drewsum/LED_Panel_Controller/README.md

# LED_Panel_Controller
Controls a single 64x64 HUB75E LED Panel
