drewsum/LED_Panel_Controller/hdw/LED_Panel_Controller/LED_Panel_Controller_bom_base.xlsx

Component | References | Value | Quantity Per PCB | Digi-Key PN | Configuration
1 | BT2101 | CR1616 | 1 | P034-ND | BACKUP_RTC
2 | BT2102 | CR1616_Holder | 1 | BU1632SM-JJ-GCT-ND | BACKUP_RTC
3 | C3301 | 15pF | 1 | 587-1949-1-ND | DNP
4 | C1509 C1510 | 47pF | 2 | 311-3783-1-ND | USB
5 | C201 C404 C604 | 10nF | 3 | 399-3066-1-ND
6 | C2201 C2202 | 10nF | 2 | 399-3066-1-ND | PUSH
7 | C202 C401 C405 C601 C605 C801 C802 C901 C902 C905 C907 C909 C910 C913 C915 C1001 C1002 C1003 C1101 C1302 C1505 C1508 C1805 C1806 C1901 C1902 C1903 C1904 C1905 C2001 C2002 C2003 C2004 C2301 C2303 C2304 C2305 C2306 C2307 C2308 C3201 C3202 C3203 | 0.1uF | 43 | 490-10698-1-ND
8 | C301 C302 C303 C501 C502 C503 C701 C702 C703 C1201 C1601 C1602 C1603 | 0.1uF | 13 | 490-10698-1-ND | Telemetry
9 | C1301 | 0.1uF | 1 | 490-10698-1-ND | DNP
10 | C1404 | 0.1uF | 1 | 490-10698-1-ND | ETC
11 | C1501 C1502 C1504 C1506 C1507 | 0.1uF | 5 | 490-10698-1-ND | USB
12 | C1701 C1703 C1705 | 0.1uF | 3 | 490-10698-1-ND | SD
13 | C1801 C1803 C1804 C2302 | 0.1uF | 4 | 490-10698-1-ND | Multidrop
14 | C2101 C2103 C2104 C2105 | 0.1uF | 4 | 490-10698-1-ND | BACKUP_RTC
15 | C2203 C2204 C2207 C2208 | 0.1uF | 4 | 490-10698-1-ND | PUSH
16 | C2401 C2402 C2501 C2502 C2601 C2602 C2701 C2702 C2801 C2802 C2901 C2902 C3001 C3002 C3101 C3102 | 0.1uF | 16 | 490-10698-1-ND | SPI_FLASH
17 | C403 C603 C903 C904 C906 C908 C911 C912 C914 C916 C1004 C1005 C1807 C1808 | 10uF | 14 | 1276-1451-1-ND
18 | C1401 C1402 C1403 | 10uF | 3 | 1276-1451-1-ND | ETC
19 | C1503 | 10uF | 1 | 1276-1451-1-ND | USB
20 | C1702 C1704 | 10uF | 2 | 1276-1451-1-ND | SD
21 | C1802 | 10uF | 1 | 1276-1451-1-ND | Multidrop
22 | C2102 | 10uF | 1 | 1276-1451-1-ND | BACKUP_RTC
23 | C2205 C2206 | 10uF | 2 | 1276-1451-1-ND | PUSH
24 | C402 C406 C407 C602 C606 C607 | 10uF | 6 | 399-8153-1-ND
25 | C203 C3302 | 100uF | 2 | 718-1102-1-ND
26 | D201 | 24V | 1 | SMAJ24CALFCT-ND | DNP
27 | D1401 | BAT48JFILM | 1 | 497-5711-1-ND | ETC
28 | D401 D601 | BAT48JFILM | 2 | 497-5711-1-ND
29 | D1701 | Green | 1 | 1497-1219-1-ND | SD
30 | D1901 D1902 D1903 D1905 D2001 D2301 D2303 D2304 D2305 D2306 D2307 D2308 | Green | 12 | 1497-1219-1-ND
31 | D2302 | Green | 1 | 1497-1219-1-ND | Multidrop
32 | D2401 D2501 D2601 D2701 D2801 D2901 D3001 D3101 | Green | 8 | 1497-1219-1-ND | SPI_FLASH
33 | D1904 D2002 D2003 D2004 | Red | 4 | 1497-1174-1-ND
34 | D1702 | SP0505BAJT | 1 | F3160CT-ND | SD
35 | D801 D3301 D3302 D3303 | SP0505BAJT | 4 | F3160CT-ND
36 | D1501 | Yellow | 1 | 1497-1198-1-ND | USB
50 | J1802 | Force SS | 1 |  | NONE
51 | J202 J203 | Keystone_8191 | 2 | 36-8191-ND | DNP
52 | J3302 | Keystone_8191 | 1 | 36-8191-ND
53 | J1701 | Micro_SD_Card_Det_Hirose_DM3AT | 1 | HR1964CT-ND | SD
54 | J1801 | Multidrop Expansion | 1 | 732-2096-ND | Multidrop
55 | J801 | PICKIT4 | 1 |  | DEV
56 | J1201 J1203 | PIC_UART | 2 |  | DNP
57 | J3301 | Panel Data | 1 | S9196-ND
58 | J1501 | USB_B_Mini | 1 | 732-2109-1-ND | USB
59 | J1204 J1205 J1206 | WIFI_SPI | 3 |  | DNP
60 | L401 L601 | 2.2uH | 2 | 541-1236-1-ND
61 | L801 L802 L901 L902 L1001 L1002 | 600R 0.5A | 6 | 490-5441-1-ND
62 | L1501 L1502 | 600R 0.5A | 2 | 490-5441-1-ND | USB
63 | L1701 | 600R 0.5A | 1 | 490-5441-1-ND | SD
64 | MK3403 MK3404 MK3407 MK3408 | Screw | 4 | 36-9900-ND | DEV
65 | MK3401 MK3402 MK3405 MK3406 | Standoff | 4 | 1772-1220-ND | DEV
66 | Q401 Q601 Q801 | BSS214NW | 3 | BSS214NWH6327XTSA1CT-ND
67 | Q402 Q602 | ZXMS6004FFTA | 2 | ZXMS6004FFCT-ND
68 | R1104 | 0 | 1 | RMCF0402ZT0R00CT-ND | Multidrop
69 | R209 R210 R211 R408 R409 R410 R608 R609 R610 R1512 R1513 R1514 | 0 | 12 | RMCF0402ZT0R00CT-ND | ~Telemetry
70 | R1813 | 0 | 1 | RMCF0402ZT0R00CT-N | MODULE0
71 | R1814 | 0 | 1 | RMCF0402ZT0R00CT-N | MODULE1
72 | R1815 | 0 | 1 | RMCF0402ZT0R00CT-N | MODULE2
73 | R1816 | 0 | 1 | RMCF0402ZT0R00CT-N | MODULE3
74 | R1817 | 0 | 1 | RMCF0402ZT0R00CT-N | MODULE4
75 | R402 R405 R605 | 0 | 3 | RMCF0402ZT0R00CT-ND
76 | R208 R407 R607 R1511 | 0.02 | 4 | P16010CT-ND | Telemetry
77 | R801 R803 R1003 R1004 R1702 R1709 R1710 R1711 R2409 R2509 R2609 R2709 R2809 R2909 R3009 R3109 R3201 R3202 R3203 R3204 R3205 R3206 R3207 R3208 R3209 R3210 R3211 R3212 R3213 R3214 R3249 R3250 R3251 R3252 R3253 R3254 R3255 R3256 R3257 R3258 R3259 R3260 R3261 R3262 | 10 | 44 | RMCF0402FT10R0CT-ND
78 | R207 R213 R406 R411 R606 R611 R1202 R1510 R1517 | 10 | 9 | RMCF0402FT10R0CT-ND | Telemetry
79 | R1204 R2402 R2403 R2404 R2502 R2503 R2504 R2602 R2603 R2604 R2702 R2703 R2704 R2802 R2803 R2804 R2902 R2903 R2904 R3002 R3003 R3004 R3102 R3103 R3104 | 10 | 25 | RMCF0402FT10R0CT-ND | SPI_FLASH
80 | R1206 | 10 | 1 | RMCF0402FT10R0CT-ND | ETC
81 | R1208 | 10 | 1 | RMCF0402FT10R0CT-ND | Multidrop
82 | R1210 | 10 | 1 | RMCF0402FT10R0CT-ND | BACKUP_RTC
83 | R1515 R1516 | 27 | 2 | RMCF0402FT27R0CT-ND | USB
84 | R1809 R1810 R1811 R1812 | 120 | 4 | RMCF0402FT120RCT-ND | Term
85 | R1501 | 1k | 1 | RMCF0402FT1K00CT-ND | USB
86 | R1701 | 1k | 1 | RMCF0402FT1K00CT-ND | SD
87 | R204 R215 R216 R217 R805 R1902 R1903 R1904 R1905 R1906 R2003 R2004 R2007 R2008 R2304 R2306 R2310 R2311 R2312 R2315 R2316 | 1k | 21 | RMCF0402FT1K00CT-ND
88 | R2201 R2202 R2203 R2204 | 1k | 4 | RMCF0402FT1K00CT-ND | PUSH
89 | R2305 | 1k | 1 | RMCF0402FT1K00CT-ND | Multidrop
90 | R2401 R2501 R2601 R2701 R2801 R2901 R3001 R3101 | 1k | 8 | RMCF0402FT1K00CT-ND | SPI_FLASH
91 | R1503 | 6.04k | 1 | RMCF0402FT6K04CT-ND | USB
92 | R202 R205 R206 R212 R218 R219 R220 R221 R401 R403 R404 R601 R602 R603 R604 R802 R804 R1001 R1002 R1005 R1006 R1101 R1102 R1103 R1201 R1203 R1205 R1207 R1209 R1703 R1704 R1705 R1706 R1707 R1708 R1801 R1802 R1803 R1804 R1805 R1806 R1807 R1808 R1818 R1901 R2001 R2002 R2005 R2006 R2103 R2209 R2210 R2301 R2302 R2303 R2307 R2308 R2309 R2313 R2314 R2408 R2508 R2608 R2708 R2808 R2908 R3008 R3108 R3215 R3216 R3217 R3218 R3219 R3220 R3221 R3222 R3223 R3224 R3225 R3226 R3227 R3228 R3229 R3230 R3231 R3232 R3233 R3234 R3235 R3236 R3237 R3238 R3239 R3240 R3241 R3242 R3243 R3244 R3245 R3246 R3247 R3248 | 10k | 102 | RMCF0402FT10K0CT-ND
93 | R1507 | 10k | 1 | RMCF0402FT10K0CT-ND | USB
94 | R214 | 10k | 1 | RMCF0402FT10K0CT-ND | DNP
95 | R2205 R2206 R2207 R2208 | 10k | 4 | RMCF0402FT10K0CT-ND | PUSH
96 | R2405 R2406 R2407 R2505 R2506 R2507 R2605 R2606 R2607 R2705 R2706 R2707 R2805 R2806 R2807 R2905 R2906 R2907 R3005 R3006 R3007 R3105 R3106 R3107 | 10k | 24 | RMCF0402FT10K0CT-ND | SPI_FLASH
97 | R1504 | 40.2k | 1 | RMCF0402FT40K2CT-ND | USB
98 | R201 R203 R1505 R1506 R1508 R1509 | 100k | 6 | RMCF0402FT100KCT-ND
99 | R413 R613 | 180k | 2 | RMCF0402FT180KCT-ND | DNP
100 | R2102 | 220k | 1 | RMCF0402FT220KCT-ND | BACKUP_RTC
101 | R1502 | 487k | 1 | RMCF0402FT487KCT-ND | USB
102 | R412 | 562k | 1 | RMCF0402FT562KCT-ND | DNP
103 | R612 | 953k | 1 | RMCF0402FT953KCT-ND | DNP
104 | R2101 | 1.07M | 1 | RMCF0402FT1M07CT-ND | BACKUP_RTC
106 | SW801 | MRST | 1
107 | U3202 U3203 | 74HCT541 | 2 | 296-26499-1-ND
108 | U1001 | 74LVC1G97 | 1 | 1727-1772-1-ND
109 | U401 U601 U1102 | 74LVC1G97 | 3 | 1727-1772-1-ND
110 | U1701 | 74LVC1G97 | 1 | 1727-1772-1-ND | SD
111 | U1702 | 74LVC1G97 | 1 | 1727-1772-1-ND | SD
112 | U1803 | 74LVC1G97 | 1 | 1727-1772-1-ND | Multidrop
113 | U1804 U2302 | 74LVC1G97 | 2 | 1727-1772-1-ND | Multidrop
114 | U1901 U1902 U1903 U1905 | 74LVC1G97 | 4 | 1727-1772-1-ND
115 | U1904 | 74LVC1G97 | 1 | 1727-1772-1-ND
116 | U2001 U2002 U2003 U2004 U2301 U2303 U2304 U2305 U2306 U2307 U2308 | 74LVC1G97 | 11 | 1727-1772-1-ND
117 | U2203 U2204 | 74LVC1G97 | 2 | 1727-1772-1-ND | PUSH
118 | U2401 U2501 U2601 U2701 U2801 U2901 U3001 U3101 | 74LVC1G97 | 8 | 1727-1772-1-ND | SPI_FLASH
119 | U3201 | 74LVC1G97 | 1 | 1727-1772-1-ND
120 | U1302 | AT24CS32-STUM | 1 | AT24CS32-STUM-T
121 | U2201 U2202 | AT42QT1010-TSHR | 2 | AT42QT1010-TSHRCT-ND | PUSH
122 | U1401 | DS1683 | 1 | DS1683S+-ND | ETC
123 | U2101 | DS3231MZ | 1 | DS3231MZ+-ND | BACKUP_RTC
124 | U1502 | FT234XD | 1 | 768-1178-1-ND | USB
125 | U301 U501 U701 U1601 | INA219BxDCN | 4 | 296-46420-1-ND | Telemetry
126 | U1301 | LTC1694 | 1 | LTC1694CS5#TRPBFCT-ND | DNP
127 | U302 U502 U702 U1201 U1602 | MCP9804 | 5 | MCP9804T-E/MCCT-ND | Telemetry
128 | U1101 | PIC32MZ2048EFG100_IPF | 1 | PIC32MZ2048EFG100-I/PF-ND
129 | U1801 U1802 | SN65MLVD3 | 2 | 296-21314-1-ND | Multidrop
130 | U2402 U2502 U2602 U2702 U2802 U2902 U3002 U3102 | SST25VF080B | 8 | SST25VF080B-50-4I-S2AE-T | SPI_FLASH
131 | U1805 | THVD1552 | 1 | 296-51654-1-ND | Multidrop
132 | U1501 | TLV6700 | 1 | 296-51696-1-ND | USB
133 | U2102 | TLV6700 | 1 | 296-51696-1-ND | BACKUP_RTC
134 | U1504 | TPD3S014DBVR | 1 | 296-38835-1-ND | USB
135 | U201 | TPS26600RHFT | 1 | 296-45478-1-ND
136 | U402 | TPS62132 | 1 | 296-29936-1-ND
137 | U602 | TPS62133 | 1 | 296-30225-1-ND
138 | U1503 | TXB0102DCU | 1 | 296-22862-1-ND
139 | X1001 | ASE-8.000MHz | 1 | 535-9558-1-ND
140 | X1002 | ECS-327KE | 1 | XC1751CT-ND
Component Groups:
Component Count:
Fitted Components:
Number of PCBs:
Total components:
Schematic Version:
Schematic Date:
PCB Variant:
BoM Date:
Schematic Source:
KiCad Version:
