drewsum/LED_Panel_Controller/(threads)

Thread 3 (2020-09-08):

Add SD card slot? To add arbitrary number of images?

drewsum, 2020-09-08:

drewsum, 2020-09-16:
Some dude bro bascially already figured this out for us:

https://www.aidanmocke.com/blog/2018/09/04/spi-fatfs/
https://www.aidanmocke.com/blog/2018/09/01/spi-sd/
https://www.aidanmocke.com/blog/2019/01/09/DMA-SD/

drewsum, 2020-09-20:
http://ww1.microchip.com/downloads/en/Appnotes/00002587A.pdf

Closed 2020-09-21.

Thread 4 (2020-09-09):

Input EMI filter?

drewsum, 2020-09-09:

logwai, 2020-09-13:
yes we hate emi

Closed 2020-09-21.

Thread 5 (2020-09-10):

Use CP2105 USB to DUART bridge instead of FT234X?

drewsum, 2020-09-10:
This would allow us to talk to both the MCU and the ATWINC wifi module over one USB cable, but this is riskier

drewsum, 2020-09-21:
Yo log give both these chips a lookover. FT234X is what we used on senior design and is what I've used ever since. We potentially have two devices on this board that could talk with a host PC (PIC32MZ MCU, and ATWINC1500 WiFi module). The CP2105 is pretty much the same as the FT234X, but you can talk with two devices through one USB port (FT234 can only talk with one). This way, we could communicate with both devices over one USB cable at the same time. This is riskier since I've never used this chip before, but we could figure it out I think. Downside is if something goes wrong, we may not be able to communicate with any devices (would warrant a board respin since a lot of this project revolves on functioning USB communication).

Look these chips over and lmk what you think. If we end up going with this, I'll make the symbol and you can draw the circuit.

drewsum, 2020-10-04:
This is pretty much drawn, but we need to look into level shifting/UART buffering

Closed 2021-02-01.

Thread 10 (2020-09-21):

Finish Panel Data Level Shifter sheet

drewsum, 2020-09-21:
We should add the nets to the level shifter sheet to connect the level shifter to both the PIC and the LED panel connector. If you look at my branch (drew_brach), you should be able to see the net naming convention for all the signals that go to the panel connector. The nets to the "right" of the level shifter should match the nets on the connector sheet, and the nets to the "left" (before level shifting) should be the same name, without the "_POS5" ending (I would say either make the names match without *_POS5 ending, or make them match with a *_POS3P3 ending since these nets will be at a +3.3V logic level). We did something similar in senior design.

It doesn't really matter which signals go where since we may re-arrange them when we're laying out the board to optimize signal flow. As long as we have a good representation of the six RGB signals, the five ROW signals, and CLK, ~OE, and LAT, we're good.

drewsum, 2020-09-21:
also consider adding pulldown resistor array on the output nets of the level shifter that matches input signals. This may not be necessary since as long as the level shifter is enabled, the signals won't float. Having pulldowns on the output would be good design practice though.

Closed 2021-02-01.

Thread 12 (2020-09-21):

Schematic Wrap up

drewsum, 2020-09-21:
This issue serves as a reminder for everything we'll have to do to transition from schematic work to actually laying out the PCB.

We need to:
* Decide on passive component sizes (0603? 0402?)/Assign these attributes to all components
* Determine if we want to optimize BOM or just throw a ton of unique parts on the board
* Ensure schematic sheets are in the right order
* Assign references designators to all components
* Assign Digi-Key PN's
* Assign component footprints/download/create custom footprints
* Electrical rules check
* Assign I2C addresses for devices with adjustable addressing
* Generate netlist

Closed 2021-02-01.

Thread 7 (2020-09-21):

Draw WiFi module sheet

drewsum, 2020-09-21:
I'll make a symbol for the ATWINC1500, and you can draw the circuit around it if you'd like. SPI/UART interface.

http://ww1.microchip.com/downloads/en/DeviceDoc/ATWINC15x0-MR210xB-IEEE-802.11-b-g-n-SmartConnect-IoT-Module-Data-Sheet-DS70005304C.pdf

https://www.microchip.com/wwwAppNotes/AppNotes.aspx?appnote=en609327

Closed 2021-02-01.

Thread 9 (2020-09-21):

Determine PIC32MZ SKU, determine I/O pin mappings

drewsum, 2020-09-21:
We need to determine which exact PIC32MZ part we'll use (pin count, memory size, speed grade). Once this is added to the schematic, we should determine which signals will go to which pins, and how peripheral pin select (PPS) will be mapped. Certain peripherals/SPI ports/I2C/UART/whatever will go to certain pins, and we could optimize that based on layout or where signals would naturally want to go.

drewsum, 2020-09-21:
We also need to ensure that the nOE signal that goes to the panel is driven from a PWM pin on the PIC, to allow us to dim the panel using PWM

Closed 2021-02-01.

Thread 16 (2021-02-01):

Hardware Ideas

drewsum, 2021-02-01:
* ~~include panel control signals in PMP bus if possible to try to further integrate functionality into DMA~~
* ~~Make as much complex functionality hardstrap configurable to gut it when building a ton of these~~
* ~~These can probably be put into larger arrays and controlled with python through USB, or through WiFi~~
* ~~Add an easier way of connecting +12V than a barrel jack, since you can use 12V power supplies in arrays~~
* ~~Add notes for each PPS/Peripheral pin mapping on PIC32MZ sheet~~
* ~~Try to BOM scrub as much as possible for ease of PNP assembly~~
* ~~These will need a faster serial baud rate over USB. Make sure the hardware you chose can support this, along with PutTy~~
* ~~Add test points for all serial busses, there are a lot of them~~
* ~~Add WiFi slave select LEDs~~
* ~~Add a small I2C eeprom to store random NVM configuration data~~
* ~~Add LED driven off ATWINC1500 GPIO to prove it's talking with host~~
* ~~Add a pullup on WIFI_IRQ since this is active low. Keep a pull in both directions, just depop pull down~~
* ~~Consider switching back to a 200MHz FOSC PIC32MZ SKU, since this is way more applicable and probably cheaper than the 252MHz SKUs~~
* ~~Add LED drivers for various features being activated, like SD card slave select, etc~~
* ~~Add ambient temperature sensor~~

drewsum, 2021-03-25:
* Add OSEP FTDI 01 headers for PIC UART and WIFI UART like on pulse oxymieter? This would drive up complexity, and I'm not sure of the cost savings anyway, since CP2105 is really cheap

drewsum, 2021-03-30:
* Add hardware debouncing on SD card detection

drewsum, 2021-03-30:
* Consider MRAM instead of SPI flash
https://www.digikey.com/en/products/detail/everspin-technologies-inc/MR256A08BYS35/2665198

drewsum, 2021-03-31:
* Try to eliminate 100 ohm resistors

Closed 2021-05-04.

Thread 17 (2021-02-02):

Schematic Review

drewsum, 2021-02-02:
Check pinout and footprint on:
* ~~PIC~~
* ~~CP2105~~
* ~~UART level shifter~~
* ~~SD card socket~~
* ~~WIFI module~~
* ~~SPI flash~~
* ~~Panel level shifters~~
* ~~Panel connector~~

drewsum, 2021-02-02:
Do a sanity check on the following sheets:
* WiFi module
* USB UART bridge
* SPI Flash
* PIC32MZ, bypass
* SD Card Slot
* Panel Level Shifters
* Panel Connector

drewsum, 2021-02-05:
Verify PMP write signal is correct on PIC32MZ

drewsum, 2021-03-05:
Need to add an OR gate with PWM dimming signal/normal OE signal. Look at older project

drewsum, 2021-03-31:
* Verify MCLR voltage during programming for ESD protection diodes

drewsum, 2021-04-01:
* change to pullups on all SPI flash signald

Closed 2021-05-04.

Thread 18 (2021-05-07):

Adjust power supply layout with GND shielding around switch node

drewsum, 2021-05-07:
* Add some GND flood on top layer around switch node, and add vias to GND plane. This should mitigate EMI

Closed 2021-06-11.

Thread 20 (2021-05-08):

Panels (matches legacy project)

drewsum, 2021-05-08:
Use these, this is what was used for senior design: https://www.aliexpress.com/item/32830509434.html?spm=2114.10010108.1000023.5.4dcb3853xRdJUH

drewsum, 2021-05-08:
This should match the cutout locations in the PCB for the power header

Thread 23 (2021-08-13):

ECOs/Gotchas

drewsum, 2021-08-13:
* LED Panel Signal Level Shifter had shift enable signal left floating from MCU... had to be shorted to ground to send signals from MCU to panel
* I2C EEPROM (U1302) was replaced with 24AA02UIDT-I/OT for availability reasons
