drewsum/LED_Panel_Controller/hdw/LED_Panel_Controller/LED_Panel_Controller.pdf

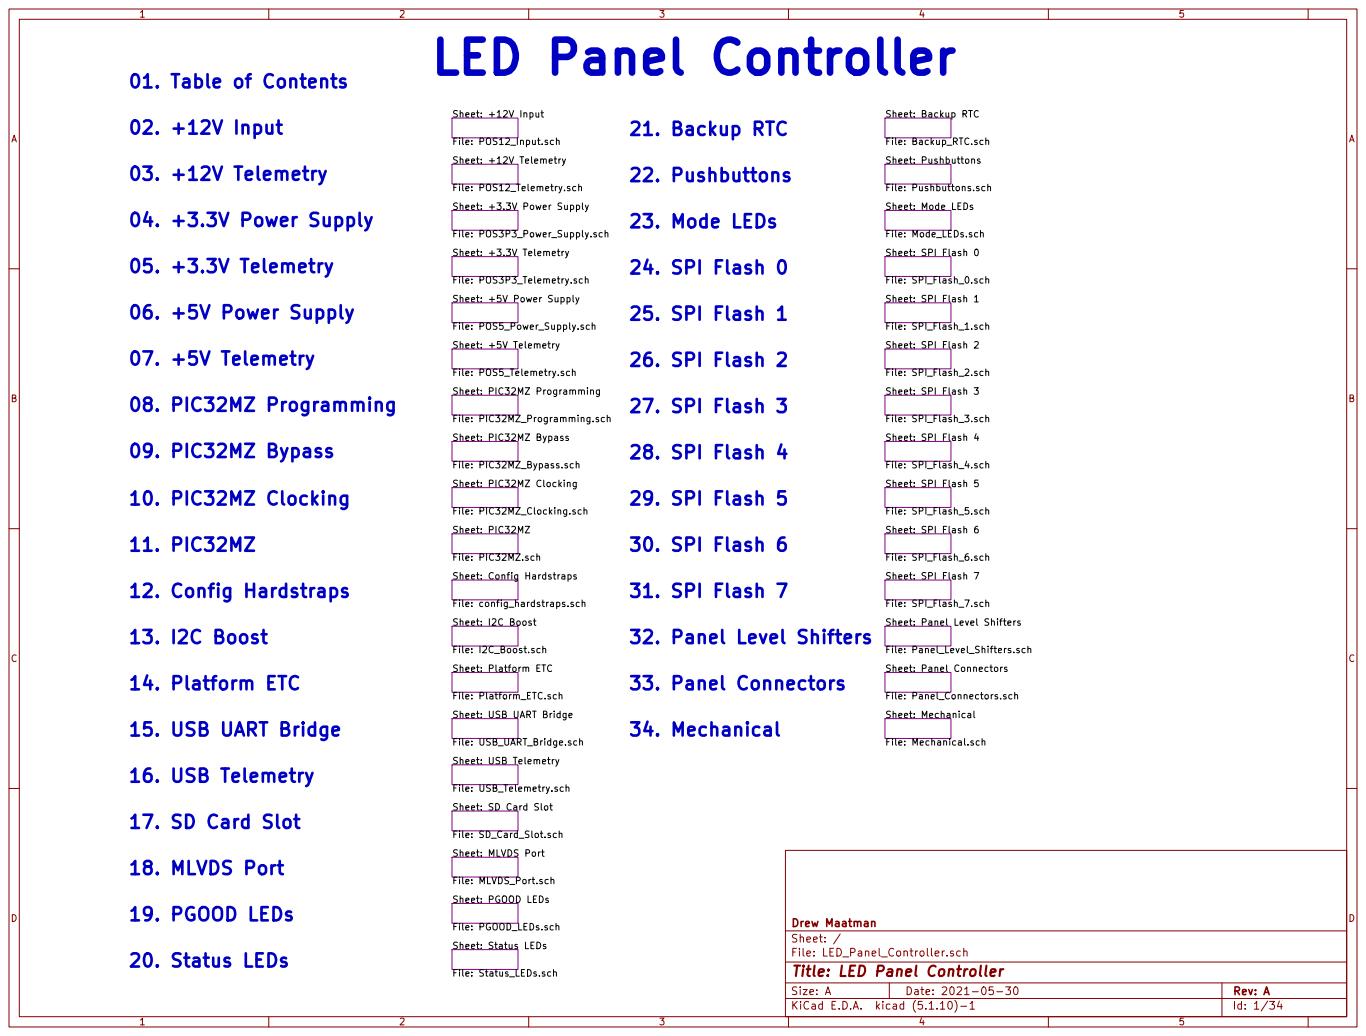
[picture p1: page 1]

Sheet: +12V Input
File: POS5_Power_Supply.sch Sheet: I2C Boost File: I2C_Boost.sch Sheet: Platform ETC
Sheet: +5V Telemetry

File: PIC32MZ_Bypass.sch
Sheet: SPI Flash 5 File: SPI_Flash_5.sch Sheet: Status LEDs File: Status_LEDs.sch

File: PIC32MZ.sch Sheet: PIC32MZ Clocking

File: Platform_ETC.sch Sheet: USB UART Bridge

File: USB_UART_Bridge.sch
Sheet: PGOOD LEDs File: PGOOD_LEDs.sch Sheet: USB Telemetry

File: USB_Telemetry.sch Sheet: SD Card Slot File: SD_Card_Slot.sch 16. USB Telemetry

File: LED_Panel_Controller.sch Sheet: / Drew Maatman

Id: 1/34 Title: LED Panel Controller

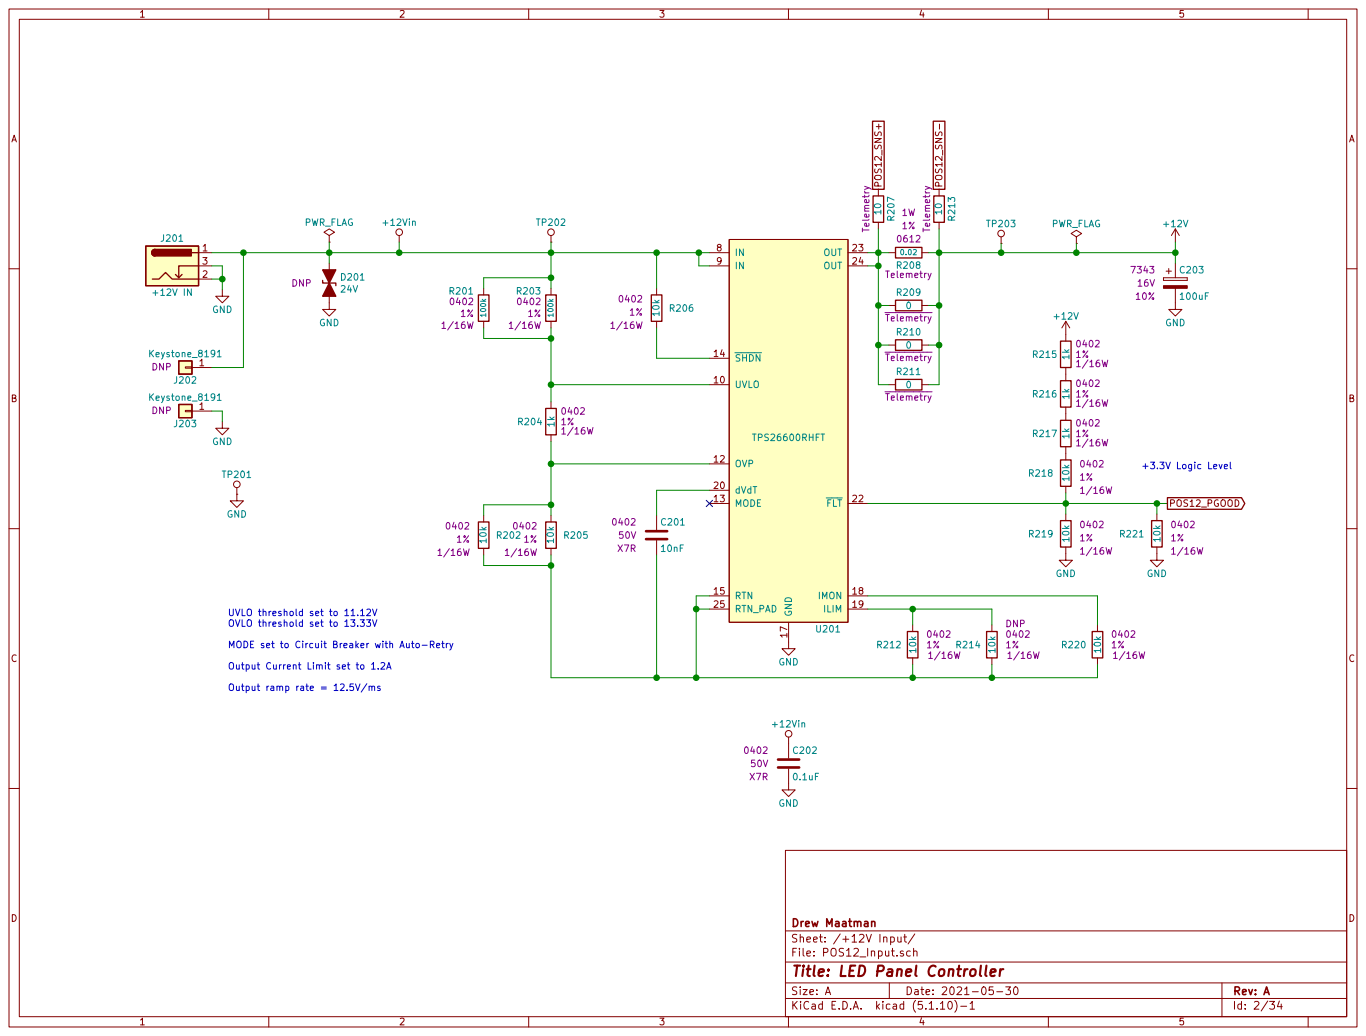
[picture p2: page 2]

+3.3V Logic Level UVLO threshold set to 11.12V OVLO threshold set to 13.33V MODE set to Circuit Breaker with Auto-Retry

Output Current Limit set to 1.2A

Output ramp rate = 12.5V/ms

File: POS12_Input.sch
Id: 2/34 Title: LED Panel Controller

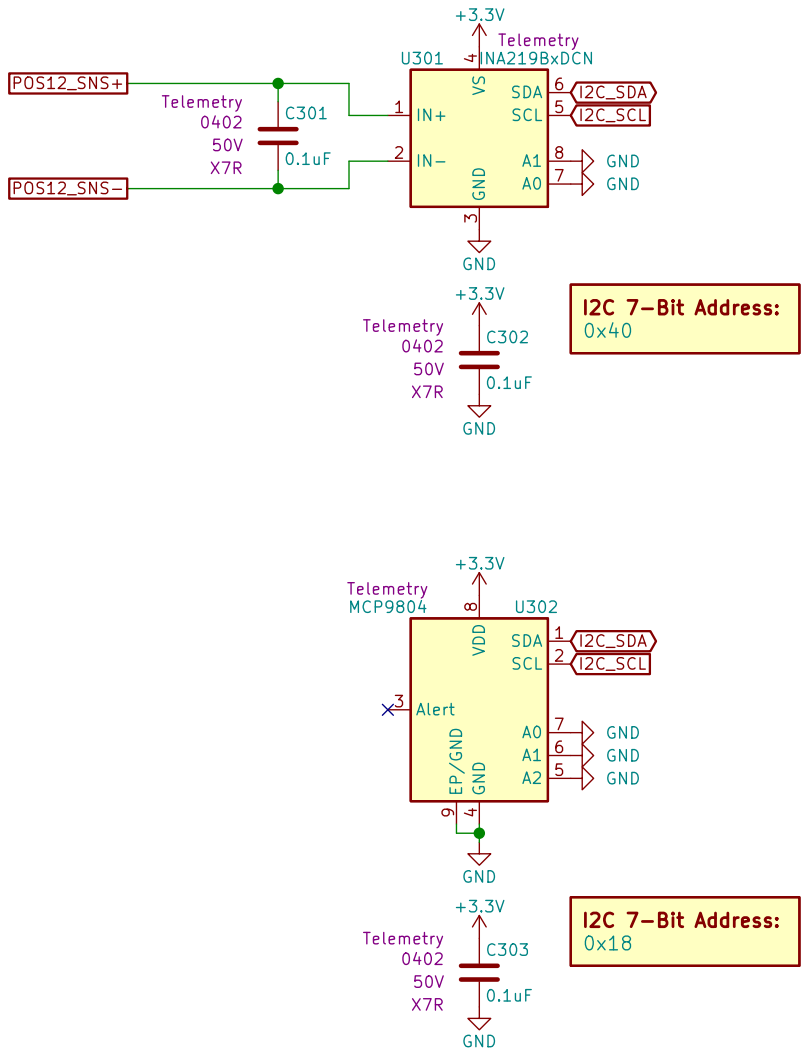
[picture p3: page 3]

Sheet: /+12V Telemetry/ Drew Maatman

File: POS12_Telemetry.sch
Id: 3/34 Title: LED Panel Controller

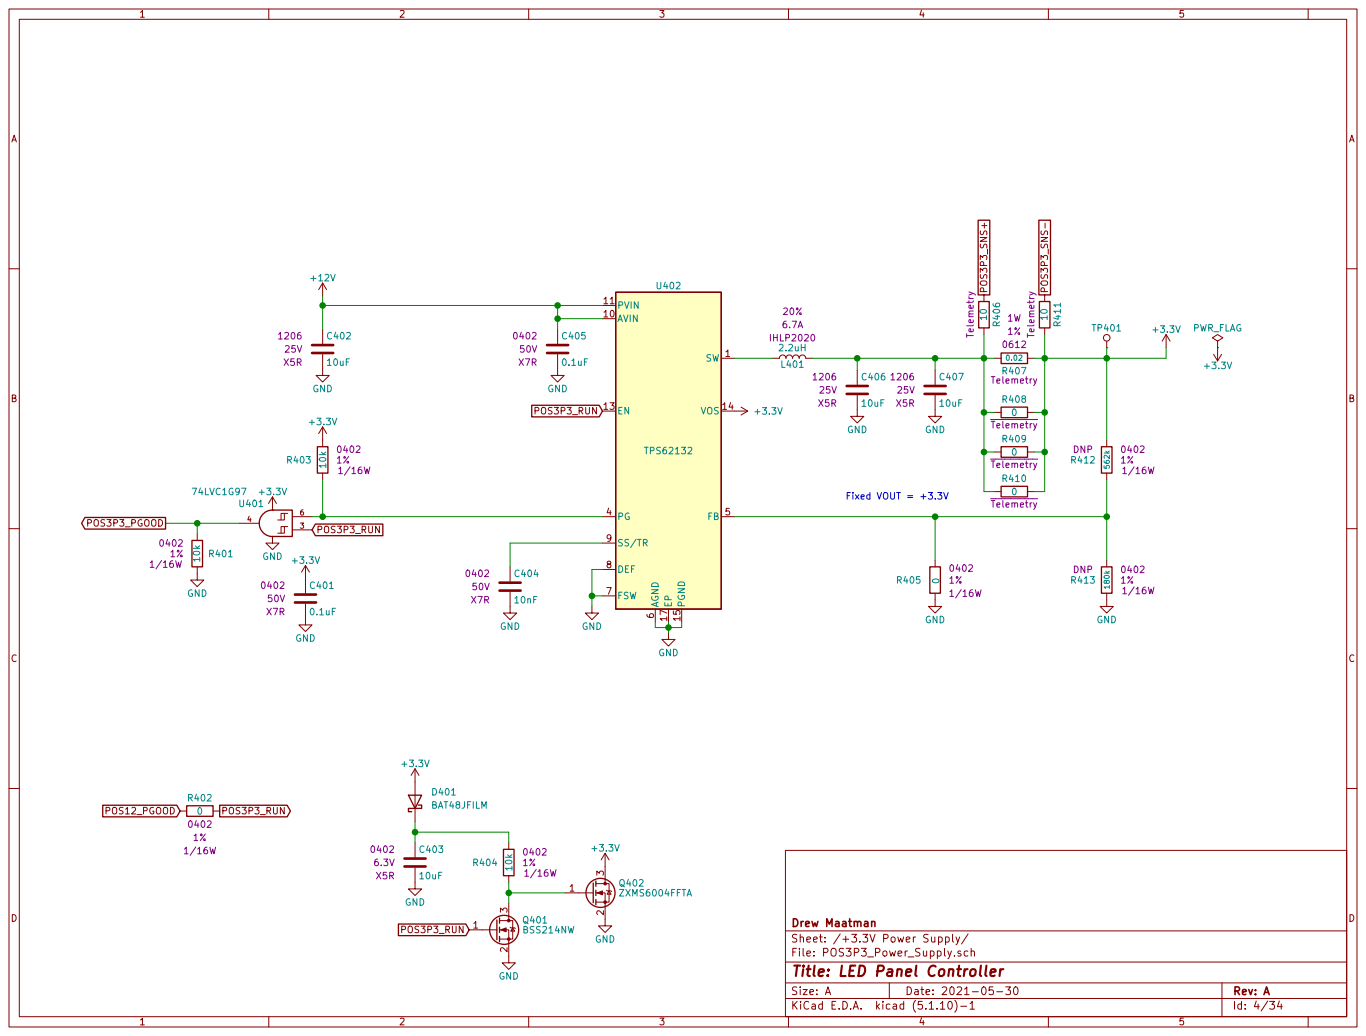
[picture p4: page 4]

6 FSW 7 DEF 8 SS/TR 9 U402 TPS62132 C403 +3.3V

0 Telemetry GND GND GND

File: POS3P3_Power_Supply.sch
Id: 4/34 Title: LED Panel Controller

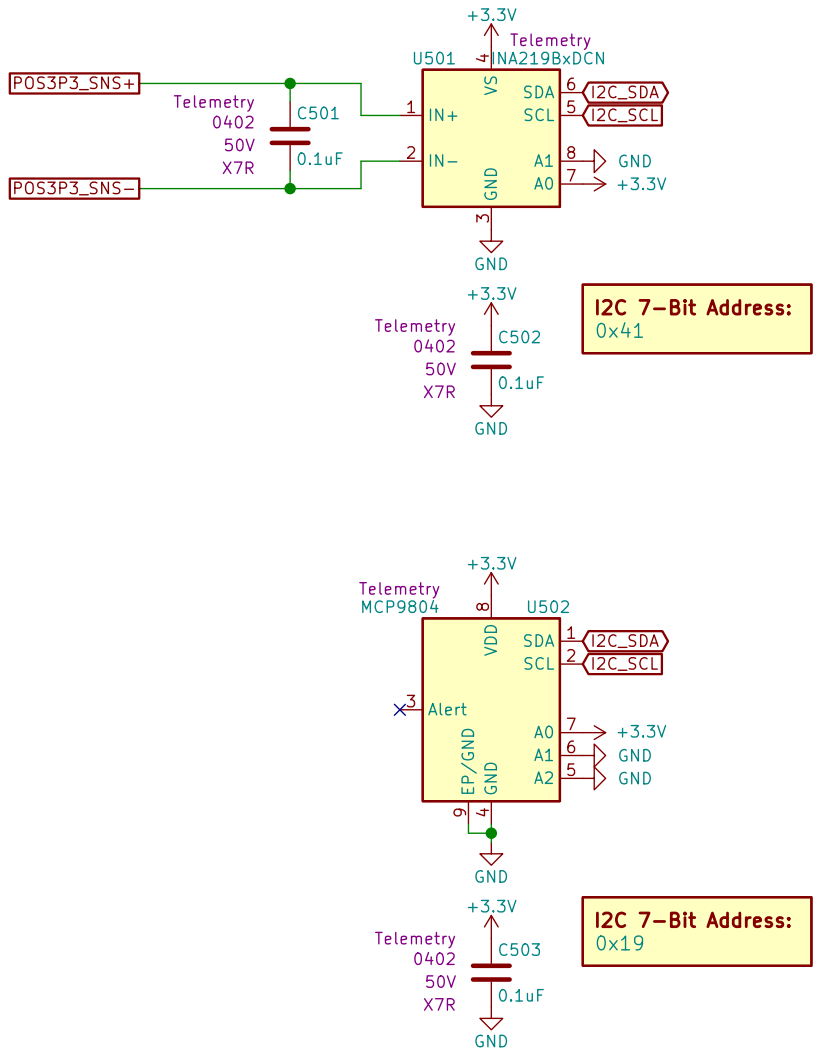
[picture p5: page 5]

Sheet: /+3.3V Telemetry/ Drew Maatman

File: POS3P3_Telemetry.sch
Id: 5/34 Title: LED Panel Controller

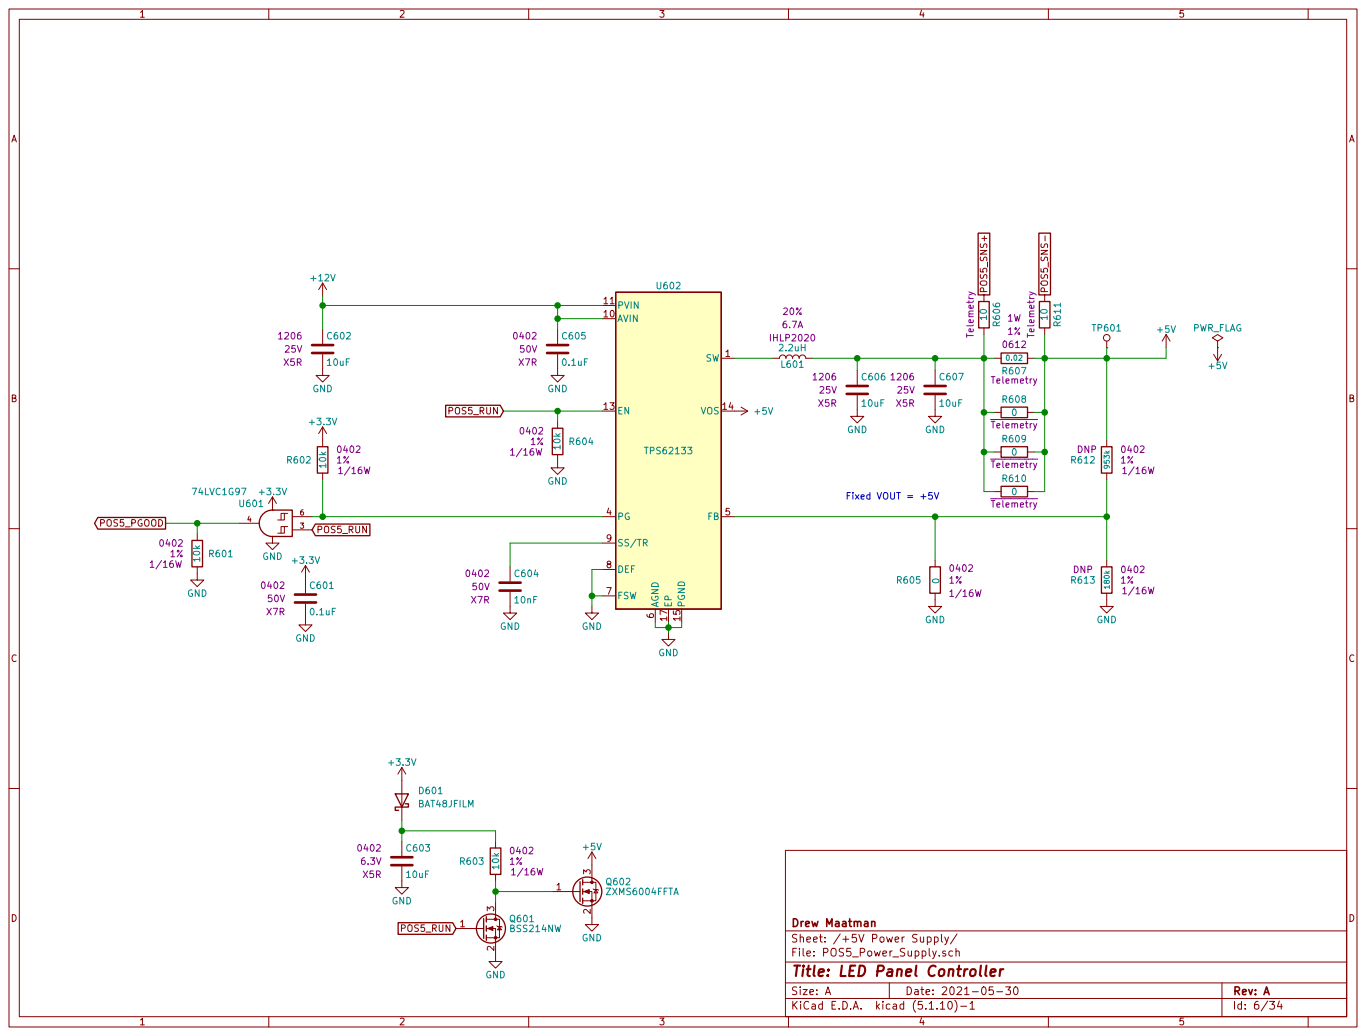
[picture p6: page 6]

6 FSW 7 DEF 8 SS/TR 9 U602 TPS62133 R612 953k0402

Sheet: /+5V Power Supply/ Drew Maatman

File: POS5_Power_Supply.sch
Id: 6/34 Title: LED Panel Controller

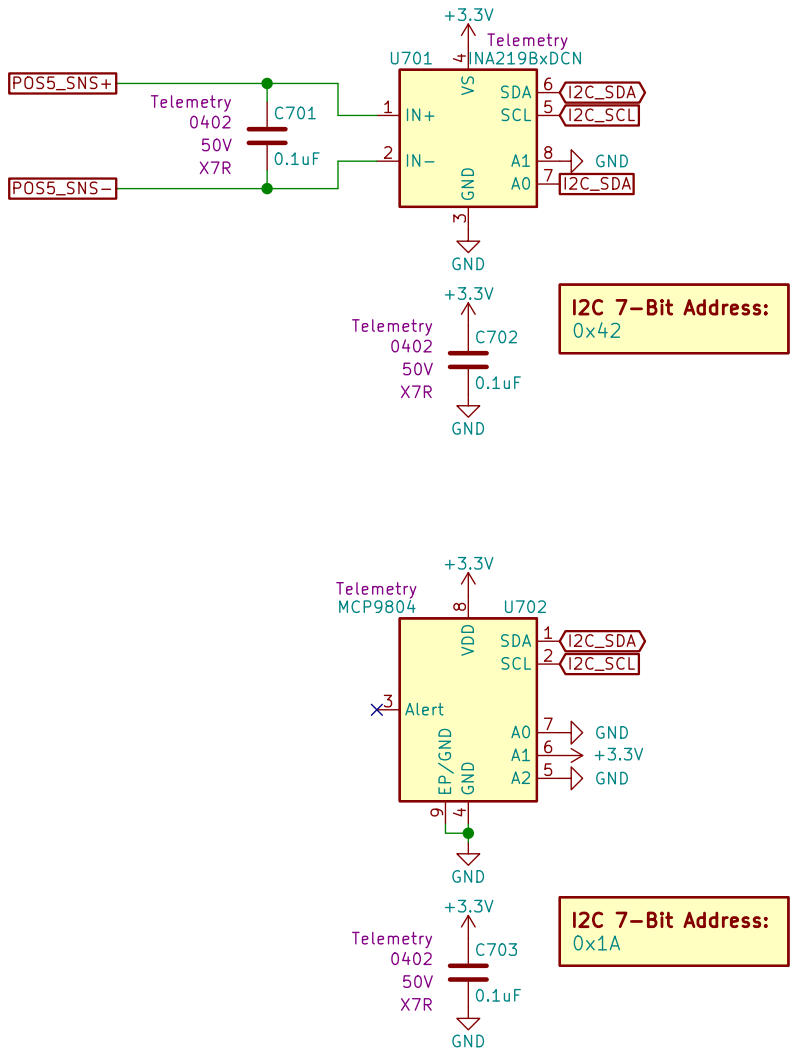
[picture p7: page 7]

Sheet: /+5V Telemetry/ Drew Maatman GND

File: POS5_Telemetry.sch
Id: 7/34 Title: LED Panel Controller

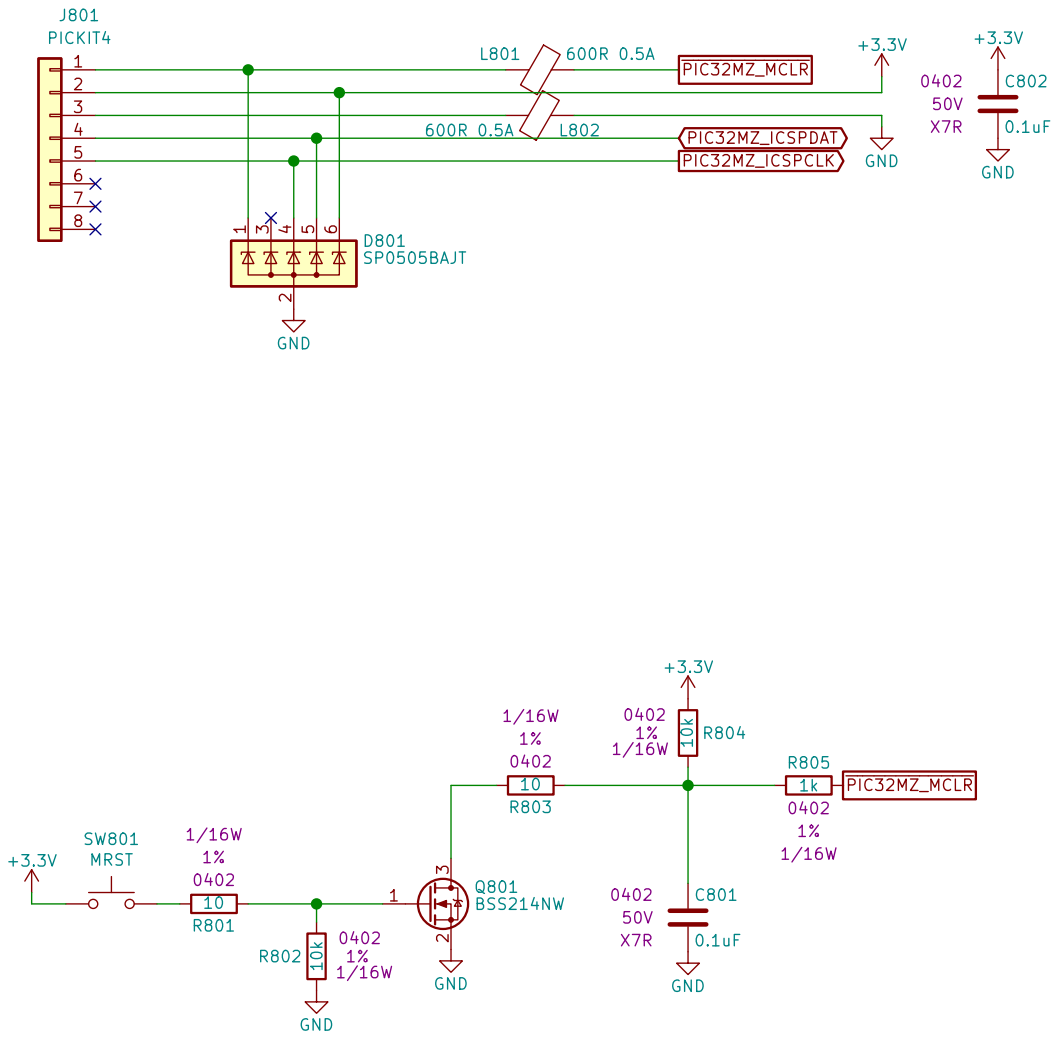
[picture p8: page 8]

Sheet: /PIC32MZ Programming/ Drew Maatman GND

File: PIC32MZ_Programming.sch
Id: 8/34 Title: LED Panel Controller

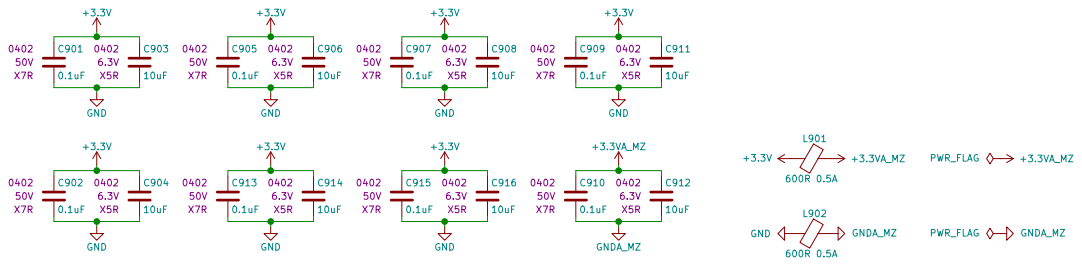
[picture p9: page 9]

Sheet: /PIC32MZ Bypass/ Drew Maatman

File: PIC32MZ_Bypass.sch
Id: 9/34 Title: LED Panel Controller

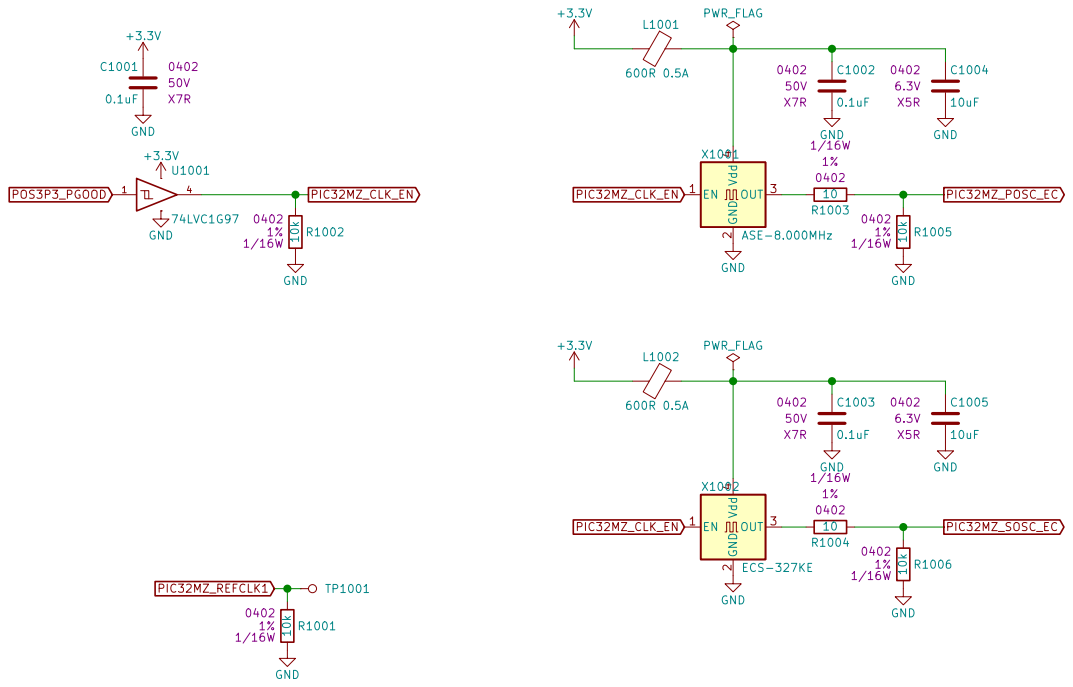
[picture p10: page 10]

2 OUT 3 Vdd X10014 ASE-8.000MHz EN 1 GND

File: PIC32MZ_Clocking.sch
Id: 10/34 Title: LED Panel Controller

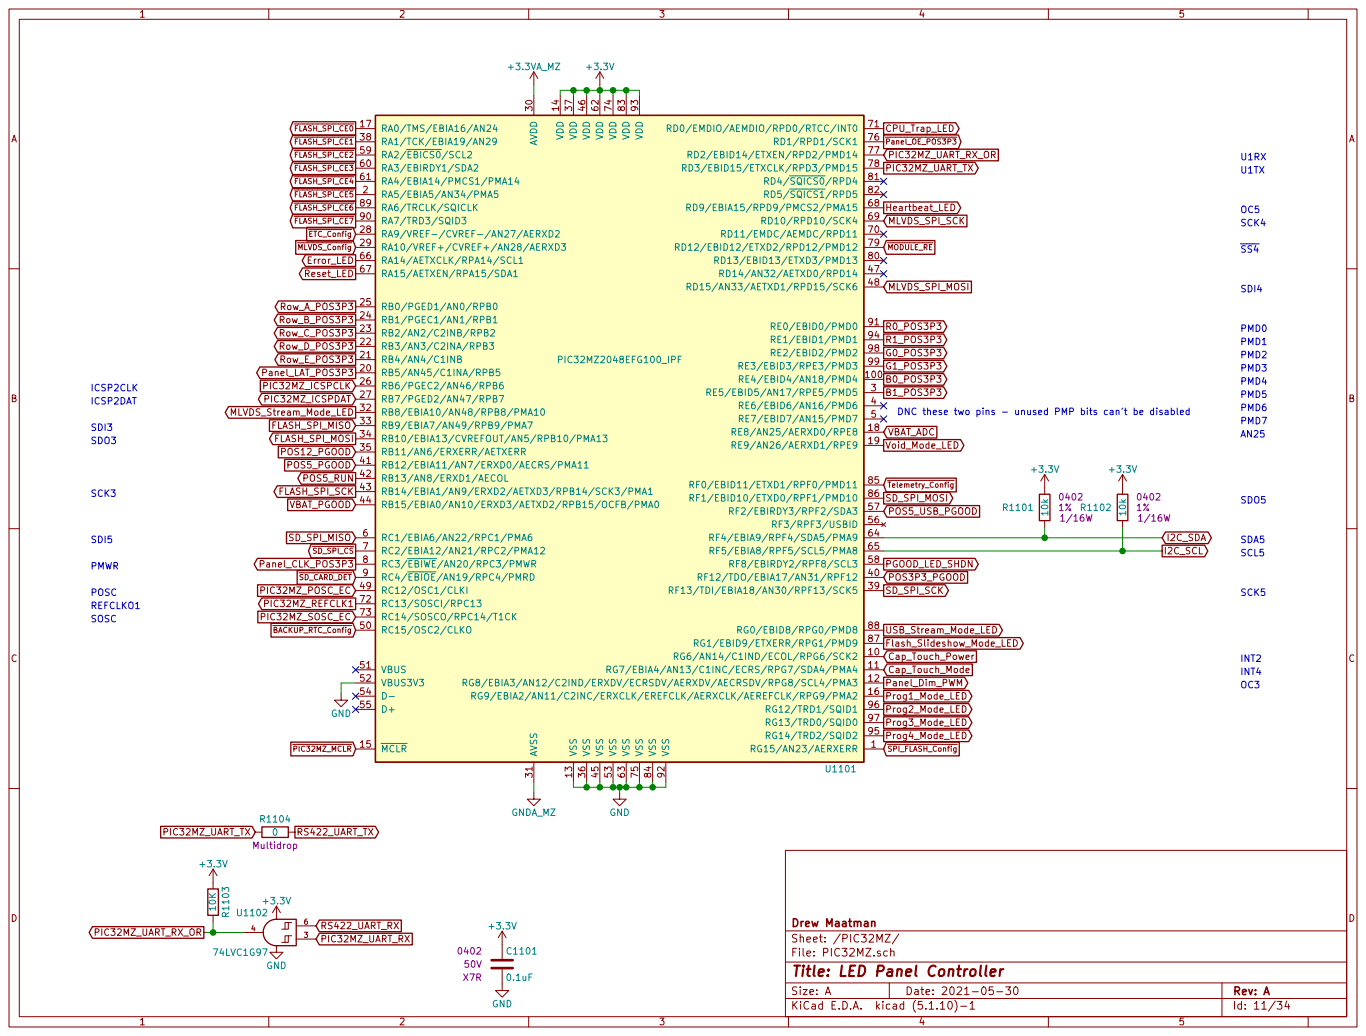
[picture p11: page 11]

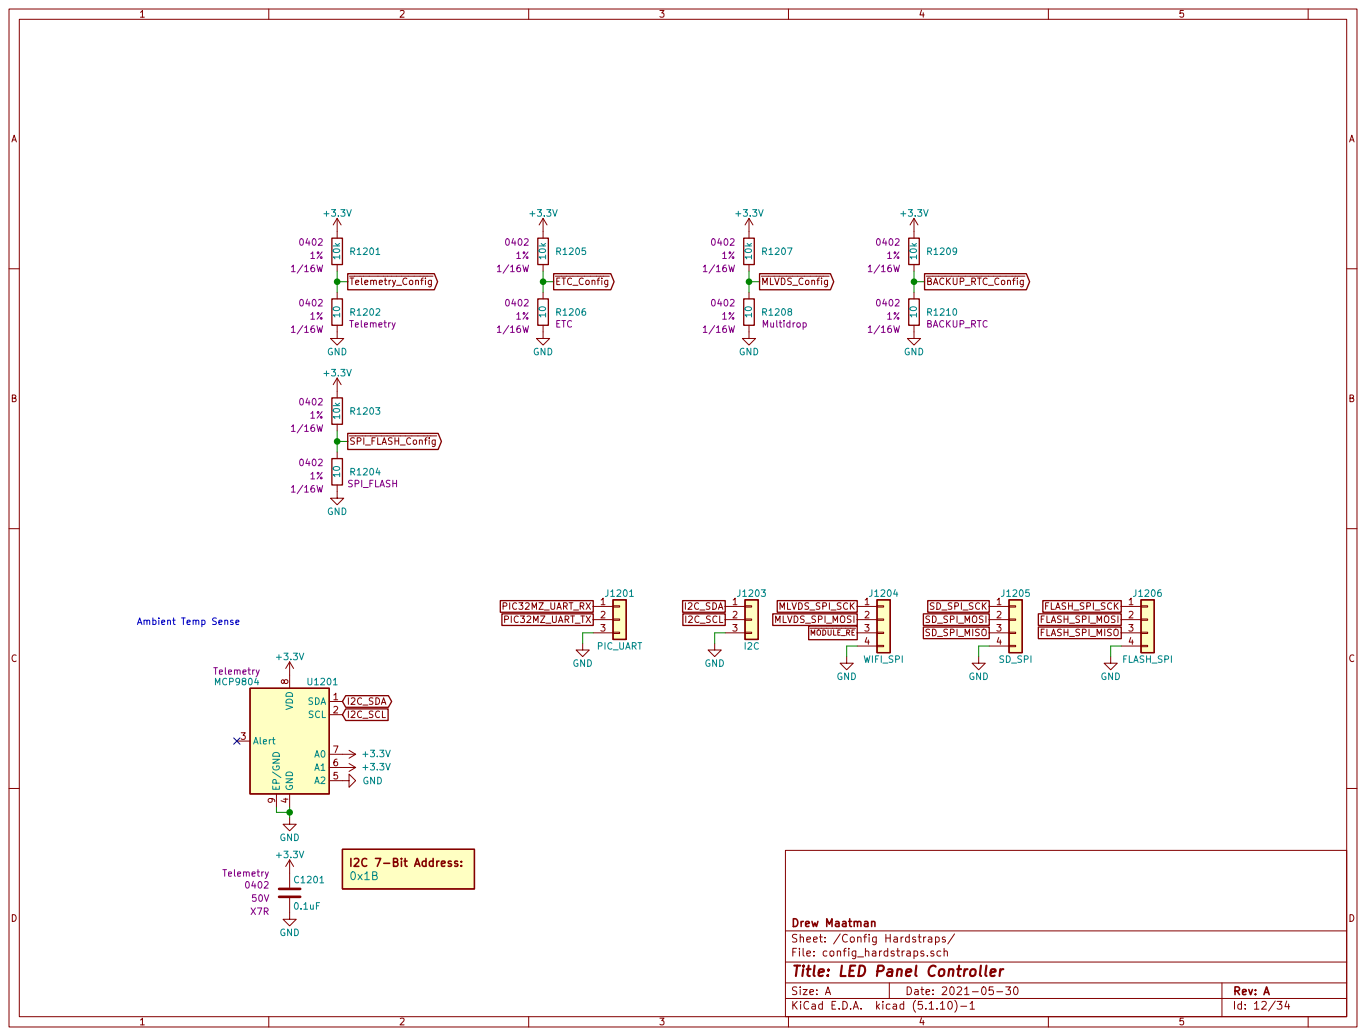
[picture p12: page 12]

Sheet: /Config Hardstraps/ Drew Maatman

File: config_hardstraps.sch
Id: 12/34 Title: LED Panel Controller

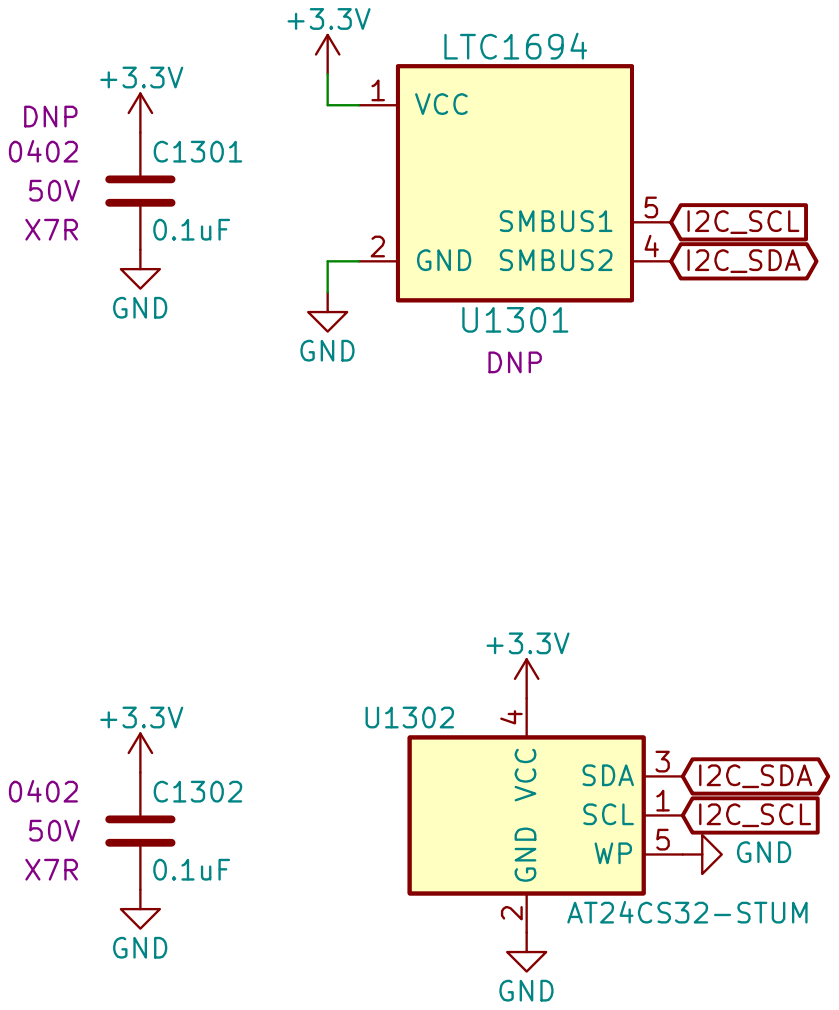
[picture p13: page 13]

File: I2C_Boost.sch Sheet: /I2C Boost/ Drew Maatman

Id: 13/34 Title: LED Panel Controller

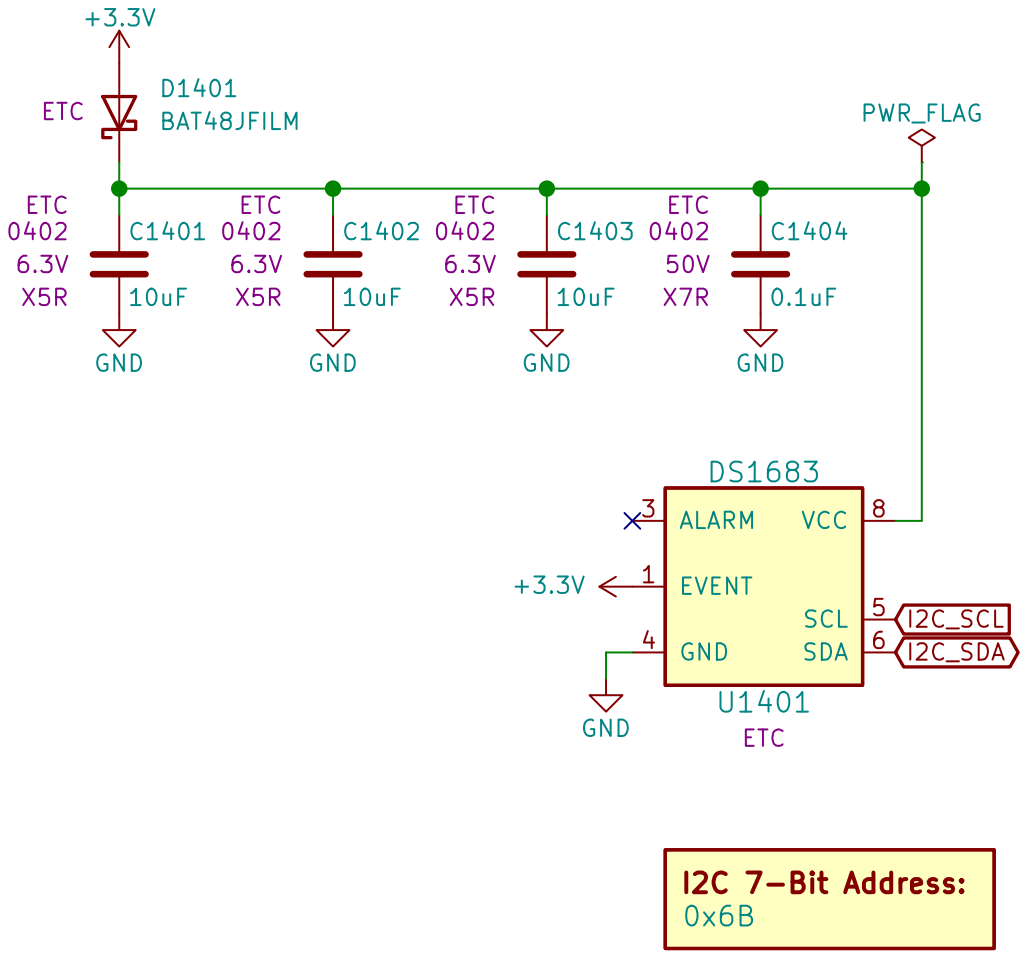
[picture p14: page 14]

File: Platform_ETC.sch Sheet: /Platform ETC/ Drew Maatman

Id: 14/34 Title: LED Panel Controller

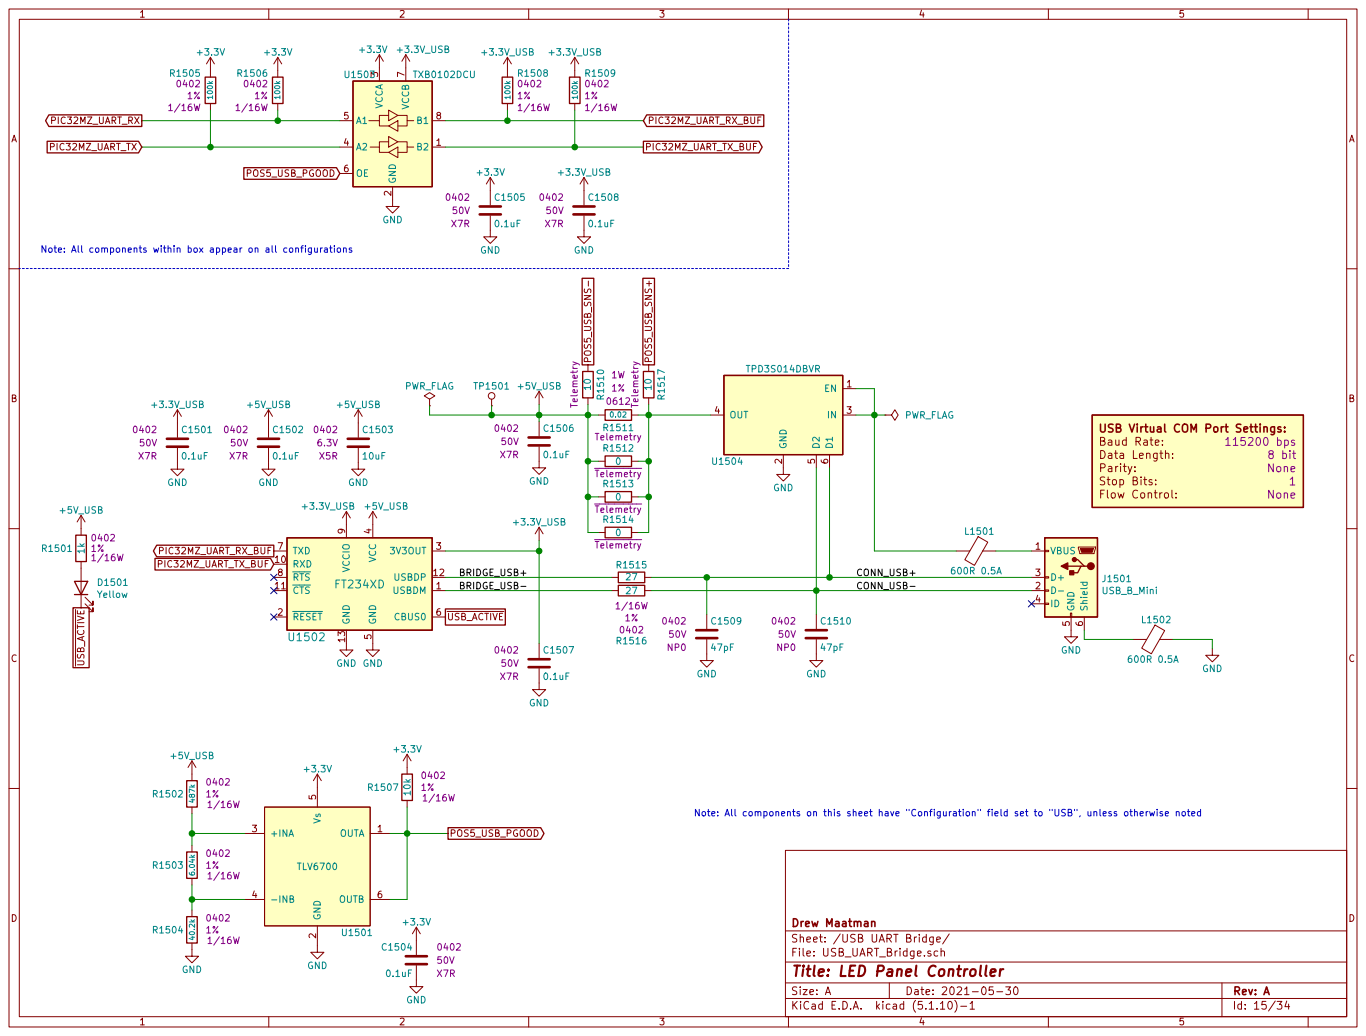
[picture p15: page 15]

5 D1 U1504 6 TPD3S014DBVR Baud Rate: Data Length:

USB Virtual COM Port Settings:

Note: All components on this sheet have "Configuration" field set to "USB", unless otherwise noted

File: USB_UART_Bridge.sch
Id: 15/34 Title: LED Panel Controller

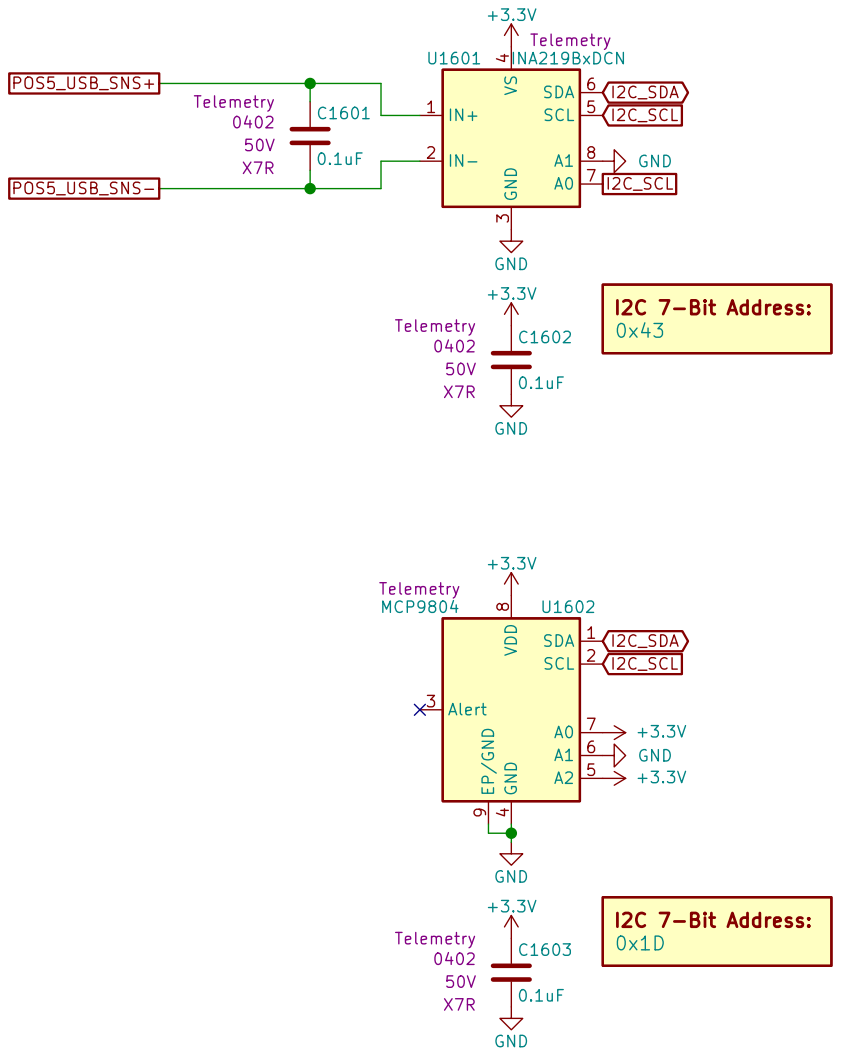
[picture p16: page 16]

Sheet: /USB Telemetry/ Drew Maatman

File: USB_Telemetry.sch
Id: 16/34 Title: LED Panel Controller

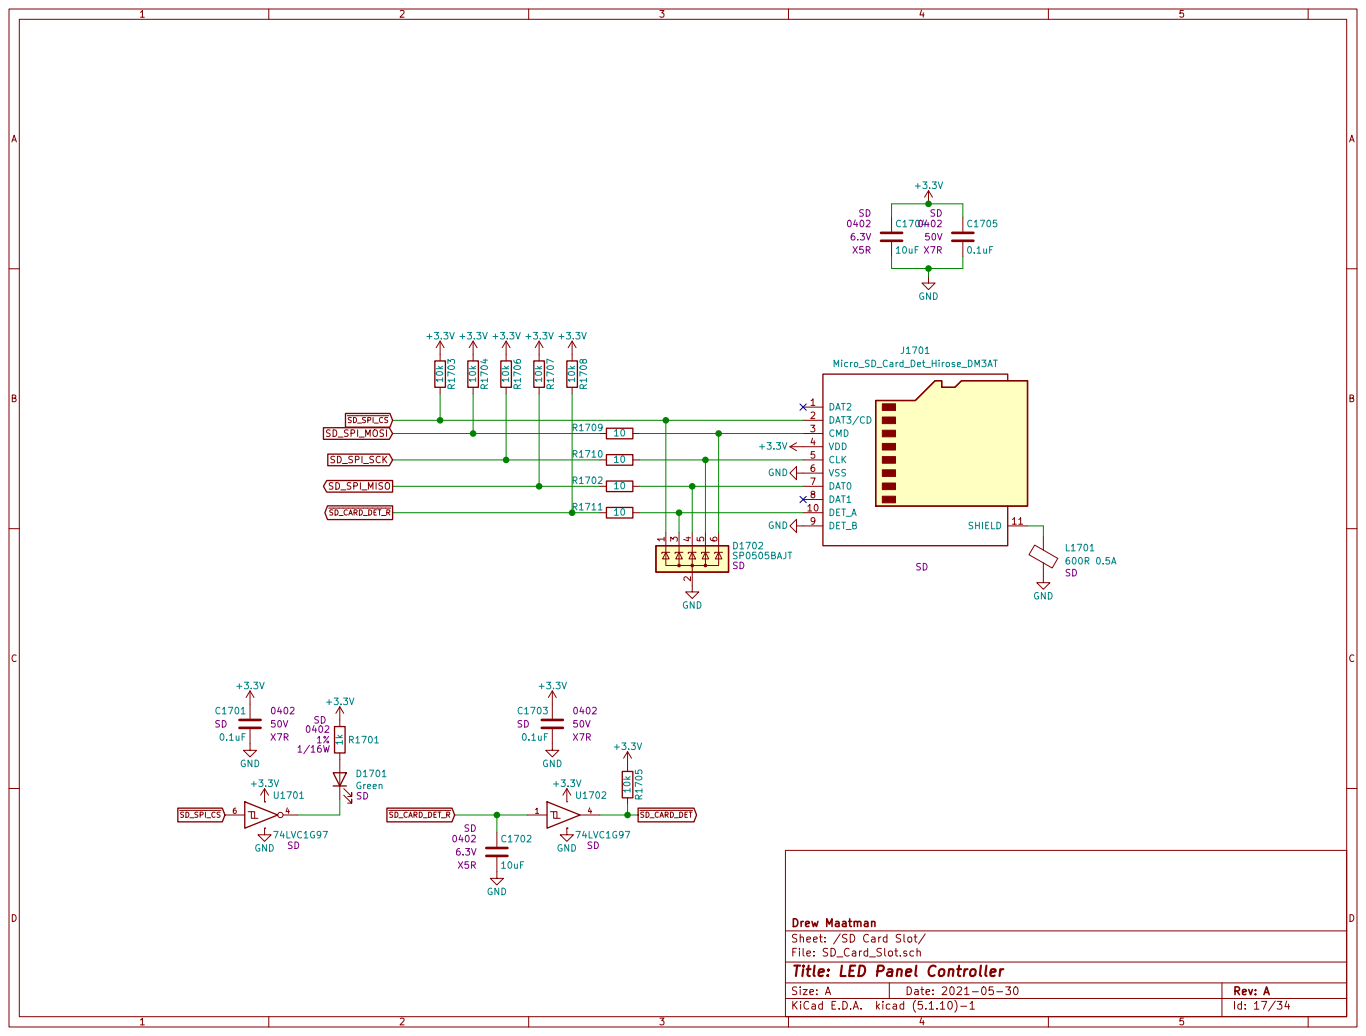
[picture p17: page 17]

File: SD_Card_Slot.sch Sheet: /SD Card Slot/ Drew Maatman C1701

Id: 17/34 Title: LED Panel Controller

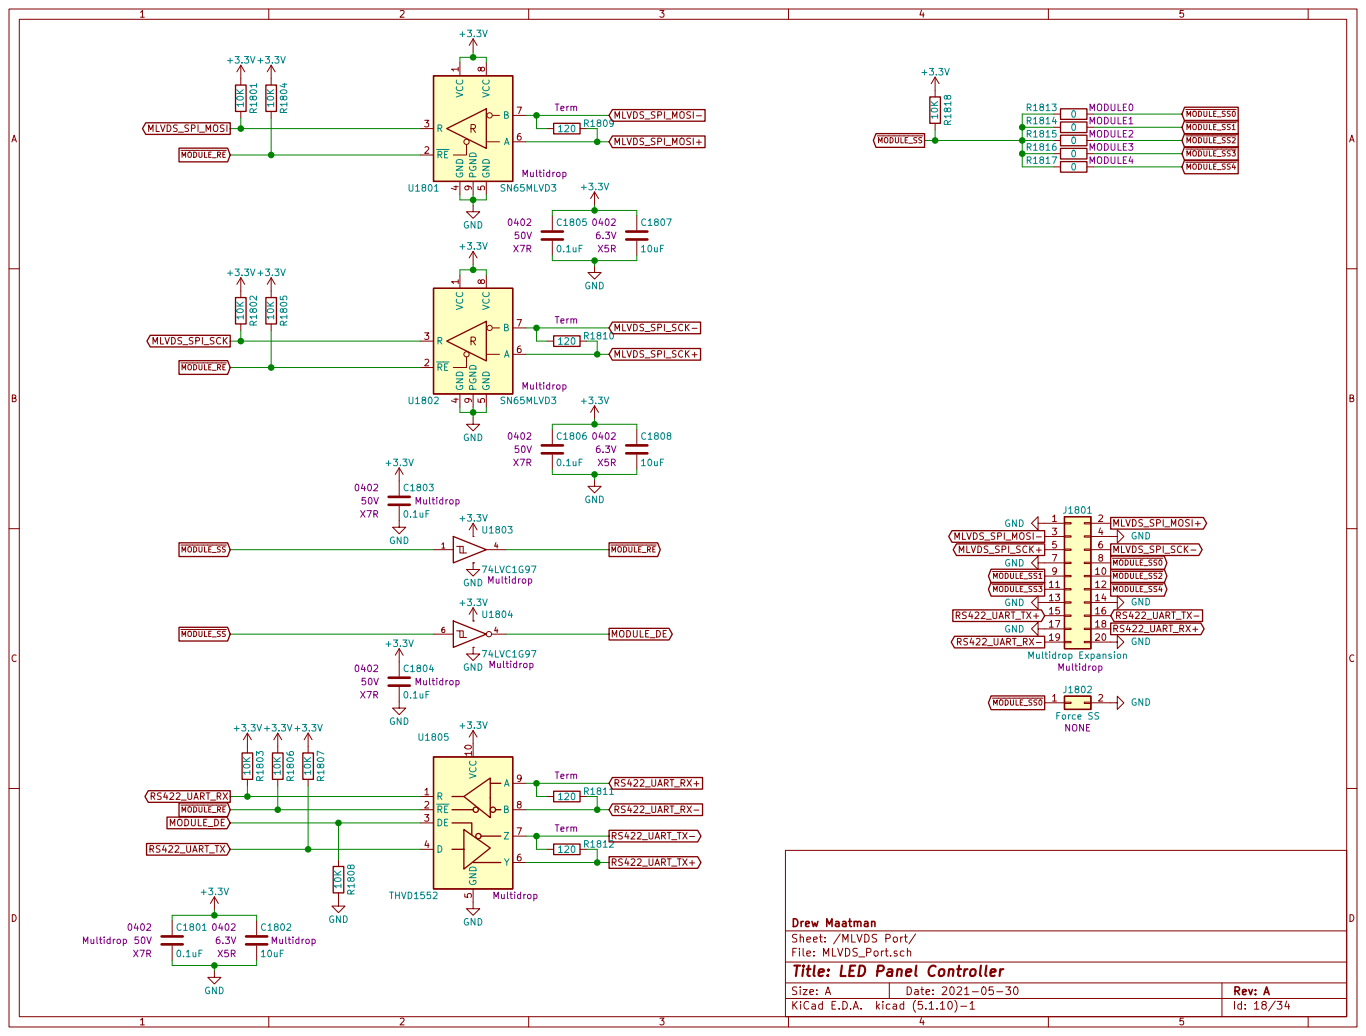
[picture p18: page 18]

File: MLVDS_Port.sch Sheet: /MLVDS Port/ Drew Maatman R1812 120 Term

Id: 18/34 Title: LED Panel Controller

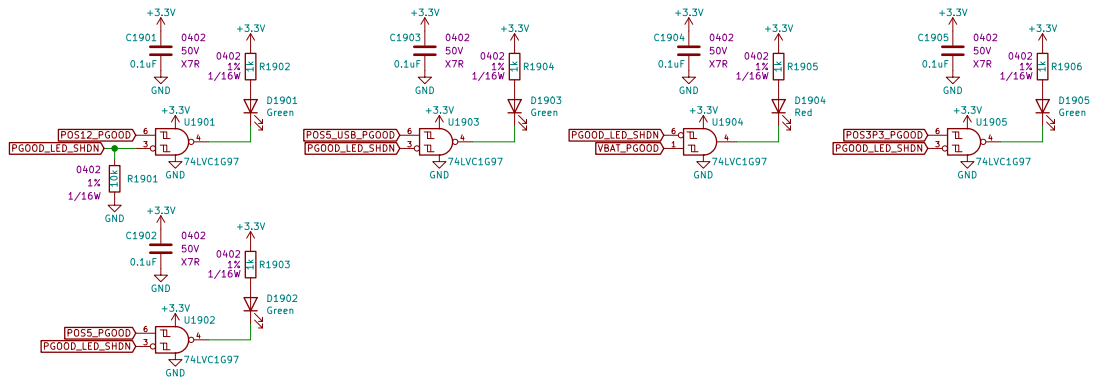
[picture p19: page 19]

File: PGOOD_LEDs.sch Sheet: /PGOOD LEDs/ Drew Maatman

Id: 19/34 Title: LED Panel Controller

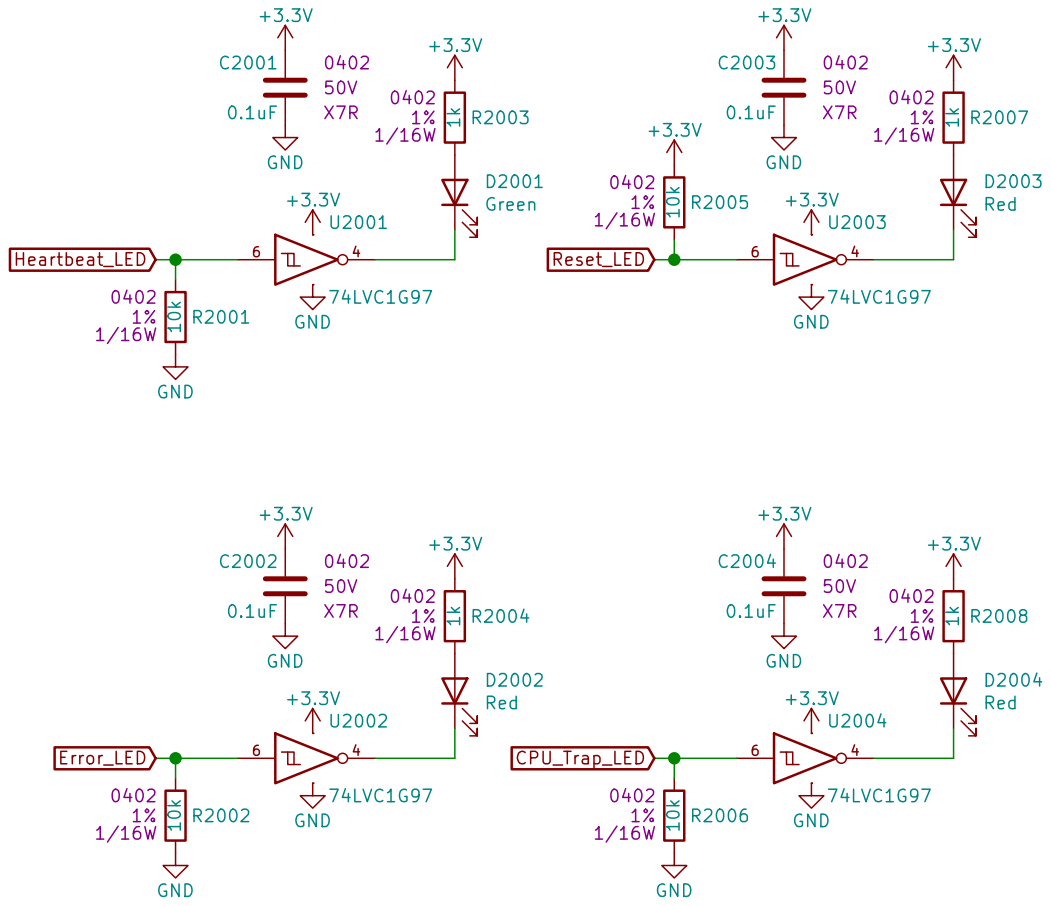
[picture p20: page 20]

File: Status_LEDs.sch Sheet: /Status LEDs/ Drew Maatman

Id: 20/34 Title: LED Panel Controller

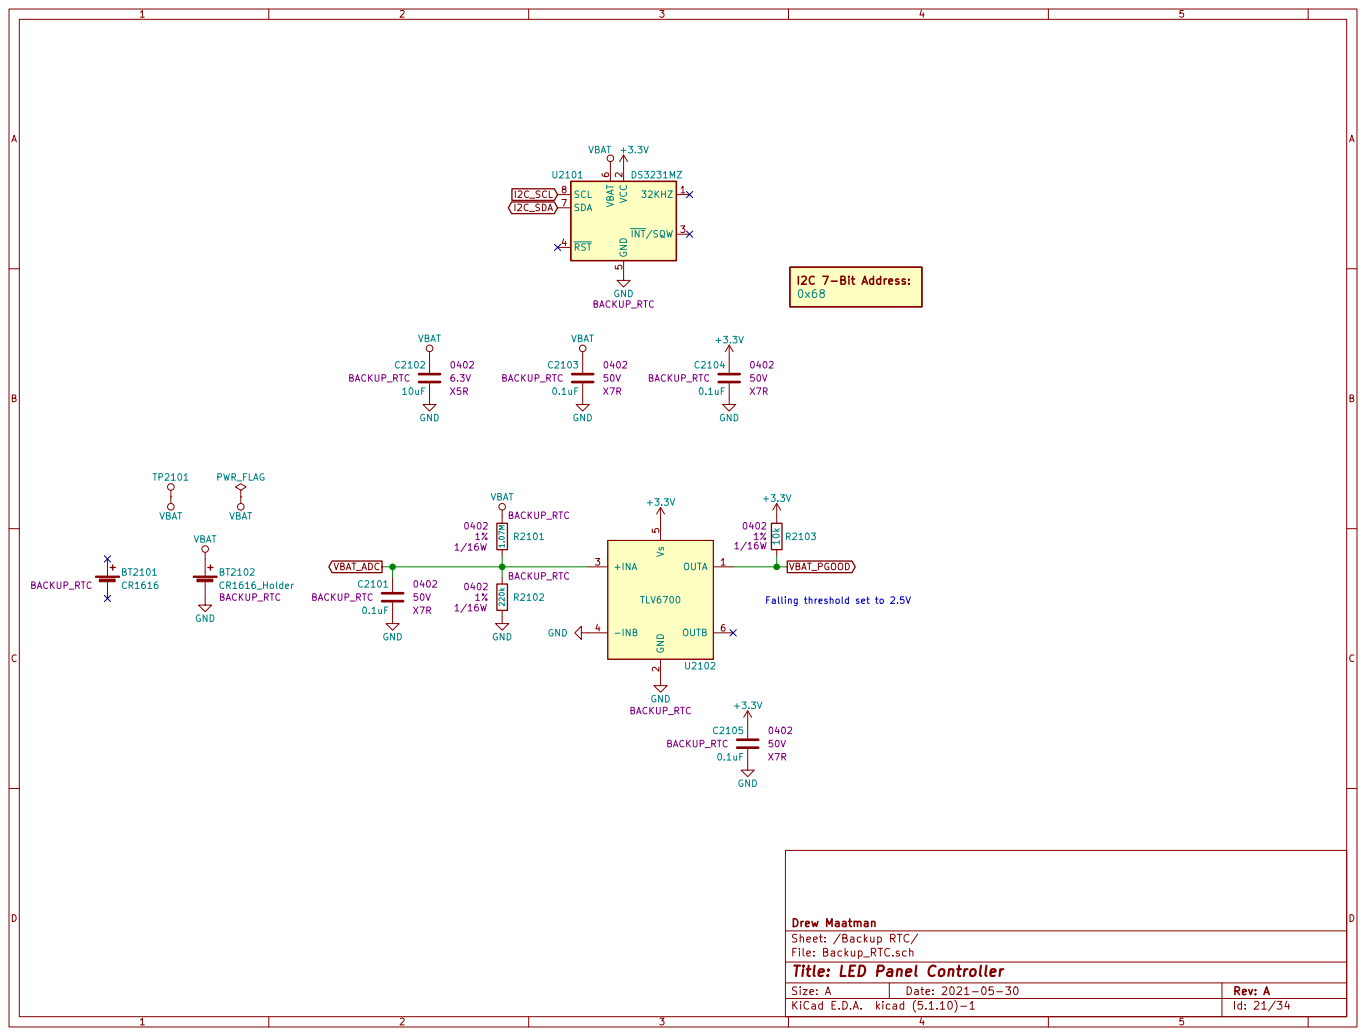
[picture p21: page 21]

Falling threshold set to 2.5V

Sheet: /Backup RTC/ Drew Maatman GND

File: Backup_RTC.sch
Id: 21/34 Title: LED Panel Controller

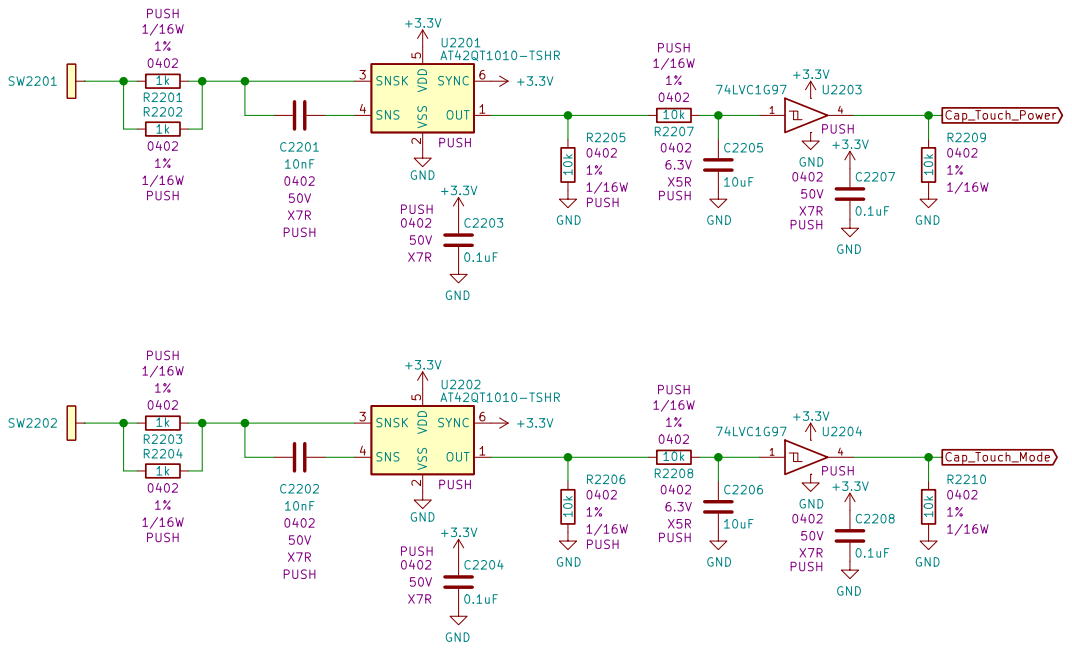
[picture p22: page 22]

Id: 22/34 Title: LED Panel Controller File: Pushbuttons.sch Sheet: /Pushbuttons/ Drew Maatman GND
PUSH

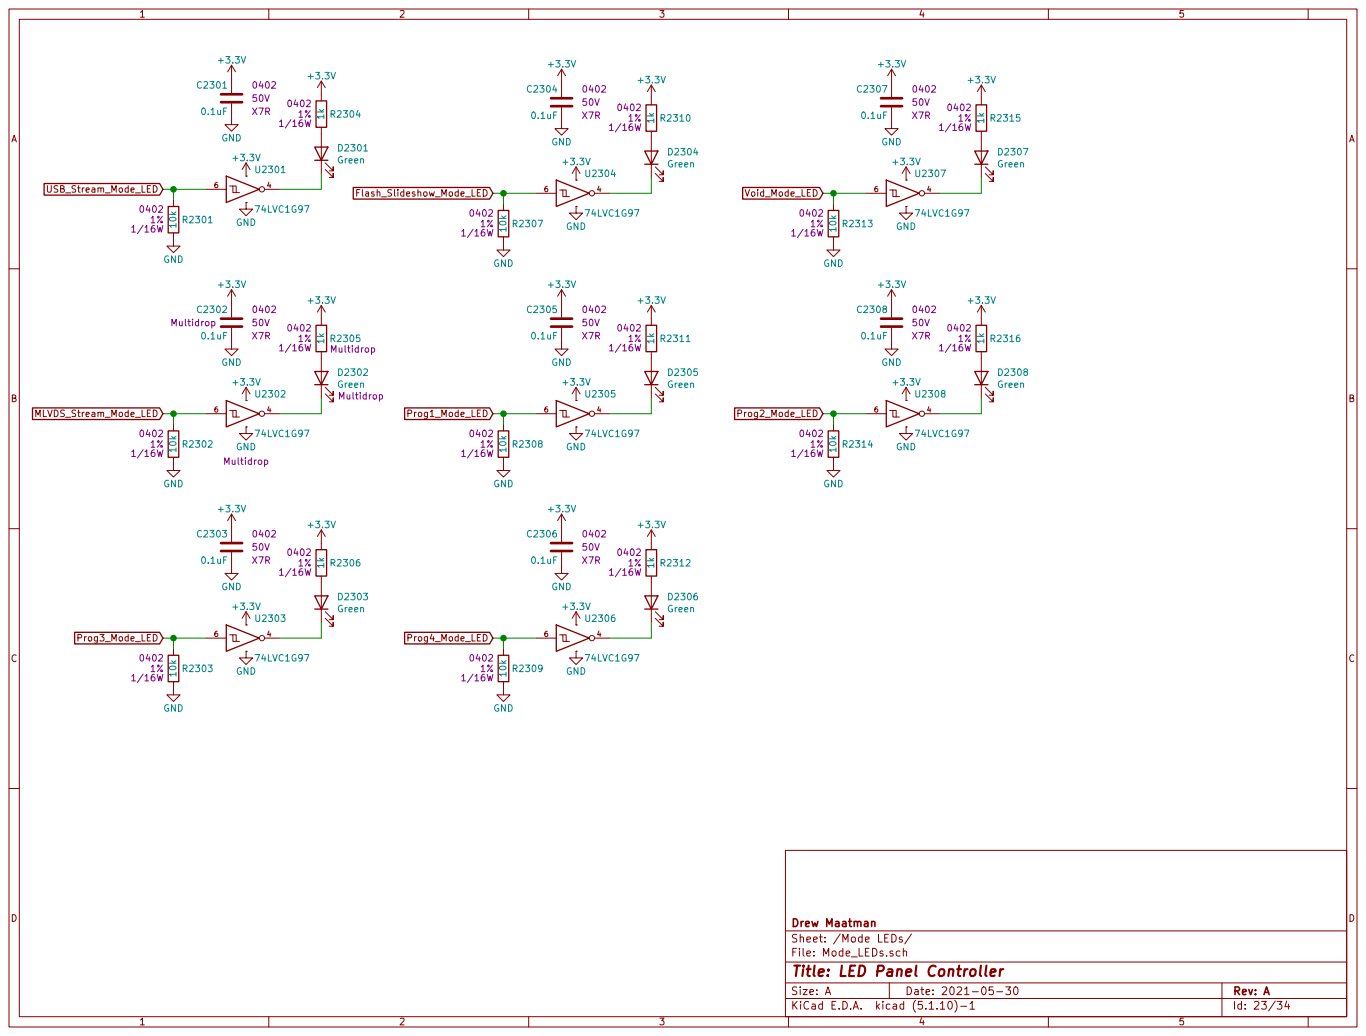
[picture p23: page 23]

File: Mode_LEDs.sch Sheet: /Mode LEDs/ Drew Maatman

Id: 23/34 Title: LED Panel Controller

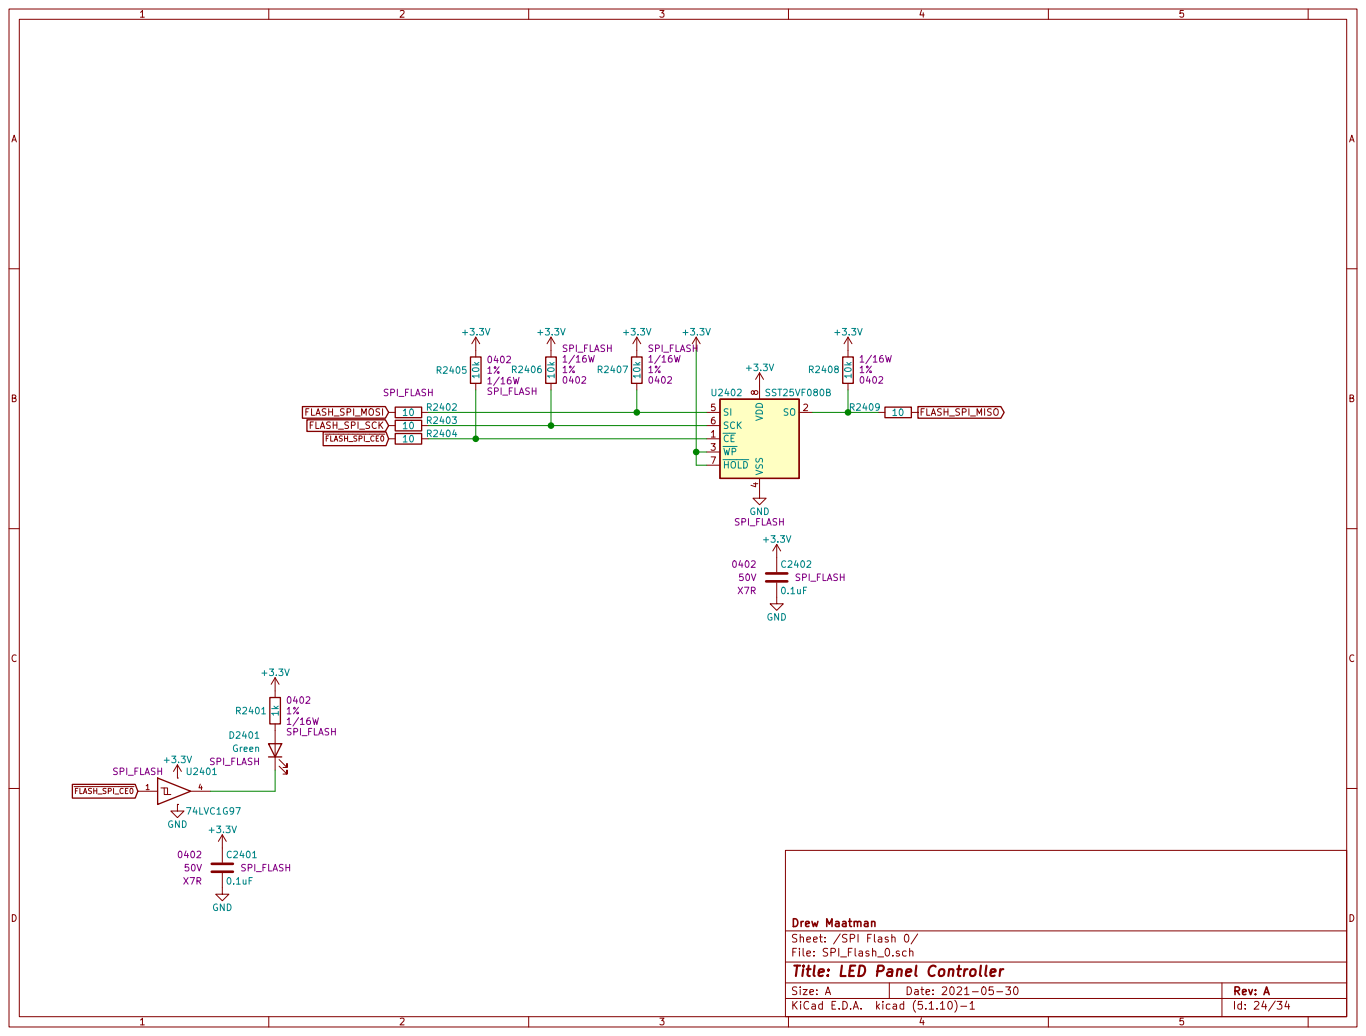
[picture p24: page 24]

4 SI 5 SCK 6 HOLD 7 VDD

File: SPI_Flash_0.sch Sheet: /SPI Flash 0/ Drew Maatman

Id: 24/34 Title: LED Panel Controller

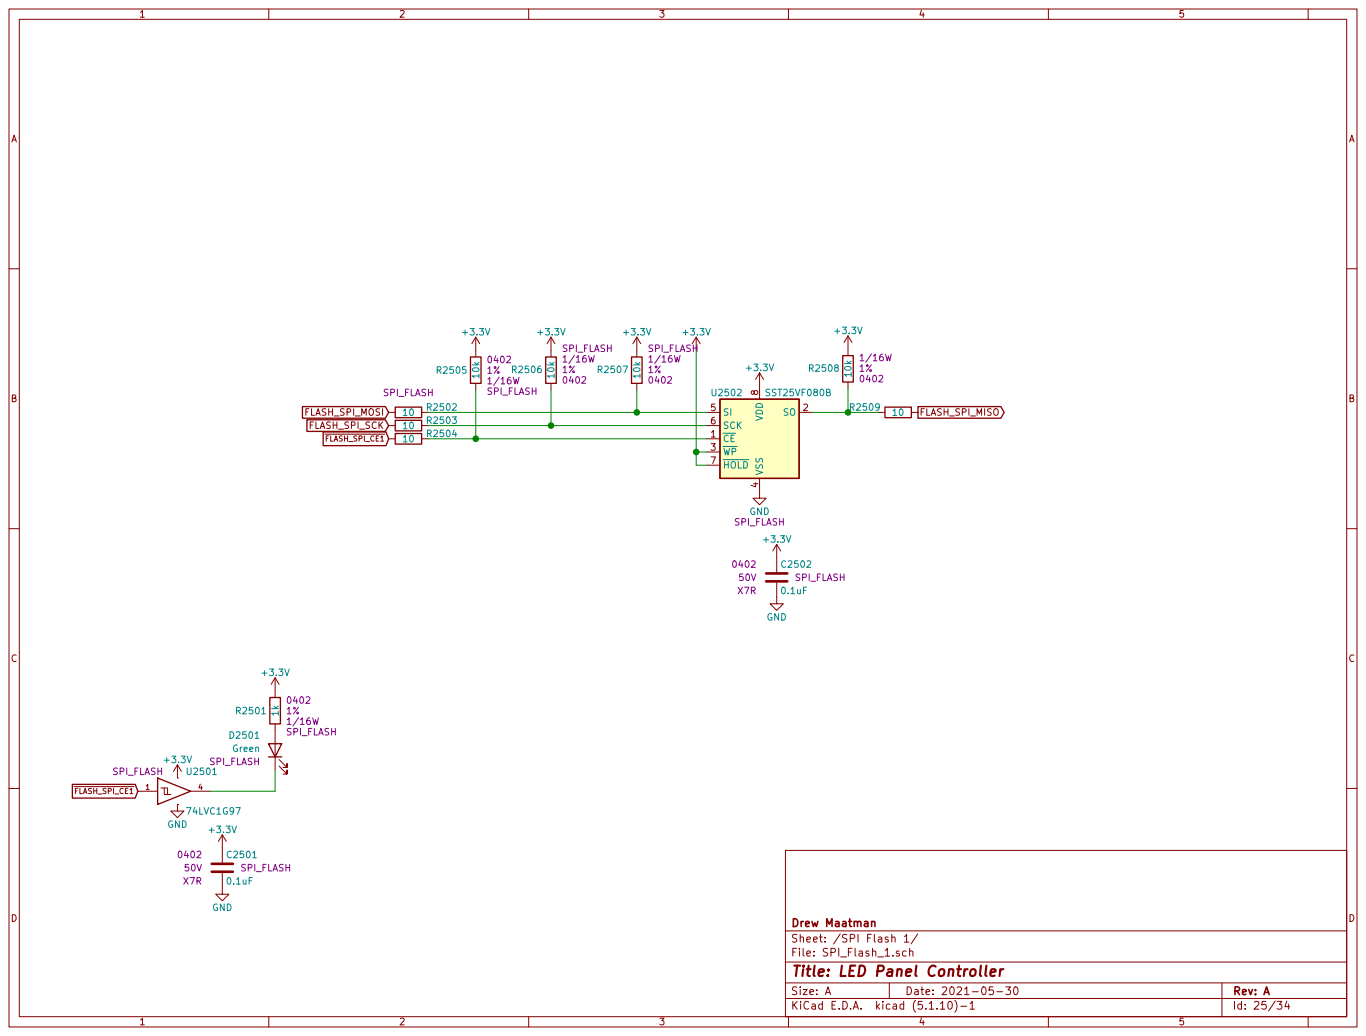
[picture p25: page 25]

4 SI 5 SCK 6 HOLD 7 VDD

File: SPI_Flash_1.sch Sheet: /SPI Flash 1/ Drew Maatman

Id: 25/34 Title: LED Panel Controller

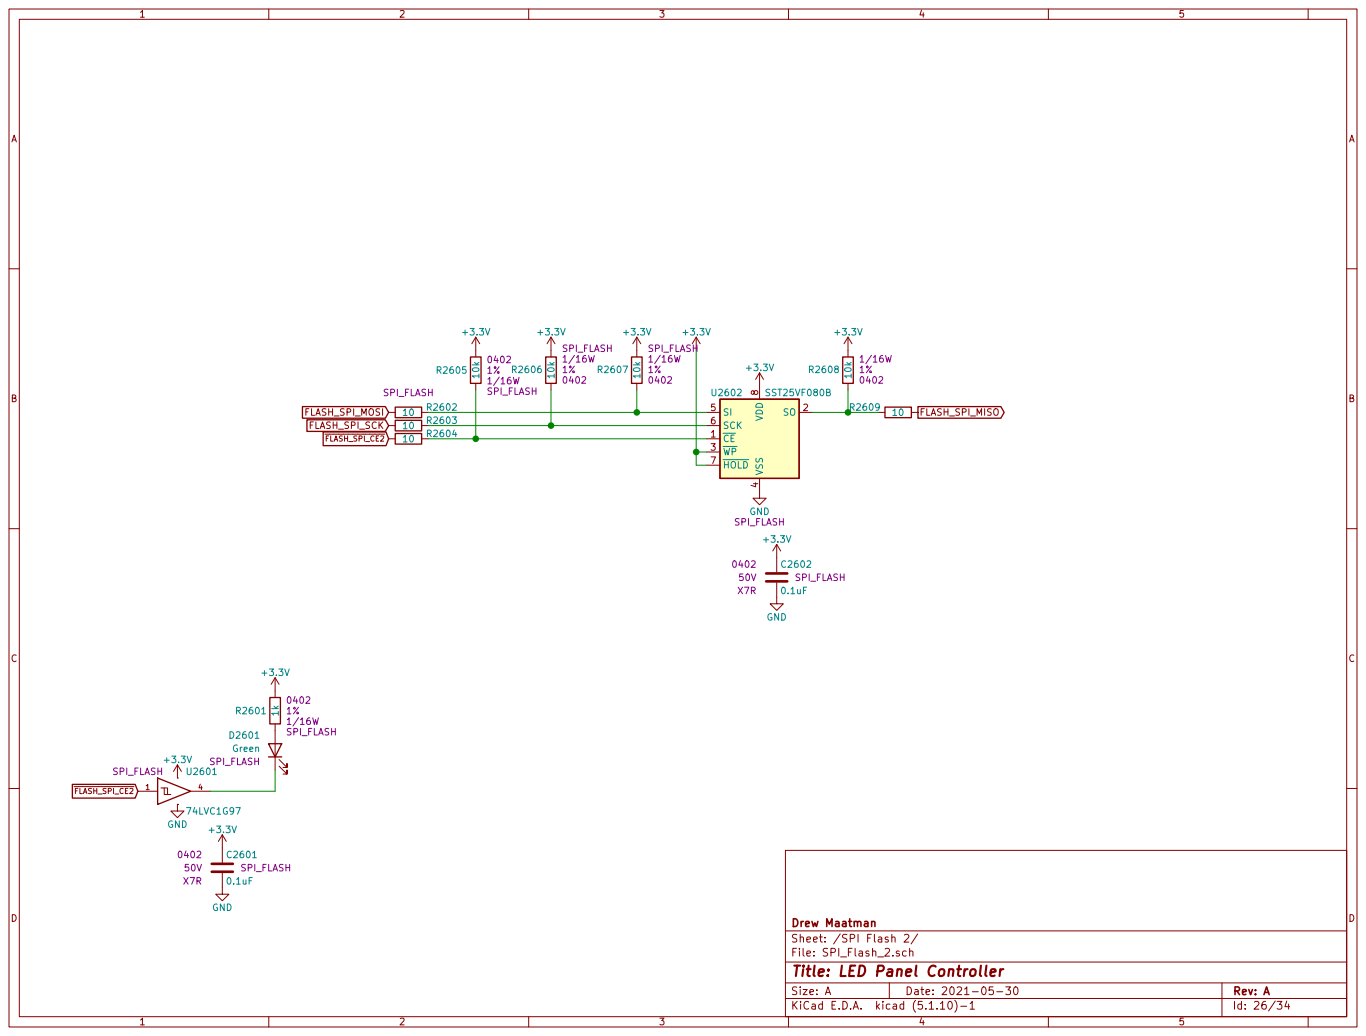
[picture p26: page 26]

4 SI 5 SCK 6 HOLD 7 VDD

File: SPI_Flash_2.sch Sheet: /SPI Flash 2/ Drew Maatman

Id: 26/34 Title: LED Panel Controller

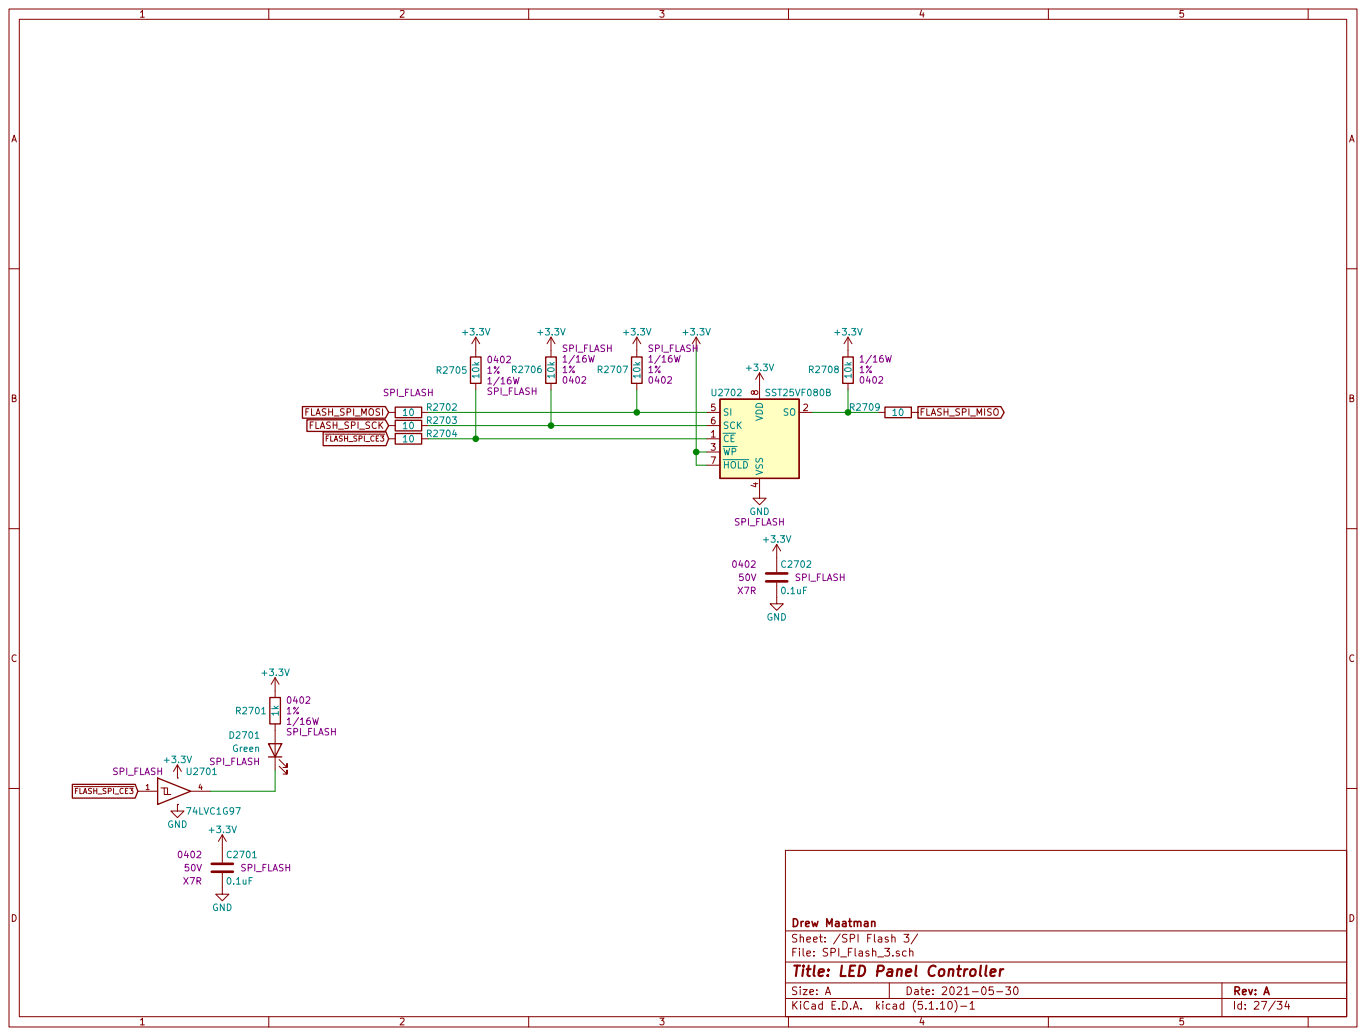
[picture p27: page 27]

4 SI 5 SCK 6 HOLD 7 VDD

Id: 27/34 Title: LED Panel Controller

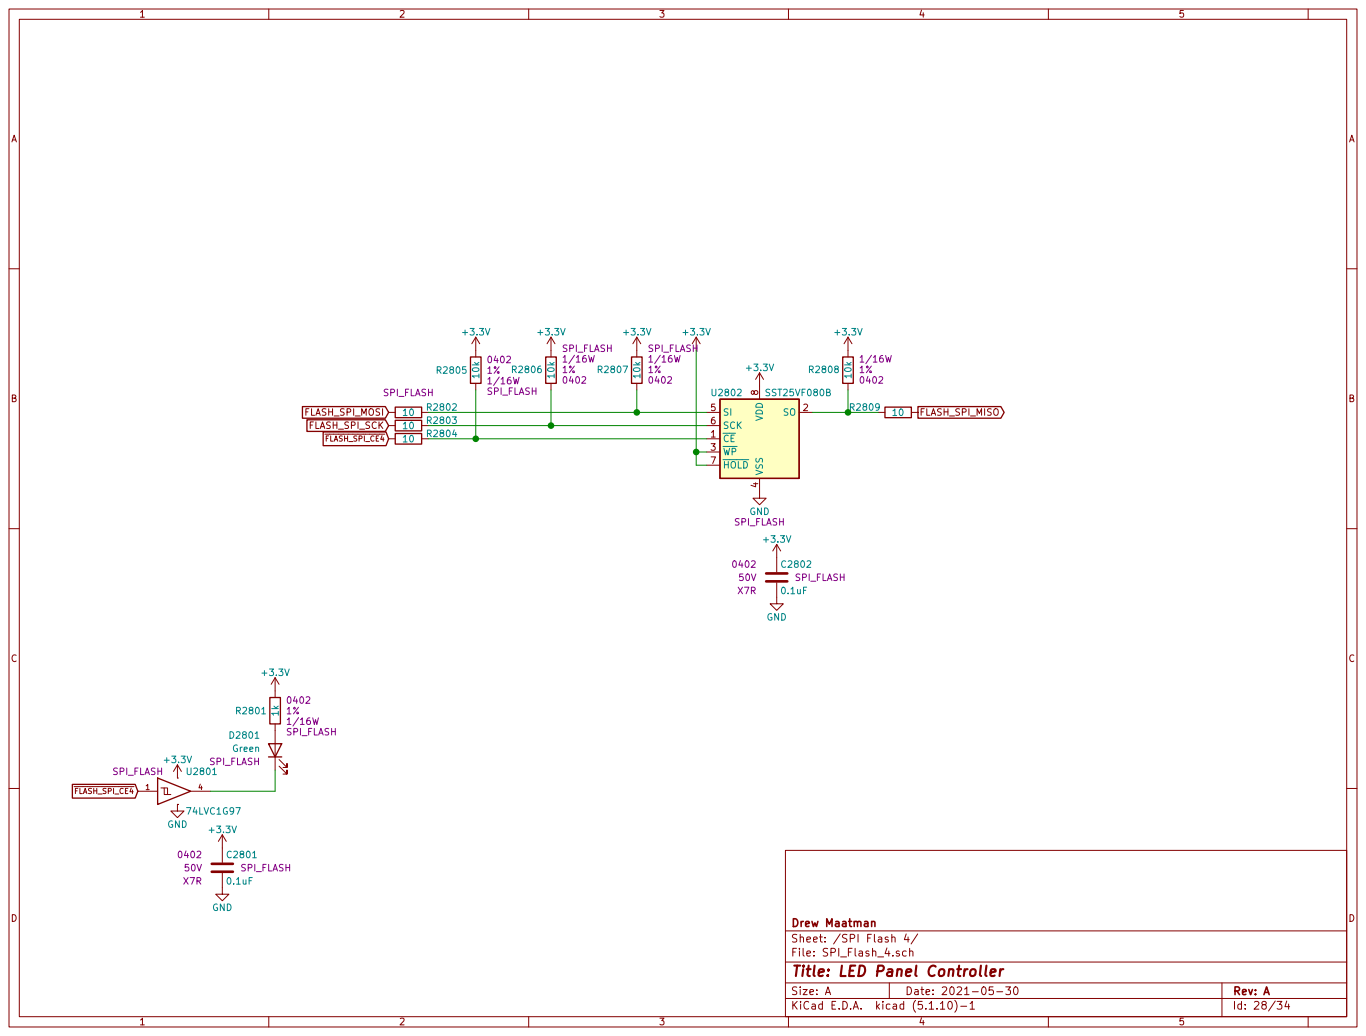
[picture p28: page 28]

4 SI 5 SCK 6 HOLD 7 VDD

Id: 28/34 Title: LED Panel Controller

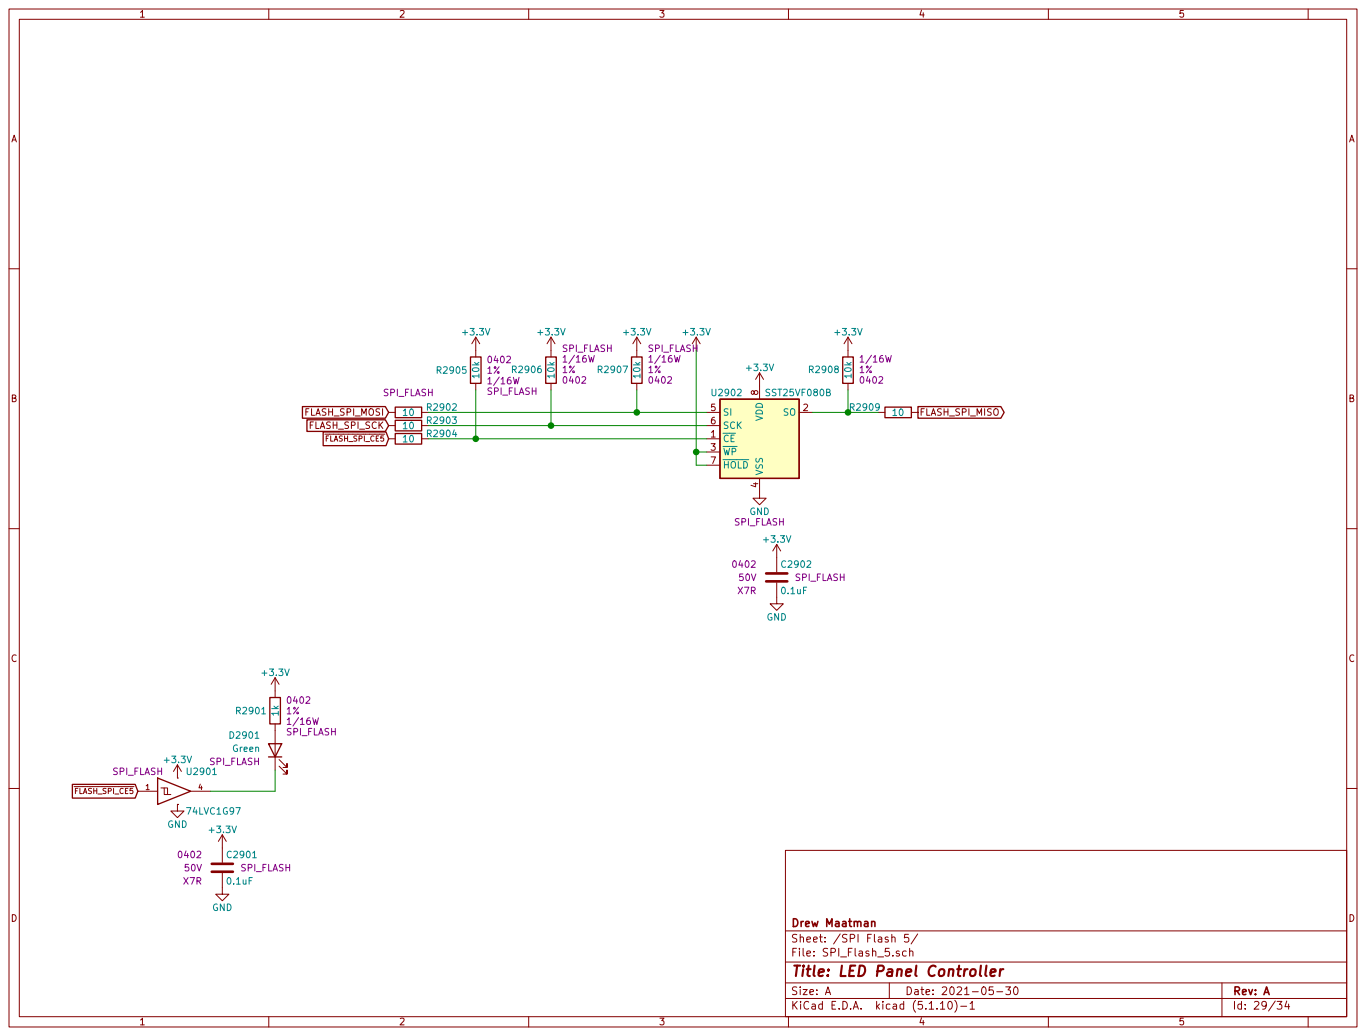
[picture p29: page 29]

4 SI 5 SCK 6 HOLD 7 VDD

Id: 29/34 Title: LED Panel Controller

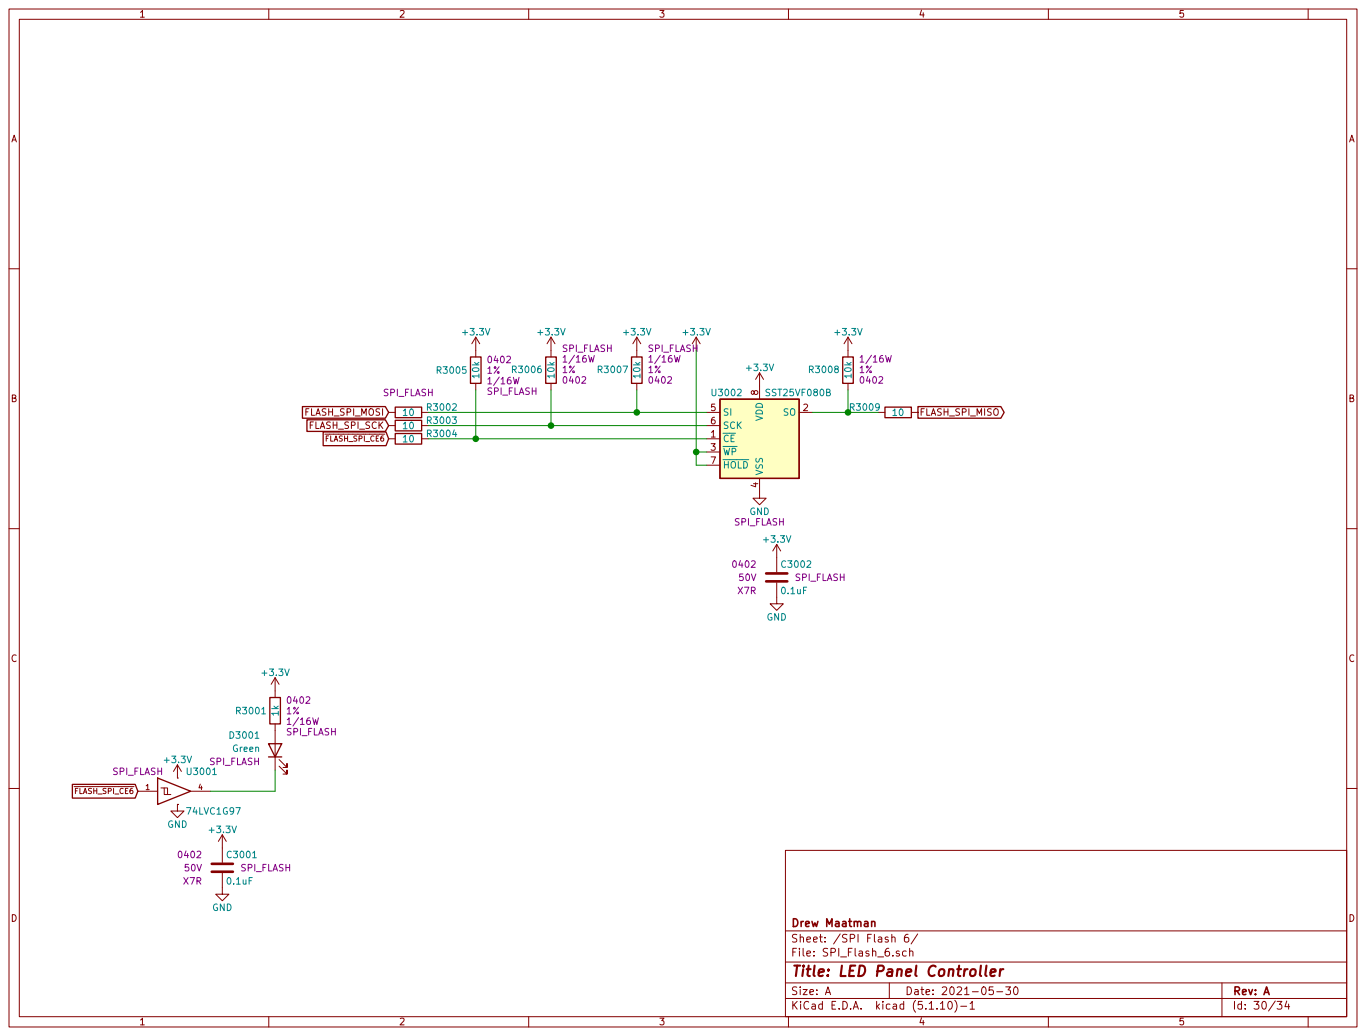
[picture p30: page 30]

4 SI 5 SCK 6 HOLD 7 VDD

File: SPI_Flash_6.sch Sheet: /SPI Flash 6/ Drew Maatman

Id: 30/34 Title: LED Panel Controller

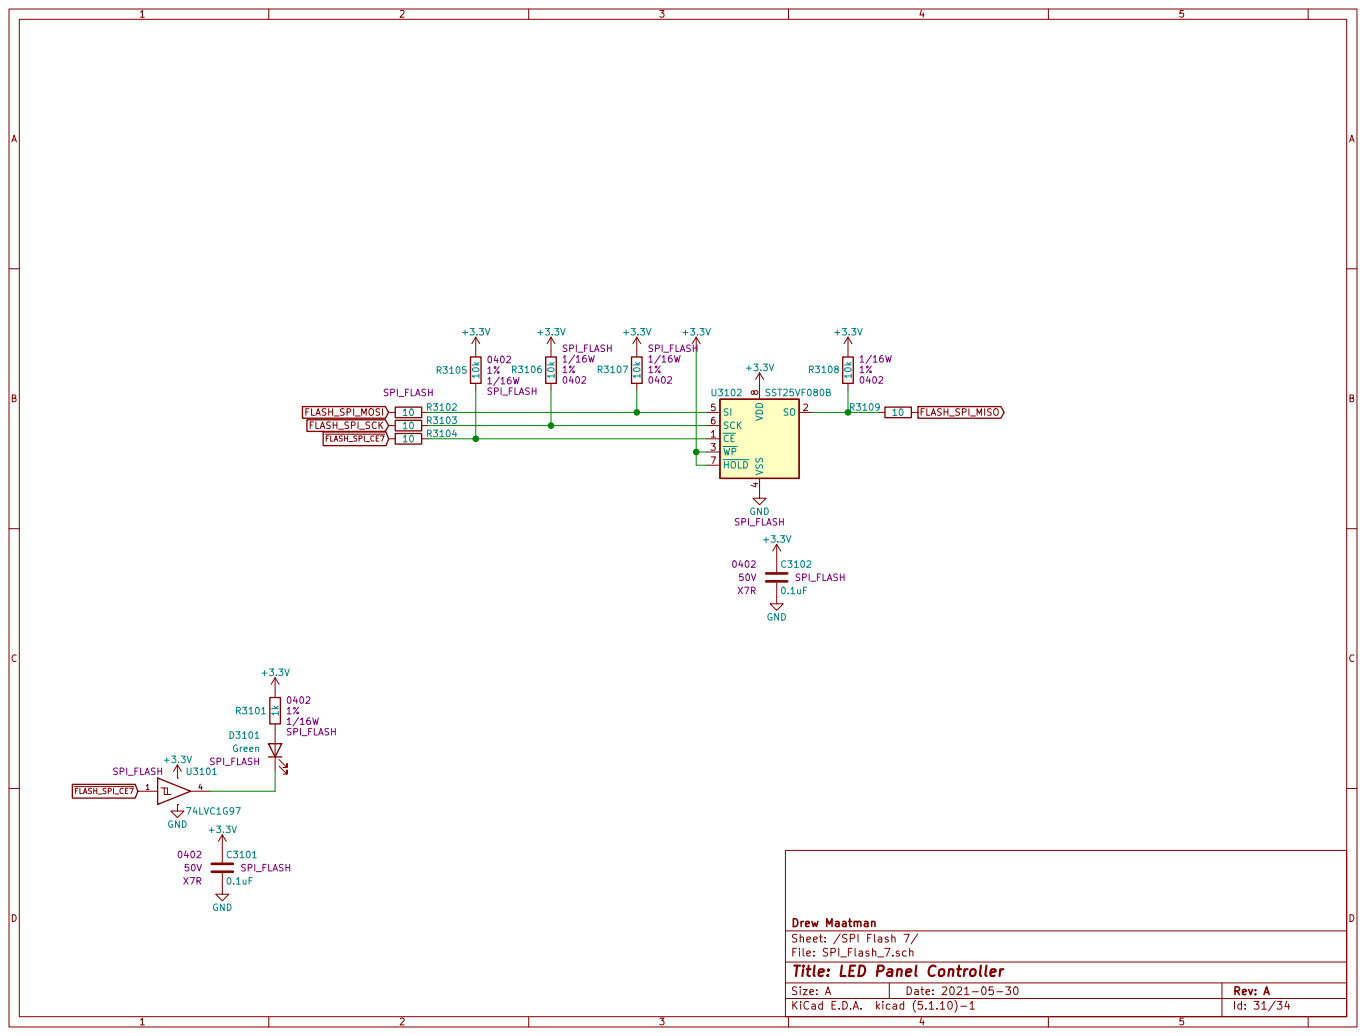
[picture p31: page 31]

4 SI 5 SCK 6 HOLD 7 VDD

Id: 31/34 Title: LED Panel Controller

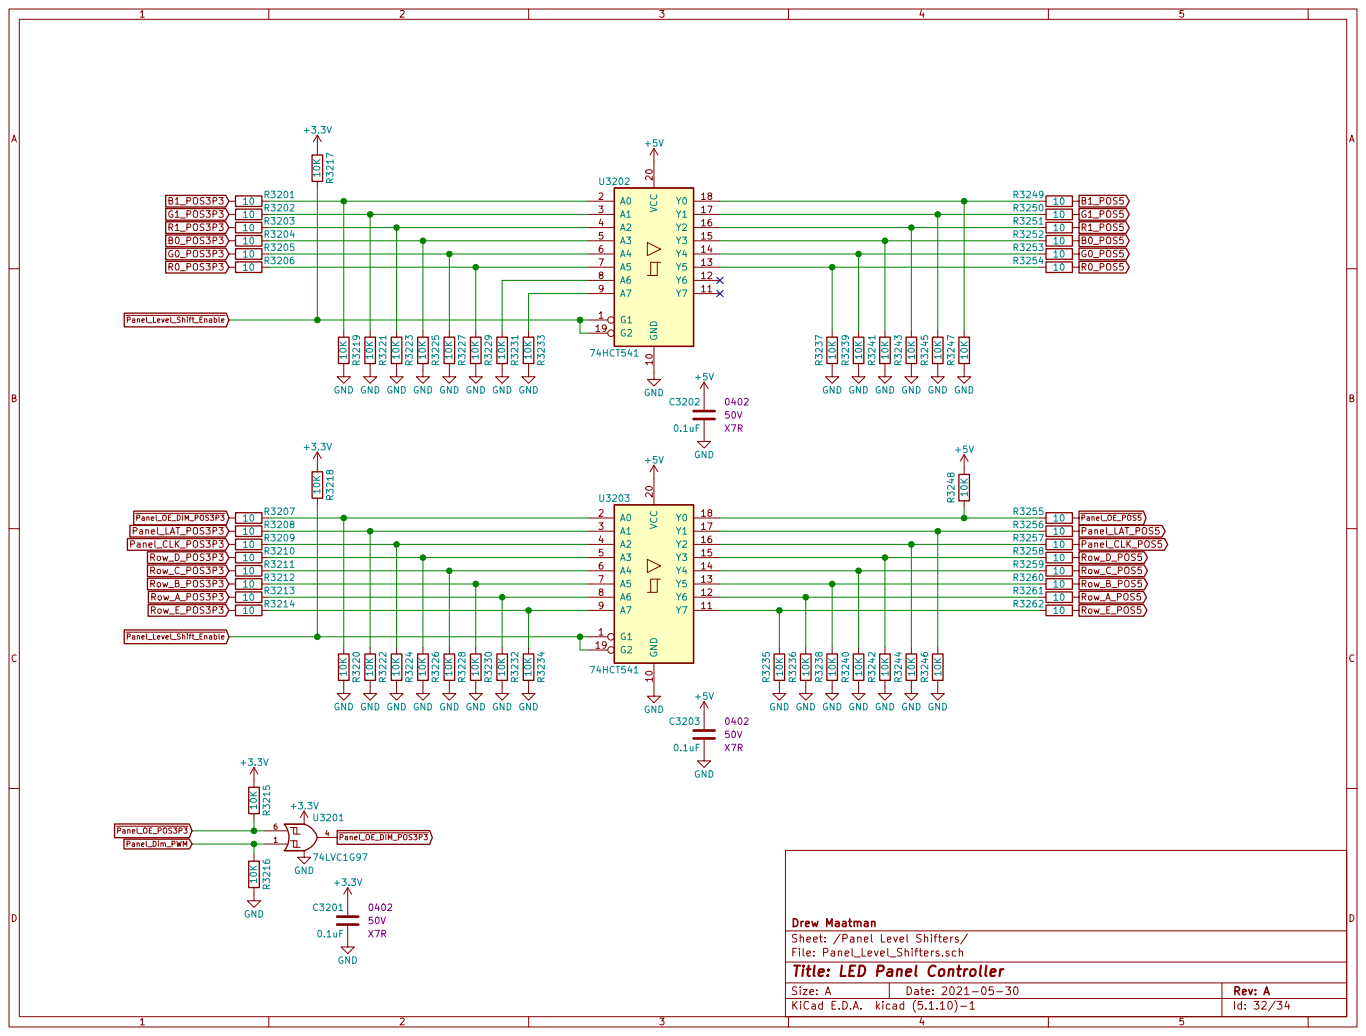
[picture p32: page 32]

10 GND GND GND GND GND GND GND GND

Id: 32/34 Title: LED Panel Controller

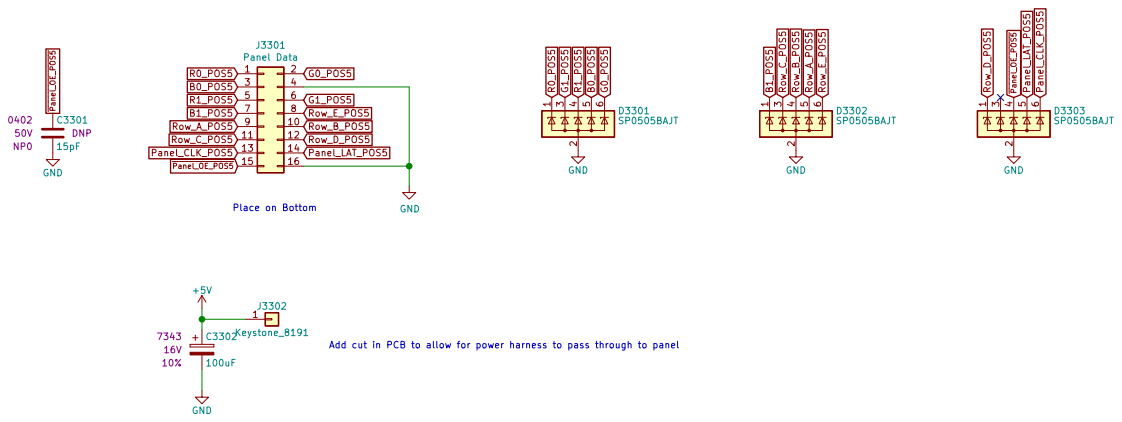
[picture p33: page 33]

Add cut in PCB to allow for power harness to pass through to panel

File: Panel_Connectors.sch Sheet: /Panel Connectors/ Drew Maatman

Id: 33/34 Title: LED Panel Controller

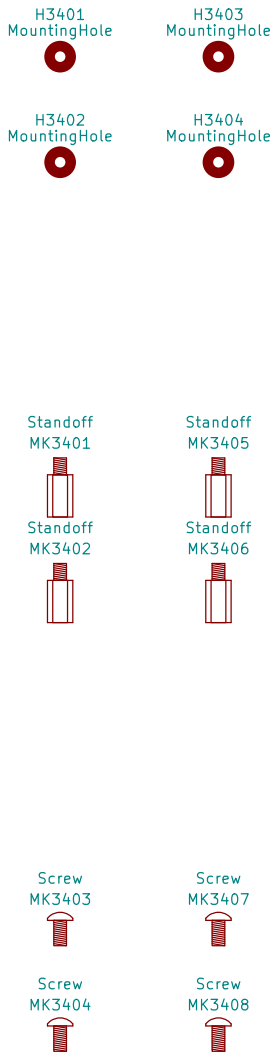
[picture p34: page 34]

Id: 34/34 Title: LED Panel Controller File: Mechanical.sch Sheet: /Mechanical/ Drew Maatman
