drewsum/LED_Panel_Controller/doc/block_diagram.pdf

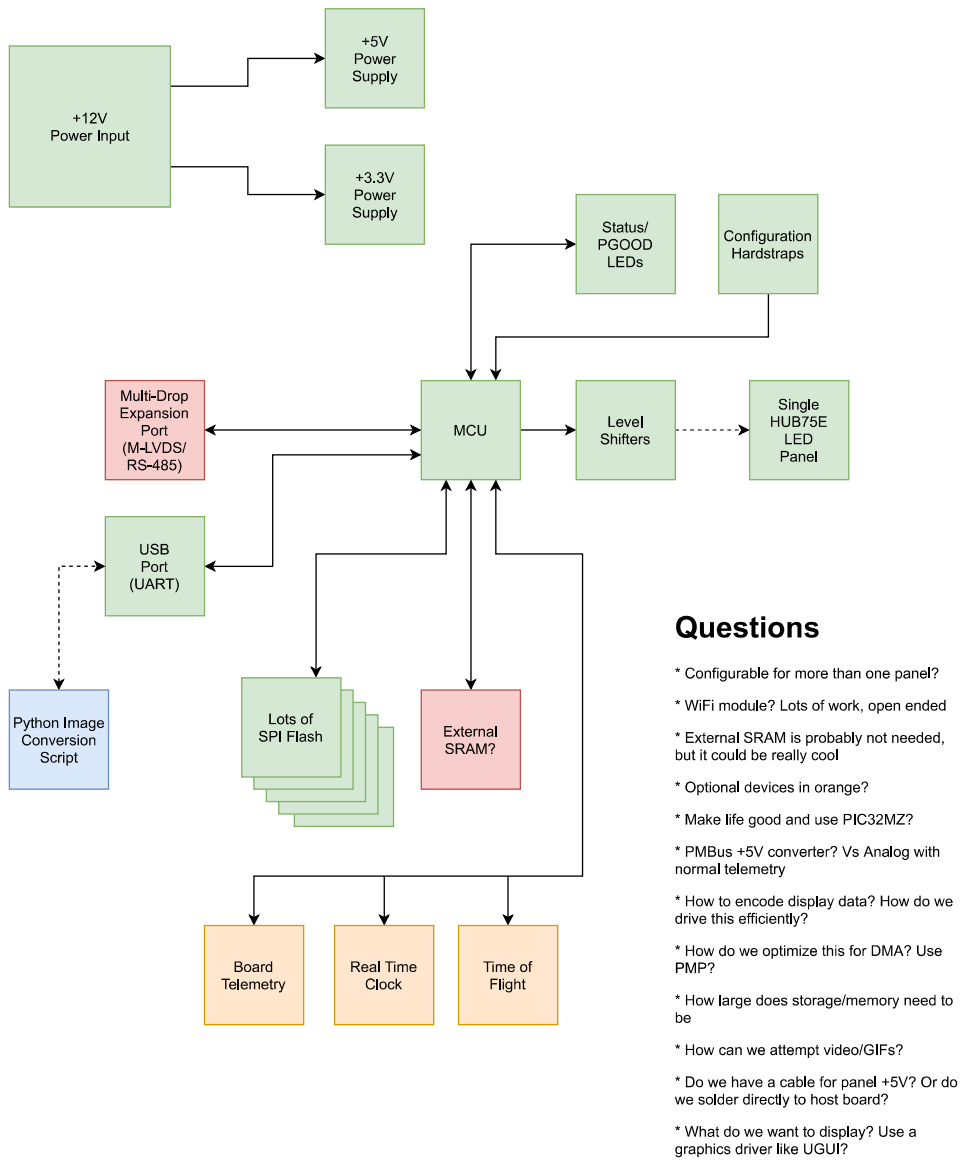
[picture p35: page 1]
