drewsum/LED_Panel_Controller/hdw/LED_Panel_Controller/LED_Panel_Controller.kicad_pcb

## KiCad design hdw/LED_Panel_Controller/LED_Panel_Controller.kicad_pcb (2021-06-11)

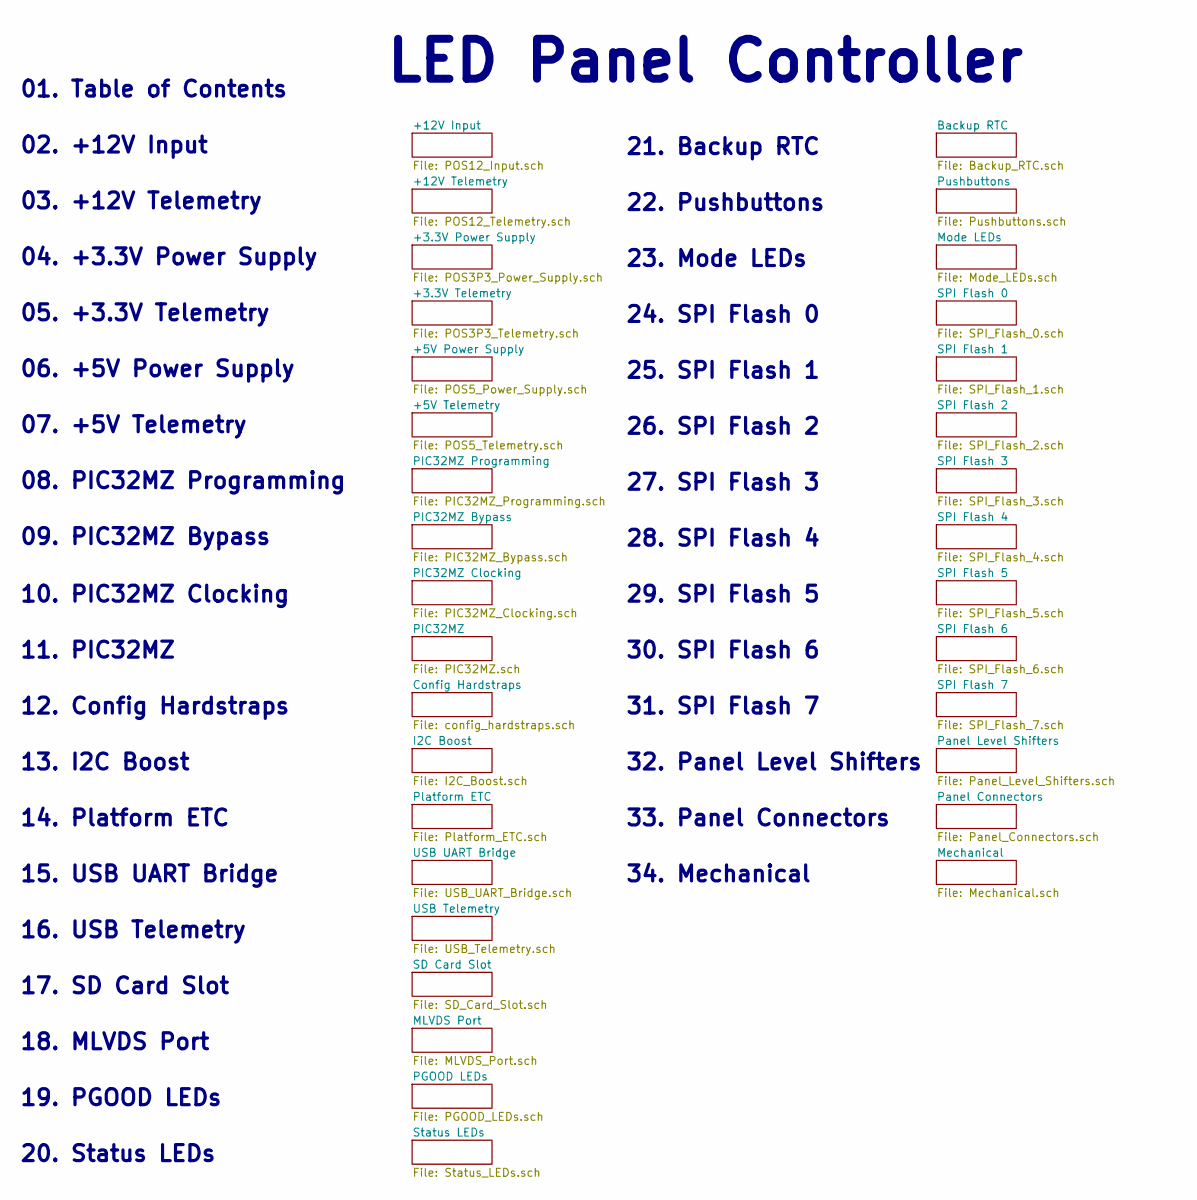
[picture p36: schematic LED_Panel_Controller.sch, LED Panel Controller]

Notes on the sheet:
LED Panel Controller
02. +12V Input
03. +12V Telemetry
04. +3.3V Power Supply
05. +3.3V Telemetry
06. +5V Power Supply
07. +5V Telemetry
08. PIC32MZ Programming
09. PIC32MZ Bypass
10. PIC32MZ Clocking
11. PIC32MZ
12. Config Hardstraps
13. I2C Boost
14. Platform ETC
15. USB UART Bridge
17. SD Card Slot
18. MLVDS Port
19. PGOOD LEDs
20. Status LEDs
21. Backup RTC
01. Table of Contents
22. Pushbuttons
23. Mode LEDs
24. SPI Flash 0
25. SPI Flash 1
26. SPI Flash 2
27. SPI Flash 3
28. SPI Flash 4
29. SPI Flash 5
30. SPI Flash 6
31. SPI Flash 7
32. Panel Level Shifters
33. Panel Connectors
34. Mechanical
16. USB Telemetry

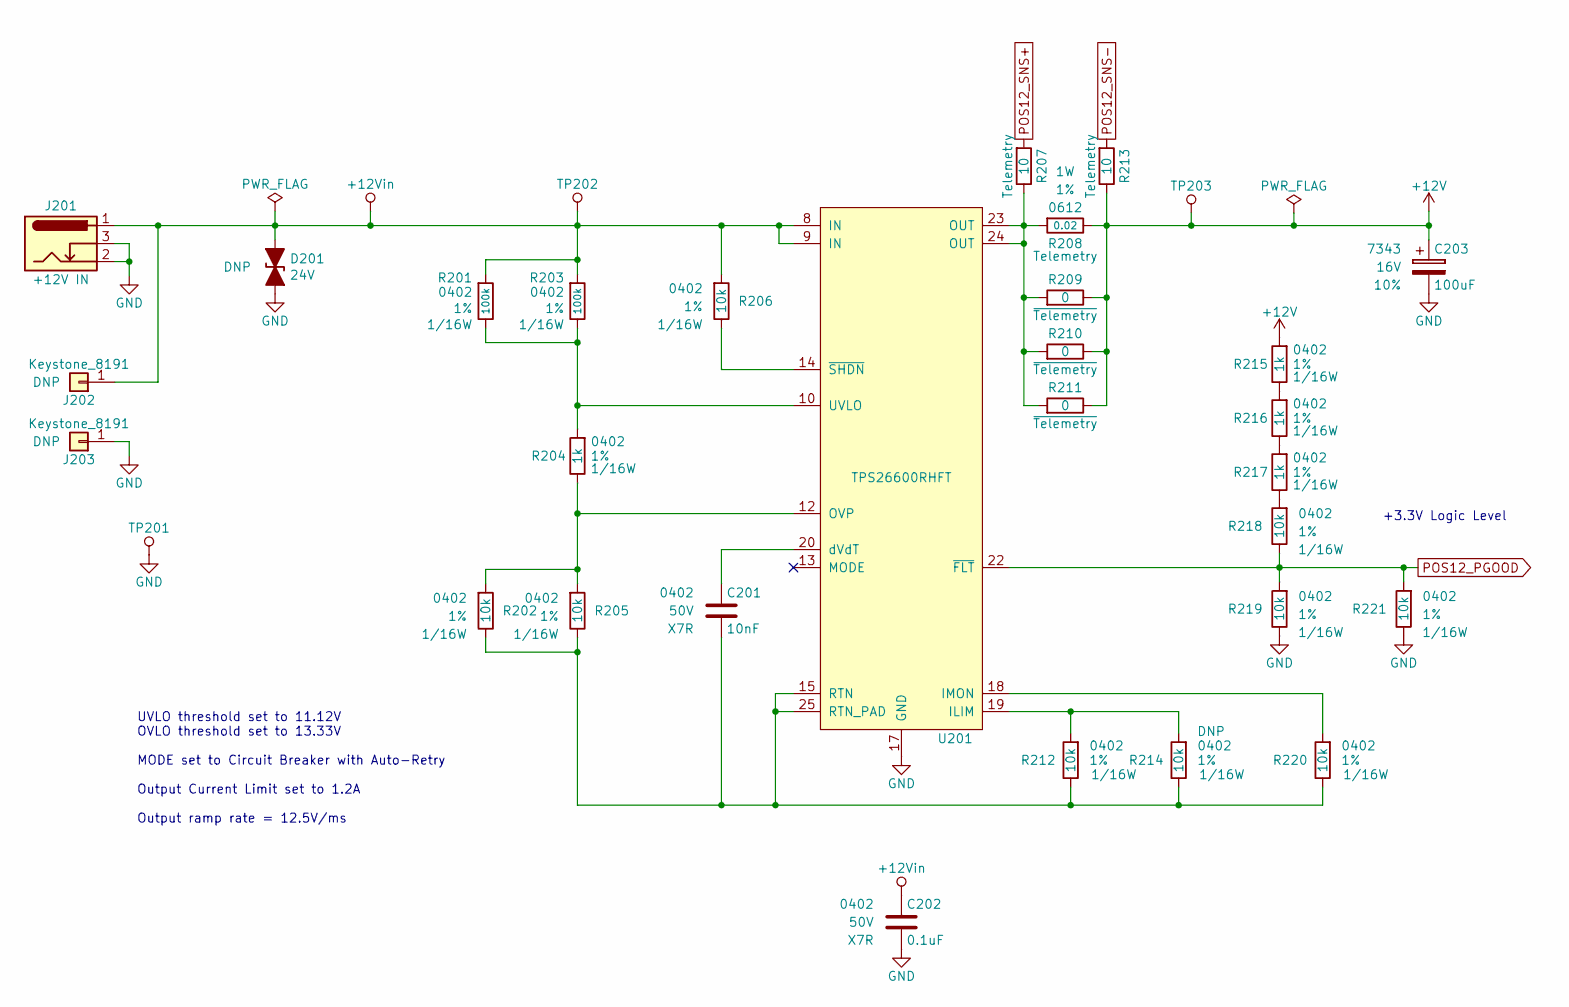
[picture p37: schematic POS12_Input.sch, LED Panel Controller]

Parts:
C201: 10nF; C_0402; Voltage 50V; Digi-Key PN 399-3066-1-ND
C202: 0.1uF; C_0402; Voltage 50V; Digi-Key PN 490-10698-1-ND
C203: 100uF; CP_Tantalum_Case-X_EIA-7343-43_Reflow; Voltage 16V; Tolerance 10%; Digi-Key PN 718-1102-1-ND
D201: 24V; D_SMA; Digi-Key PN SMAJ24CALFCT-ND
J201: +12V IN; BARREL_JACK
J202, J203: Keystone_8191; Digi-Key PN 36-8191-ND
R201, R203: 100k; R_0402; Tolerance 1%; Digi-Key PN RMCF0402FT100KCT-ND
R202, R205, R206, R212, R214, R218, R219, R220, R221: 10k; R_0402; Tolerance 1%; Digi-Key PN RMCF0402FT10K0CT-ND
R204, R215, R216, R217: 1k; R_0402; Tolerance 1%; Digi-Key PN RMCF0402FT1K00CT-ND
R207, R213: 10; R_0402; Tolerance 1%; Digi-Key PN RMCF0402FT10R0CT-ND
R208: 0.02; R_0612; Tolerance 1%; Digi-Key PN P16010CT-ND
R209, R210, R211: 0; R_0402; Tolerance 1%; Digi-Key PN RMCF0402ZT0R00CT-ND
TP201: TP; Pin_Header_Angled_1x01_Pitch2.54mm
TP202, TP203: TP; Test_Point
U201: TPS26600RHFT; QFN-24-1EP_4x5mm_Pitch0.5mm; Digi-Key PN 296-45478-1-ND

Connections:
+12V: C203.1, R208.2, R209.2, R210.2, R211.2, R213.2, R215.1, TP203.1; also elsewhere on the board
+12Vin: C202.1, D201.1 (A1), J201.1, J202.1, R201.1, R203.1, R206.1, TP202.1, U201.8 (IN), U201.9 (IN)
unnamed: C201.1, U201.20 (dVdT)
unnamed: C201.2, R202.2, R205.2, R212.2, R214.2, R220.2, U201.15 (RTN), U201.25 (RTN_PAD)
unnamed: R201.2, R203.2, R204.1, U201.10 (UVLO)
unnamed: R202.1, R204.2, R205.1, U201.12 (OVP)
unnamed: R206.2, U201.14 (~SHDN)
unnamed: R207.2, R208.1, R209.1, R210.1, R211.1, U201.23 (OUT), U201.24 (OUT)
unnamed: R212.1, R214.1, U201.19 (ILIM)
unnamed: R215.2, R216.1
unnamed: R216.2, R217.1
unnamed: R217.2, R218.1
unnamed: R220.1, U201.18 (IMON)
POS12_PGOOD: R218.2, R219.1, R221.1, U201.22 (~FLT); also elsewhere on the board
POS12_SNS+: R207.1; also elsewhere on the board
POS12_SNS-: R213.1; also elsewhere on the board

Notes on the sheet:
UVLO threshold set to 11.12V OVLO threshold set to 13.33V MODE set to Circuit Breaker with Auto-Retry Output Current Limit set to 1.2A Output ramp rate = 12.5V/ms
+3.3V Logic Level

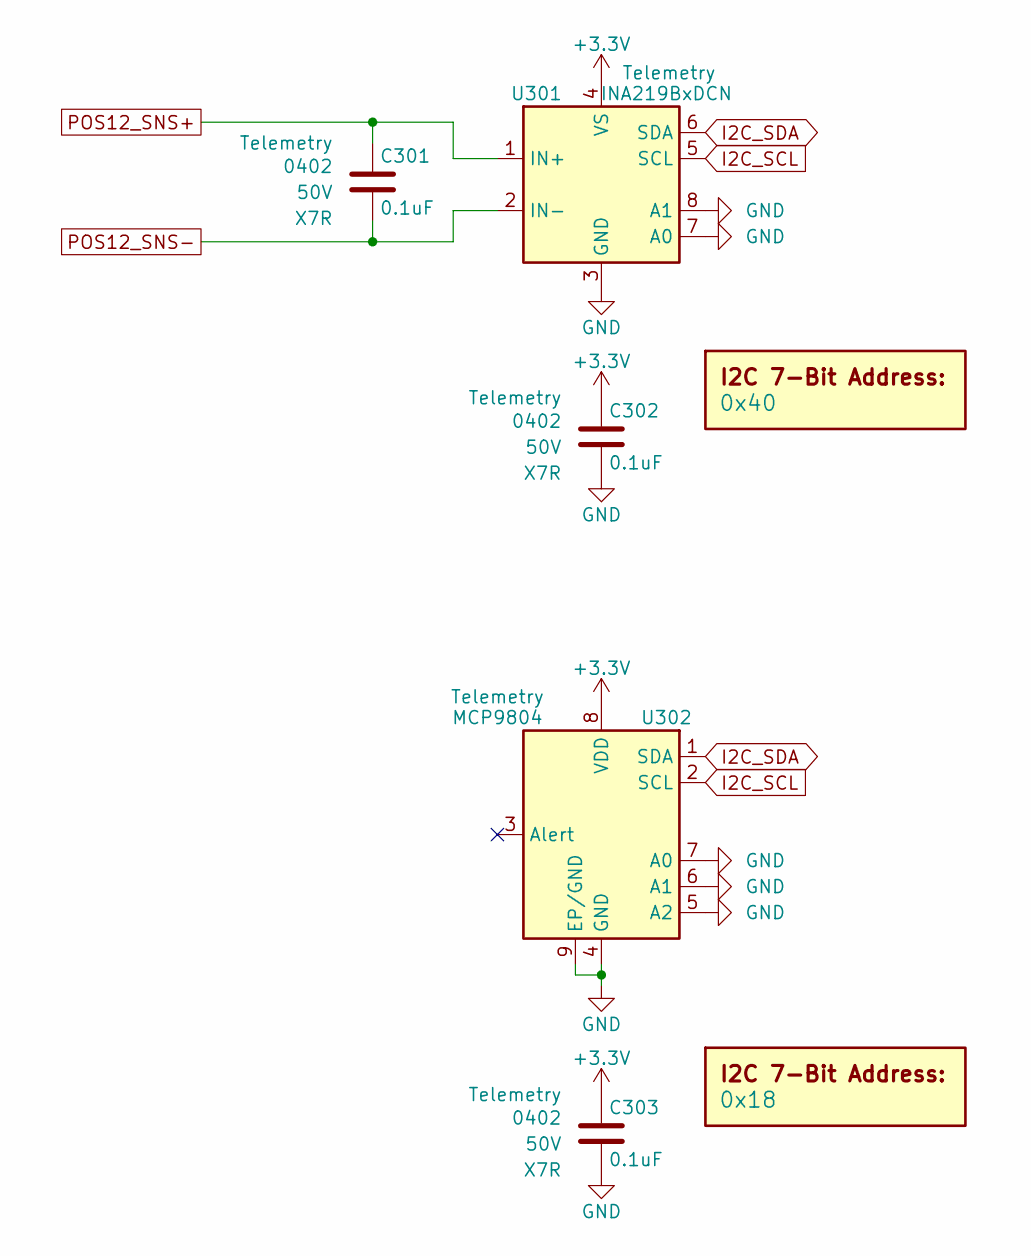
[picture p38: schematic POS12_Telemetry.sch, LED Panel Controller]

Parts:
C301, C302, C303: 0.1uF; C_0402; Voltage 50V; Digi-Key PN 490-10698-1-ND
DOC301: 0x40
DOC302: 0x18
U301: INA219BxDCN; SOT-23-8; Digi-Key PN 296-46420-1-ND
U302: MCP9804; DFN-8-1EP_3x2mm_P0.5mm_EP1.3x1.5mm; Digi-Key PN MCP9804T-E/MCCT-ND

Connections:
I2C_SCL: U301.5 (SCL), U302.2 (SCL); also elsewhere on the board
I2C_SDA: U301.6 (SDA), U302.1 (SDA); also elsewhere on the board
POS12_SNS+: C301.1, U301.1 (IN+); also elsewhere on the board
POS12_SNS-: C301.2, U301.2 (IN-); also elsewhere on the board

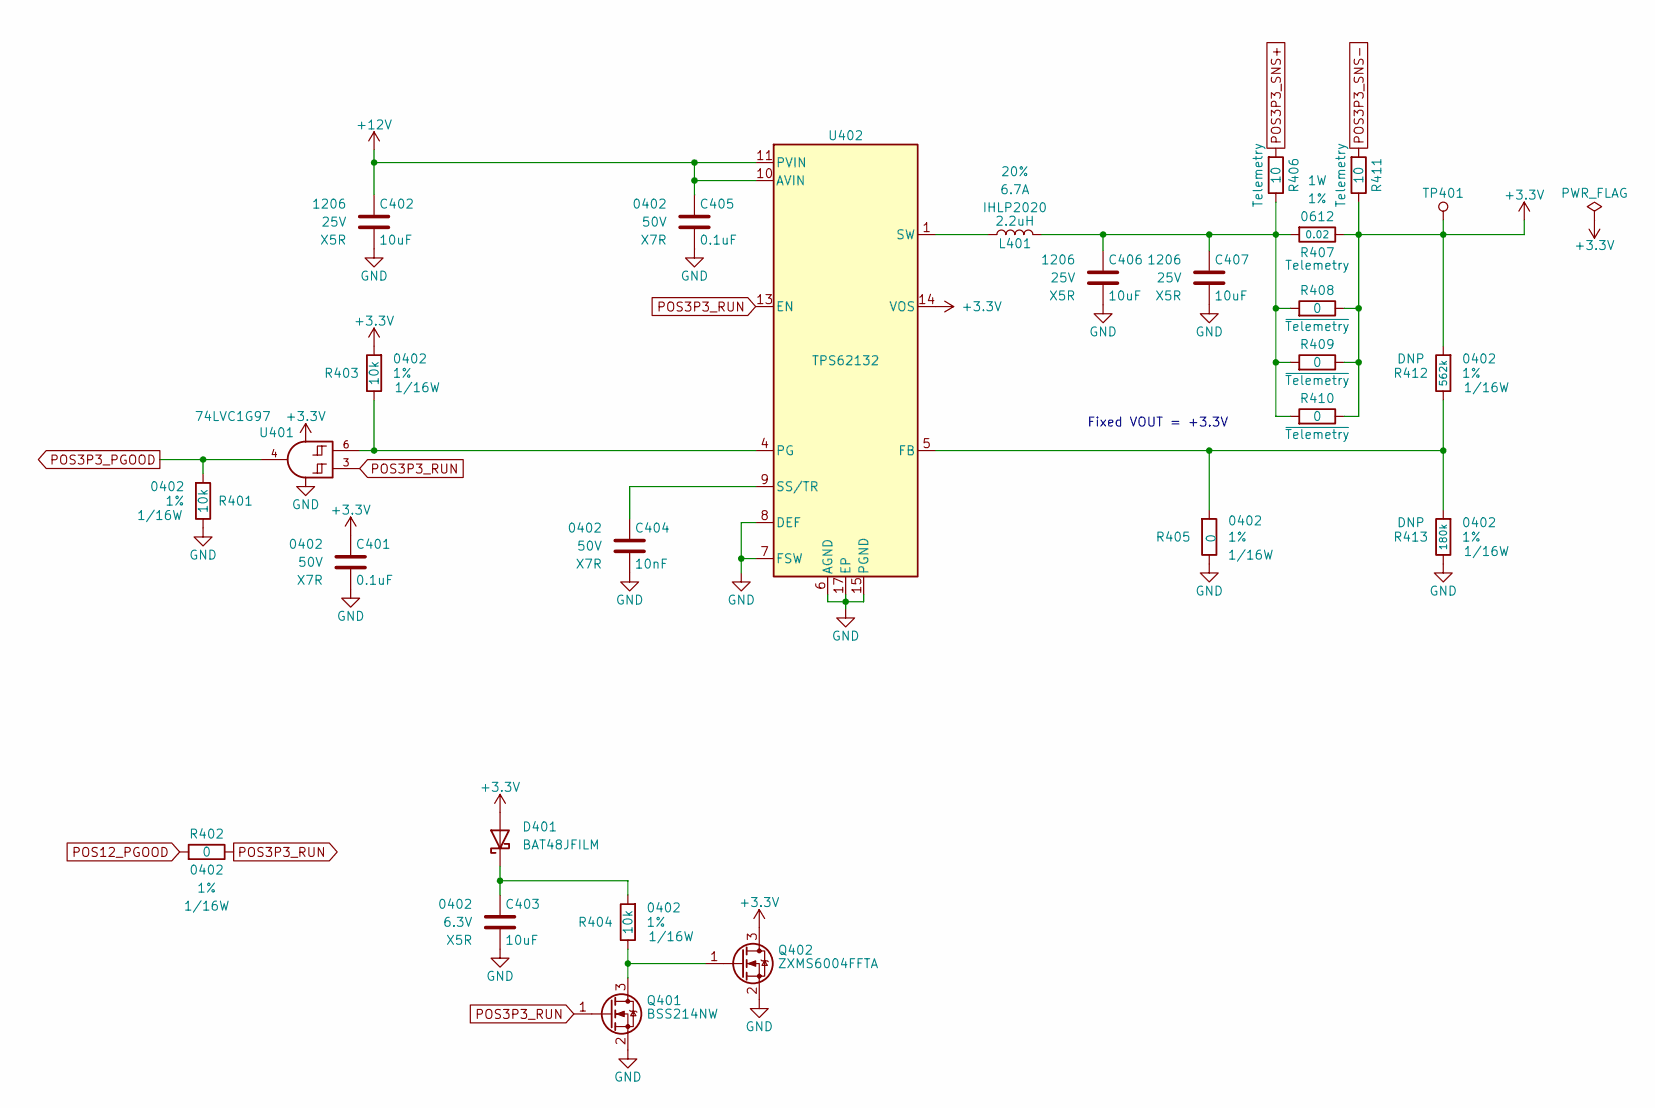
[picture p39: schematic POS3P3_Power_Supply.sch, LED Panel Controller]

Parts:
C401, C405: 0.1uF; C_0402; Voltage 50V; Digi-Key PN 490-10698-1-ND
C402, C406, C407: 10uF; C_1206; Voltage 25V; Digi-Key PN 399-8153-1-ND
C403: 10uF; C_0402; Voltage 6.3V; Digi-Key PN 1276-1451-1-ND
C404: 10nF; C_0402; Voltage 50V; Digi-Key PN 399-3066-1-ND
D401: BAT48JFILM; D_SOD-323; Digi-Key PN 497-5711-1-ND
L401: 2.2uH; L_Vishay_IHLP-2020; Tolerance 20%; Digi-Key PN 541-1236-1-ND
Q401: BSS214NW; SOT-323_SC-70; Digi-Key PN BSS214NWH6327XTSA1CT-ND
Q402: ZXMS6004FFTA; SOT-23; Digi-Key PN ZXMS6004FFCT-ND
R401, R403, R404: 10k; R_0402; Tolerance 1%; Digi-Key PN RMCF0402FT10K0CT-ND
R402, R405, R408, R409, R410: 0; R_0402; Tolerance 1%; Digi-Key PN RMCF0402ZT0R00CT-ND
R406, R411: 10; R_0402; Tolerance 1%; Digi-Key PN RMCF0402FT10R0CT-ND
R407: 0.02; R_0612; Tolerance 1%; Digi-Key PN P16010CT-ND
R412: 562k; R_0402; Tolerance 1%; Digi-Key PN RMCF0402FT562KCT-ND
R413: 180k; R_0402; Tolerance 1%; Digi-Key PN RMCF0402FT180KCT-ND
TP401: TP; Test_Point
U401: 74LVC1G97; SOT-363_SC-70-6; Digi-Key PN 1727-1772-1-ND
U402: TPS62132; QFN-16-1EP_3x3mm_P0.5mm_EP1.8x1.8mm; Digi-Key PN 296-29936-1-ND

Connections:
+12V: C402.1, C405.1, U402.10 (AVIN), U402.11 (PVIN), U402.12 (PVIN); also elsewhere on the board
unnamed: C403.1, D401.1 (K), R404.1
unnamed: C404.1, U402.9 (SS/TR)
unnamed: C406.1, C407.1, L401.2, R406.2, R407.1, R408.1, R409.1, R410.1
unnamed: L401.1, U402.1 (SW), U402.2 (SW), U402.3 (SW)
unnamed: Q401.3 (D), Q402.1 (G), R404.2
unnamed: R403.2, U401.6, U402.4 (PG)
unnamed: R405.1, R412.2, R413.1, U402.5 (FB)
POS3P3_PGOOD: R401.1, U401.4; also elsewhere on the board
POS3P3_RUN: Q401.1 (G), R402.2, U401.3, U402.13 (EN)
POS3P3_SNS+: R406.1; also elsewhere on the board
POS3P3_SNS-: R411.1; also elsewhere on the board
POS12_PGOOD: R402.1; also elsewhere on the board

Notes on the sheet:
Fixed VOUT = +3.3V

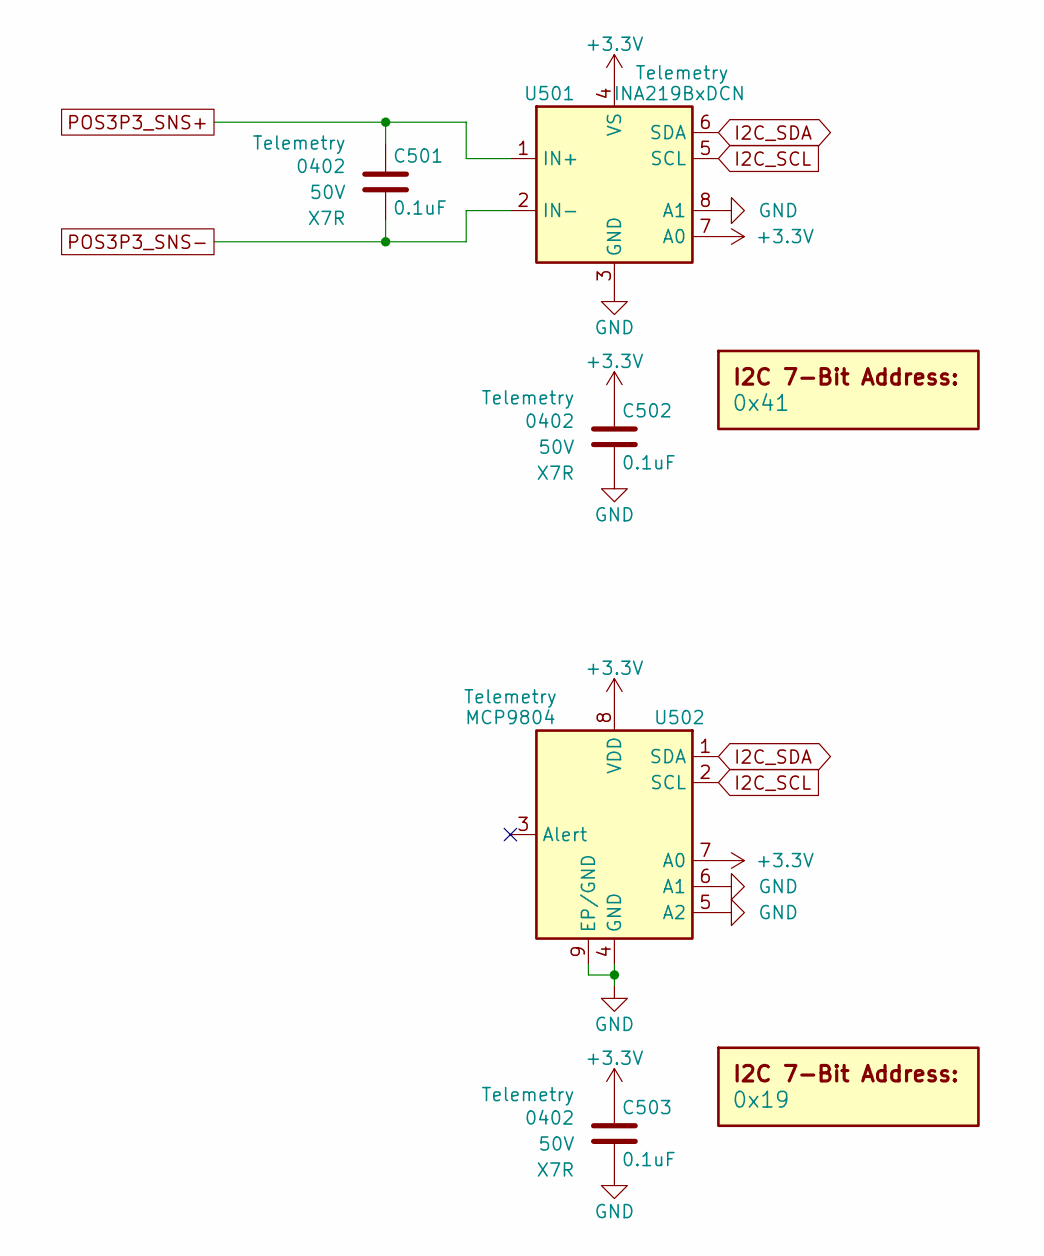
[picture p40: schematic POS3P3_Telemetry.sch, LED Panel Controller]

Parts:
C501, C502, C503: 0.1uF; C_0402; Voltage 50V; Digi-Key PN 490-10698-1-ND
DOC501: 0x41
DOC502: 0x19
U501: INA219BxDCN; SOT-23-8; Digi-Key PN 296-46420-1-ND
U502: MCP9804; DFN-8-1EP_3x2mm_P0.5mm_EP1.3x1.5mm; Digi-Key PN MCP9804T-E/MCCT-ND

Connections:
I2C_SCL: U501.5 (SCL), U502.2 (SCL); also elsewhere on the board
I2C_SDA: U501.6 (SDA), U502.1 (SDA); also elsewhere on the board
POS3P3_SNS+: C501.1, U501.1 (IN+); also elsewhere on the board
POS3P3_SNS-: C501.2, U501.2 (IN-); also elsewhere on the board

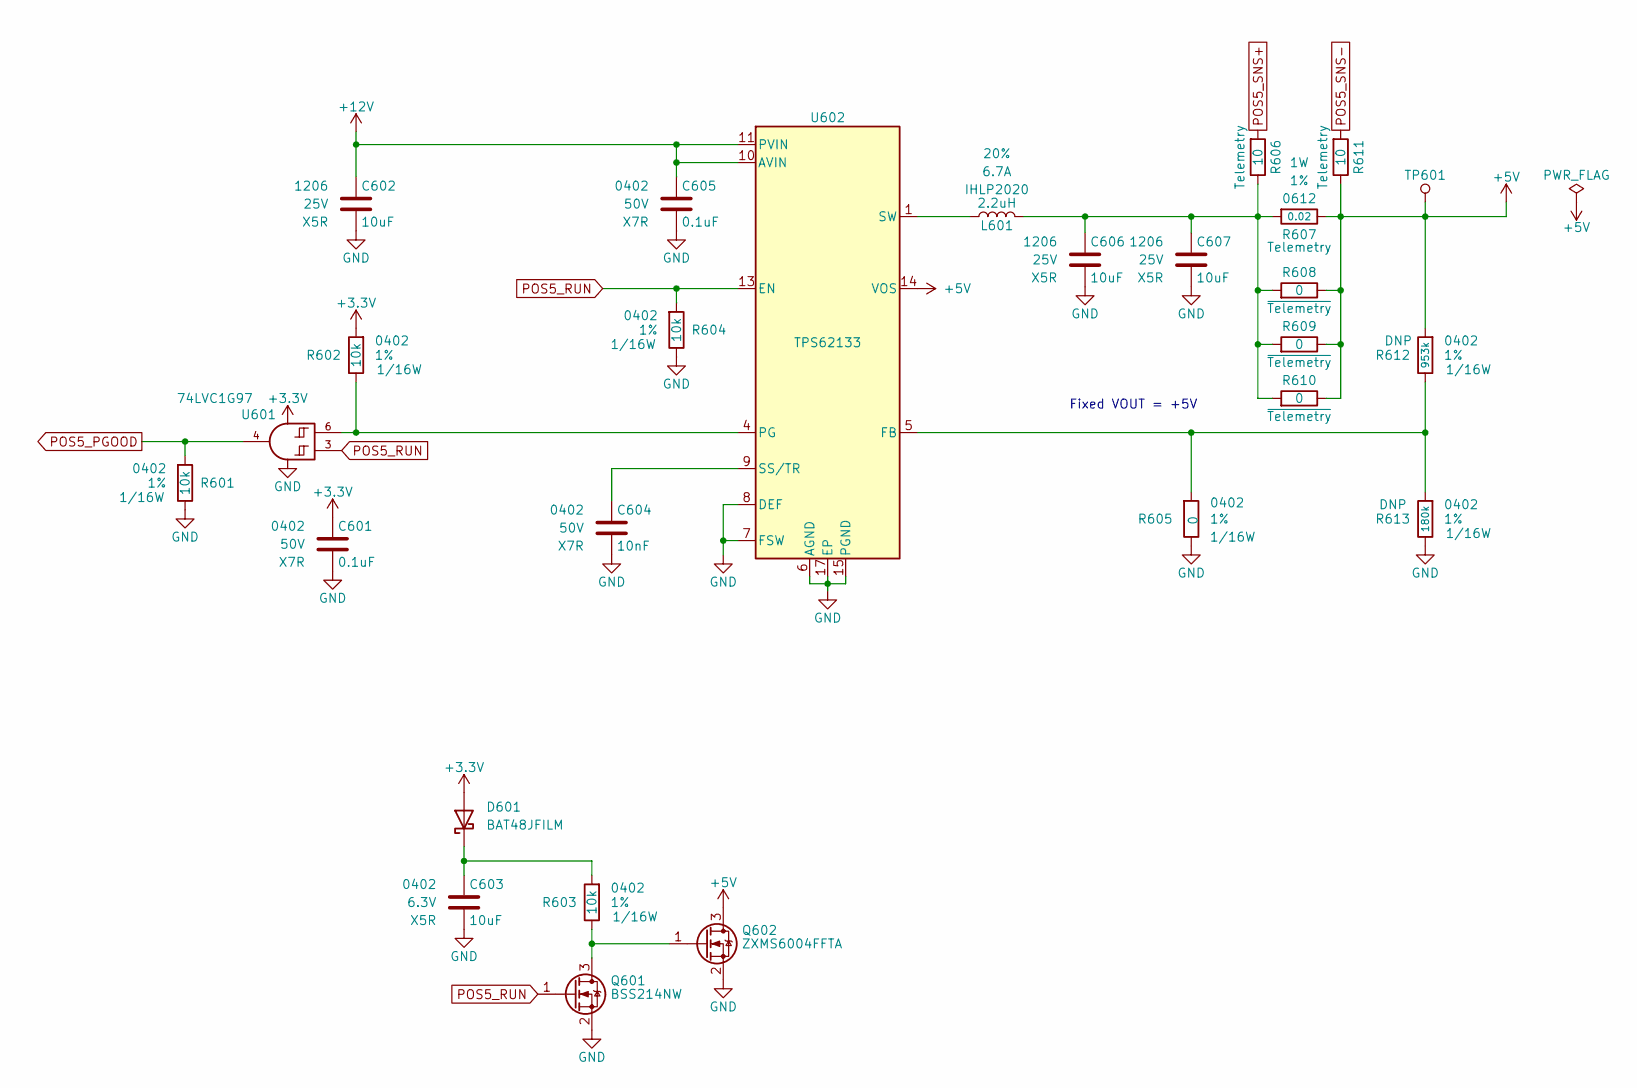
[picture p41: schematic POS5_Power_Supply.sch, LED Panel Controller]

Parts:
C601, C605: 0.1uF; C_0402; Voltage 50V; Digi-Key PN 490-10698-1-ND
C602, C606, C607: 10uF; C_1206; Voltage 25V; Digi-Key PN 399-8153-1-ND
C603: 10uF; C_0402; Voltage 6.3V; Digi-Key PN 1276-1451-1-ND
C604: 10nF; C_0402; Voltage 50V; Digi-Key PN 399-3066-1-ND
D601: BAT48JFILM; D_SOD-323; Digi-Key PN 497-5711-1-ND
L601: 2.2uH; L_Vishay_IHLP-2020; Tolerance 20%; Digi-Key PN 541-1236-1-ND
Q601: BSS214NW; SOT-323_SC-70; Digi-Key PN BSS214NWH6327XTSA1CT-ND
Q602: ZXMS6004FFTA; SOT-23; Digi-Key PN ZXMS6004FFCT-ND
R601, R602, R603, R604: 10k; R_0402; Tolerance 1%; Digi-Key PN RMCF0402FT10K0CT-ND
R605, R608, R609, R610: 0; R_0402; Tolerance 1%; Digi-Key PN RMCF0402ZT0R00CT-ND
R606, R611: 10; R_0402; Tolerance 1%; Digi-Key PN RMCF0402FT10R0CT-ND
R607: 0.02; R_0612; Tolerance 1%; Digi-Key PN P16010CT-ND
R612: 953k; R_0402; Tolerance 1%; Digi-Key PN RMCF0402FT953KCT-ND
R613: 180k; R_0402; Tolerance 1%; Digi-Key PN RMCF0402FT180KCT-ND
TP601: TP; Test_Point
U601: 74LVC1G97; SOT-363_SC-70-6; Digi-Key PN 1727-1772-1-ND
U602: TPS62133; QFN-16-1EP_3x3mm_P0.5mm_EP1.8x1.8mm; Digi-Key PN 296-30225-1-ND

Connections:
+5V: Q602.3 (D), R607.2, R608.2, R609.2, R610.2, R611.2, R612.1, TP601.1, U602.14 (VOS); also elsewhere on the board
+12V: C602.1, C605.1, U602.10 (AVIN), U602.11 (PVIN), U602.12 (PVIN); also elsewhere on the board
unnamed: C603.1, D601.1 (K), R603.1
unnamed: C604.1, U602.9 (SS/TR)
unnamed: C606.1, C607.1, L601.2, R606.2, R607.1, R608.1, R609.1, R610.1
unnamed: L601.1, U602.1 (SW), U602.2 (SW), U602.3 (SW)
unnamed: Q601.3 (D), Q602.1 (G), R603.2
unnamed: R602.2, U601.6, U602.4 (PG)
unnamed: R605.1, R612.2, R613.1, U602.5 (FB)
POS5_PGOOD: R601.1, U601.4; also elsewhere on the board
POS5_RUN: Q601.1 (G), R604.1, U601.3, U602.13 (EN); also elsewhere on the board
POS5_SNS+: R606.1; also elsewhere on the board
POS5_SNS-: R611.1; also elsewhere on the board

Notes on the sheet:
Fixed VOUT = +5V

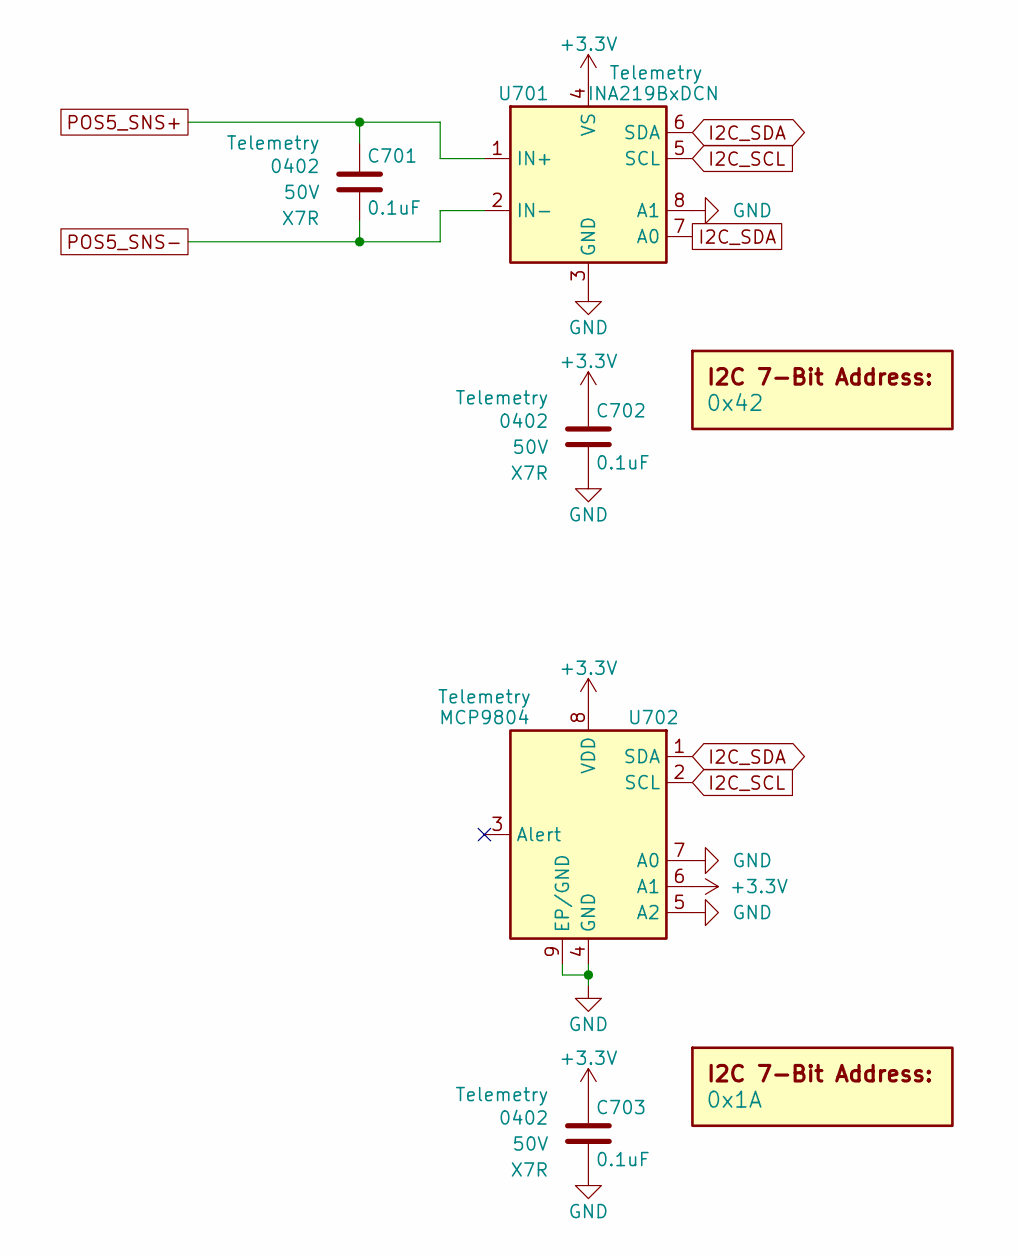
[picture p42: schematic POS5_Telemetry.sch, LED Panel Controller]

Parts:
C701, C702, C703: 0.1uF; C_0402; Voltage 50V; Digi-Key PN 490-10698-1-ND
DOC701: 0x42
DOC702: 0x1A
U701: INA219BxDCN; SOT-23-8; Digi-Key PN 296-46420-1-ND
U702: MCP9804; DFN-8-1EP_3x2mm_P0.5mm_EP1.3x1.5mm; Digi-Key PN MCP9804T-E/MCCT-ND

Connections:
I2C_SCL: U701.5 (SCL), U702.2 (SCL); also elsewhere on the board
I2C_SDA: U701.6 (SDA), U701.7 (A0), U702.1 (SDA); also elsewhere on the board
POS5_SNS+: C701.1, U701.1 (IN+); also elsewhere on the board
POS5_SNS-: C701.2, U701.2 (IN-); also elsewhere on the board

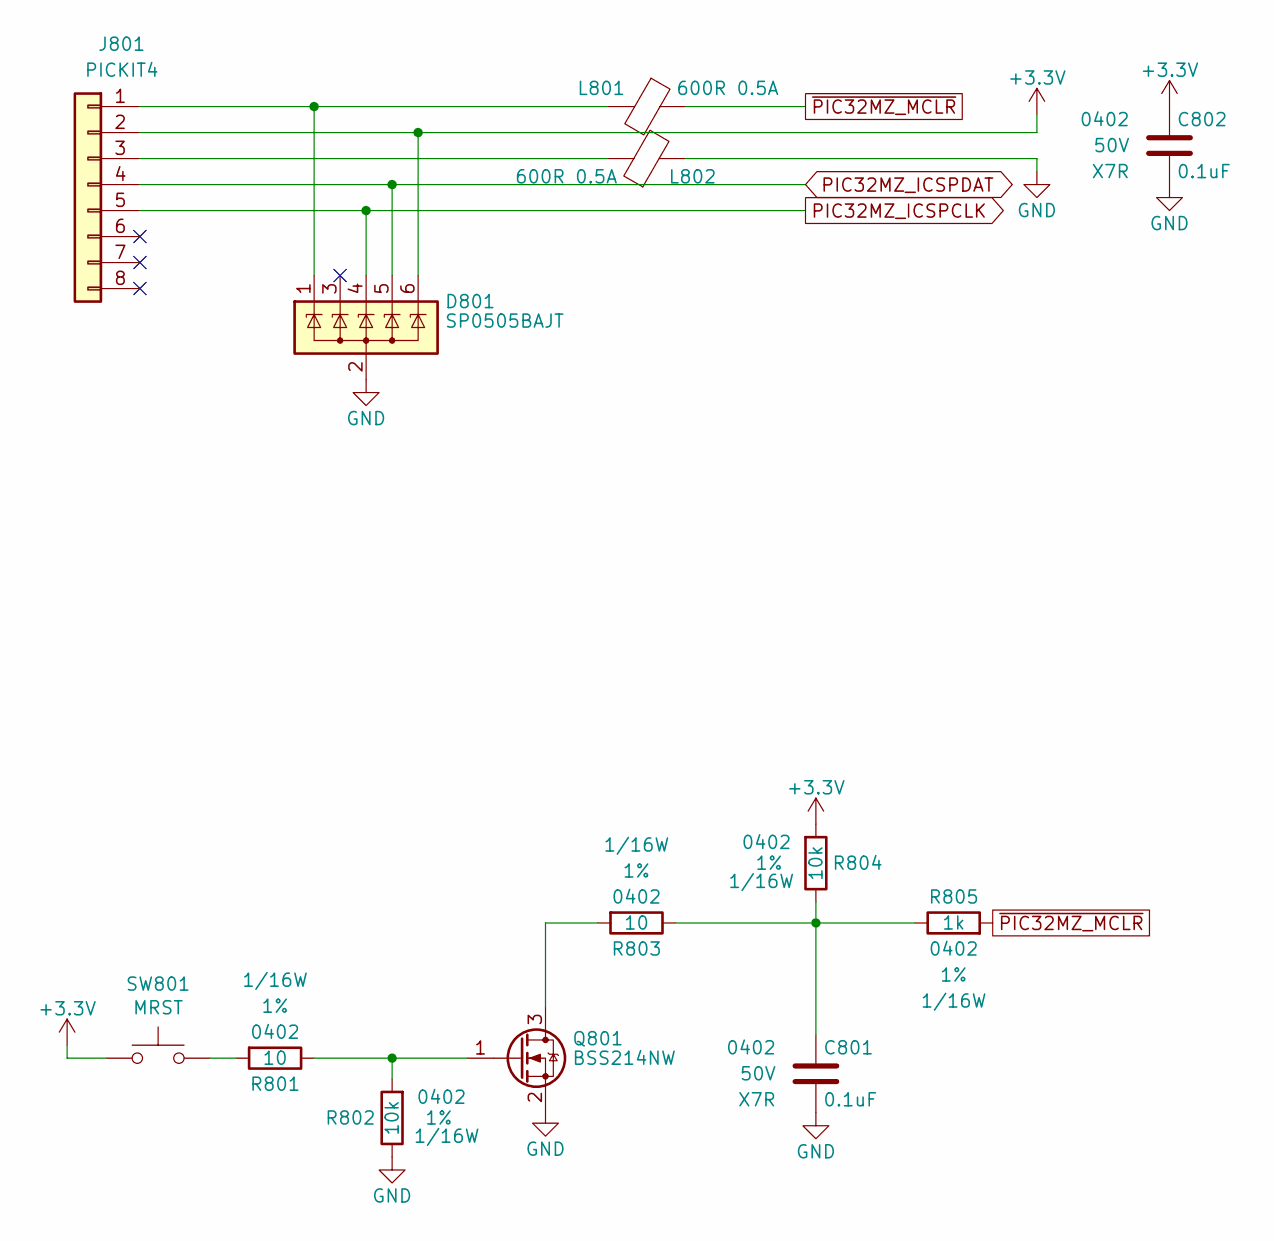
[picture p43: schematic PIC32MZ_Programming.sch, LED Panel Controller]

Parts:
C801, C802: 0.1uF; C_0402; Voltage 50V; Digi-Key PN 490-10698-1-ND
D801: SP0505BAJT; SOT-363_SC-70-6; Digi-Key PN F3160CT-ND
J801: PICKIT4; PICKIT4_Header
L801, L802: 600R 0.5A; L_0402; Digi-Key PN 490-5441-1-ND
Q801: BSS214NW; SOT-323_SC-70; Digi-Key PN BSS214NWH6327XTSA1CT-ND
R801, R803: 10; R_0402; Tolerance 1%; Digi-Key PN RMCF0402FT10R0CT-ND
R802, R804: 10k; R_0402; Tolerance 1%; Digi-Key PN RMCF0402FT10K0CT-ND
R805: 1k; R_0402; Tolerance 1%; Digi-Key PN RMCF0402FT1K00CT-ND
SW801: MRST; SW_PUSH_6mm

Connections:
unnamed: C801.1, R803.2, R804.2, R805.2
unnamed: D801.1 (K), J801.1, L801.2
unnamed: J801.3, L802.1
unnamed: Q801.1 (G), R801.2, R802.1
unnamed: Q801.3 (D), R803.1
unnamed: R801.1, SW801.2
PIC32MZ_ICSPCLK: D801.4 (K), J801.5; also elsewhere on the board
PIC32MZ_ICSPDAT: D801.5 (K), J801.4; also elsewhere on the board
~PIC32MZ_MCLR: L801.1, R805.1; also elsewhere on the board

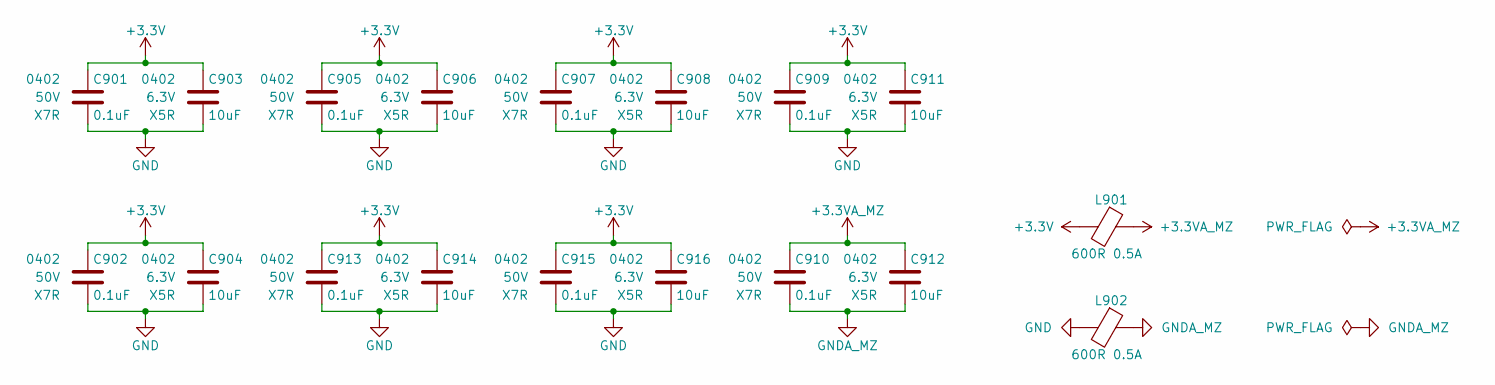
[picture p44: schematic PIC32MZ_Bypass.sch, LED Panel Controller]

Parts:
C901, C902, C905, C907, C909, C910, C913, C915: 0.1uF; C_0402; Voltage 50V; Digi-Key PN 490-10698-1-ND
C903, C904, C906, C908, C911, C912, C914, C916: 10uF; C_0402; Voltage 6.3V; Digi-Key PN 1276-1451-1-ND
L901, L902: 600R 0.5A; L_0402; Digi-Key PN 490-5441-1-ND

Connections:
+3.3VA_MZ: C910.1, C912.1, L901.1; also elsewhere on the board
GNDA_MZ: C910.2, C912.2, L902.1; also elsewhere on the board

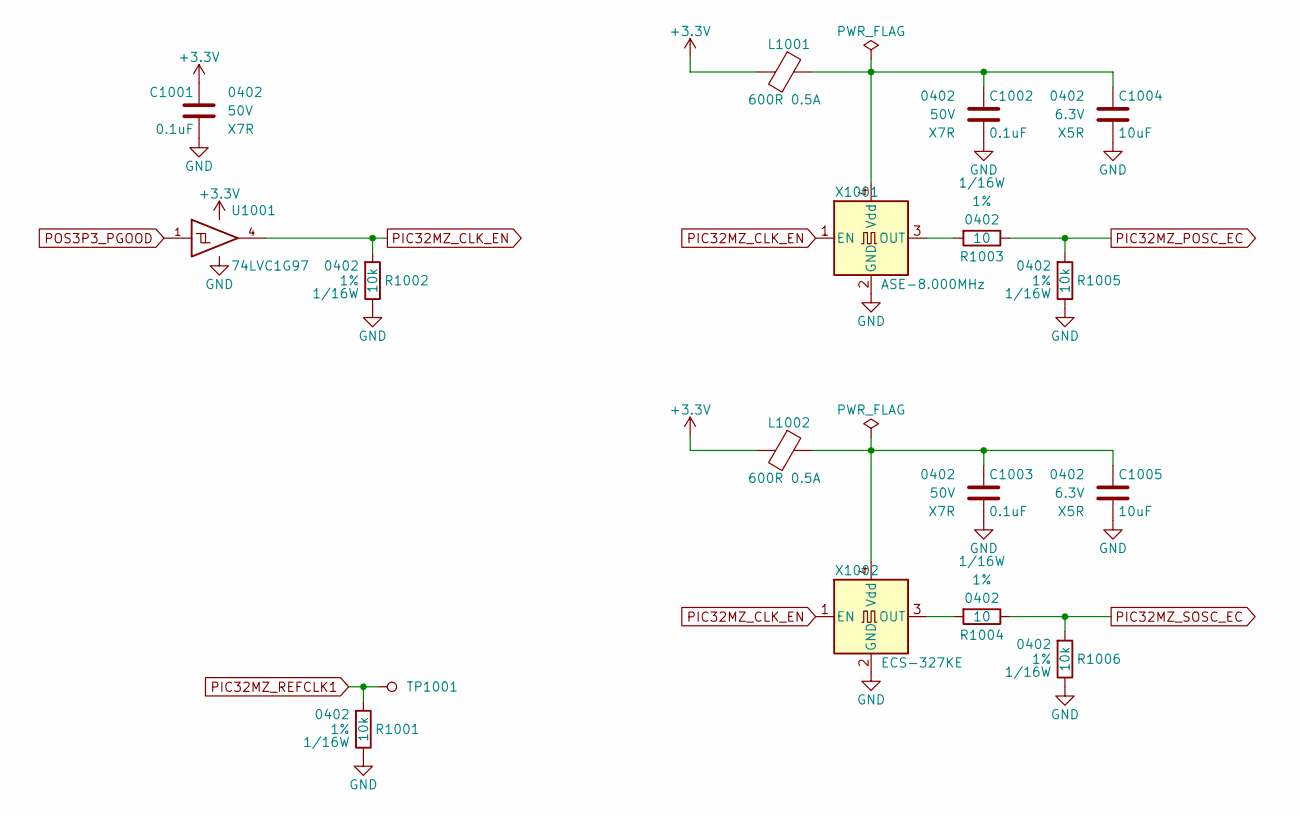
[picture p45: schematic PIC32MZ_Clocking.sch, LED Panel Controller]

Parts:
C1001, C1002, C1003: 0.1uF; C_0402; Voltage 50V; Digi-Key PN 490-10698-1-ND
C1004, C1005: 10uF; C_0402; Voltage 6.3V; Digi-Key PN 1276-1451-1-ND
L1001, L1002: 600R 0.5A; L_0402; Digi-Key PN 490-5441-1-ND
R1001, R1002, R1005, R1006: 10k; R_0402; Tolerance 1%; Digi-Key PN RMCF0402FT10K0CT-ND
R1003, R1004: 10; R_0402; Tolerance 1%; Digi-Key PN RMCF0402FT10R0CT-ND
TP1001: TP; Test_Point
U1001: 74LVC1G97; SOT-363_SC-70-6; Digi-Key PN 1727-1772-1-ND
X1001: ASE-8.000MHz; Oscillator_SMD_Abracon_ASE-4Pin_3.2x2.5mm; Digi-Key PN 535-9558-1-ND
X1002: ECS-327KE; Digi-Key PN XC1751CT-ND

Connections:
unnamed: C1002.1, C1004.1, L1001.1, X1001.4 (Vdd)
unnamed: C1003.1, C1005.1, L1002.1, X1002.4 (Vdd)
unnamed: R1003.1, X1001.3 (OUT)
unnamed: R1004.1, X1002.3 (OUT)
PIC32MZ_CLK_EN: R1002.1, U1001.4, X1001.1 (EN), X1002.1 (EN)
PIC32MZ_POSC_EC: R1003.2, R1005.1; also elsewhere on the board
PIC32MZ_REFCLK1: R1001.1, TP1001.1; also elsewhere on the board
PIC32MZ_SOSC_EC: R1004.2, R1006.1; also elsewhere on the board
POS3P3_PGOOD: U1001.1; also elsewhere on the board
