drewsum/LED_Panel_Controller/hdw/LED_Panel_Controller/LED_Panel_Controller.kicad_pcb

## KiCad design hdw/LED_Panel_Controller/LED_Panel_Controller.kicad_pcb (continued)

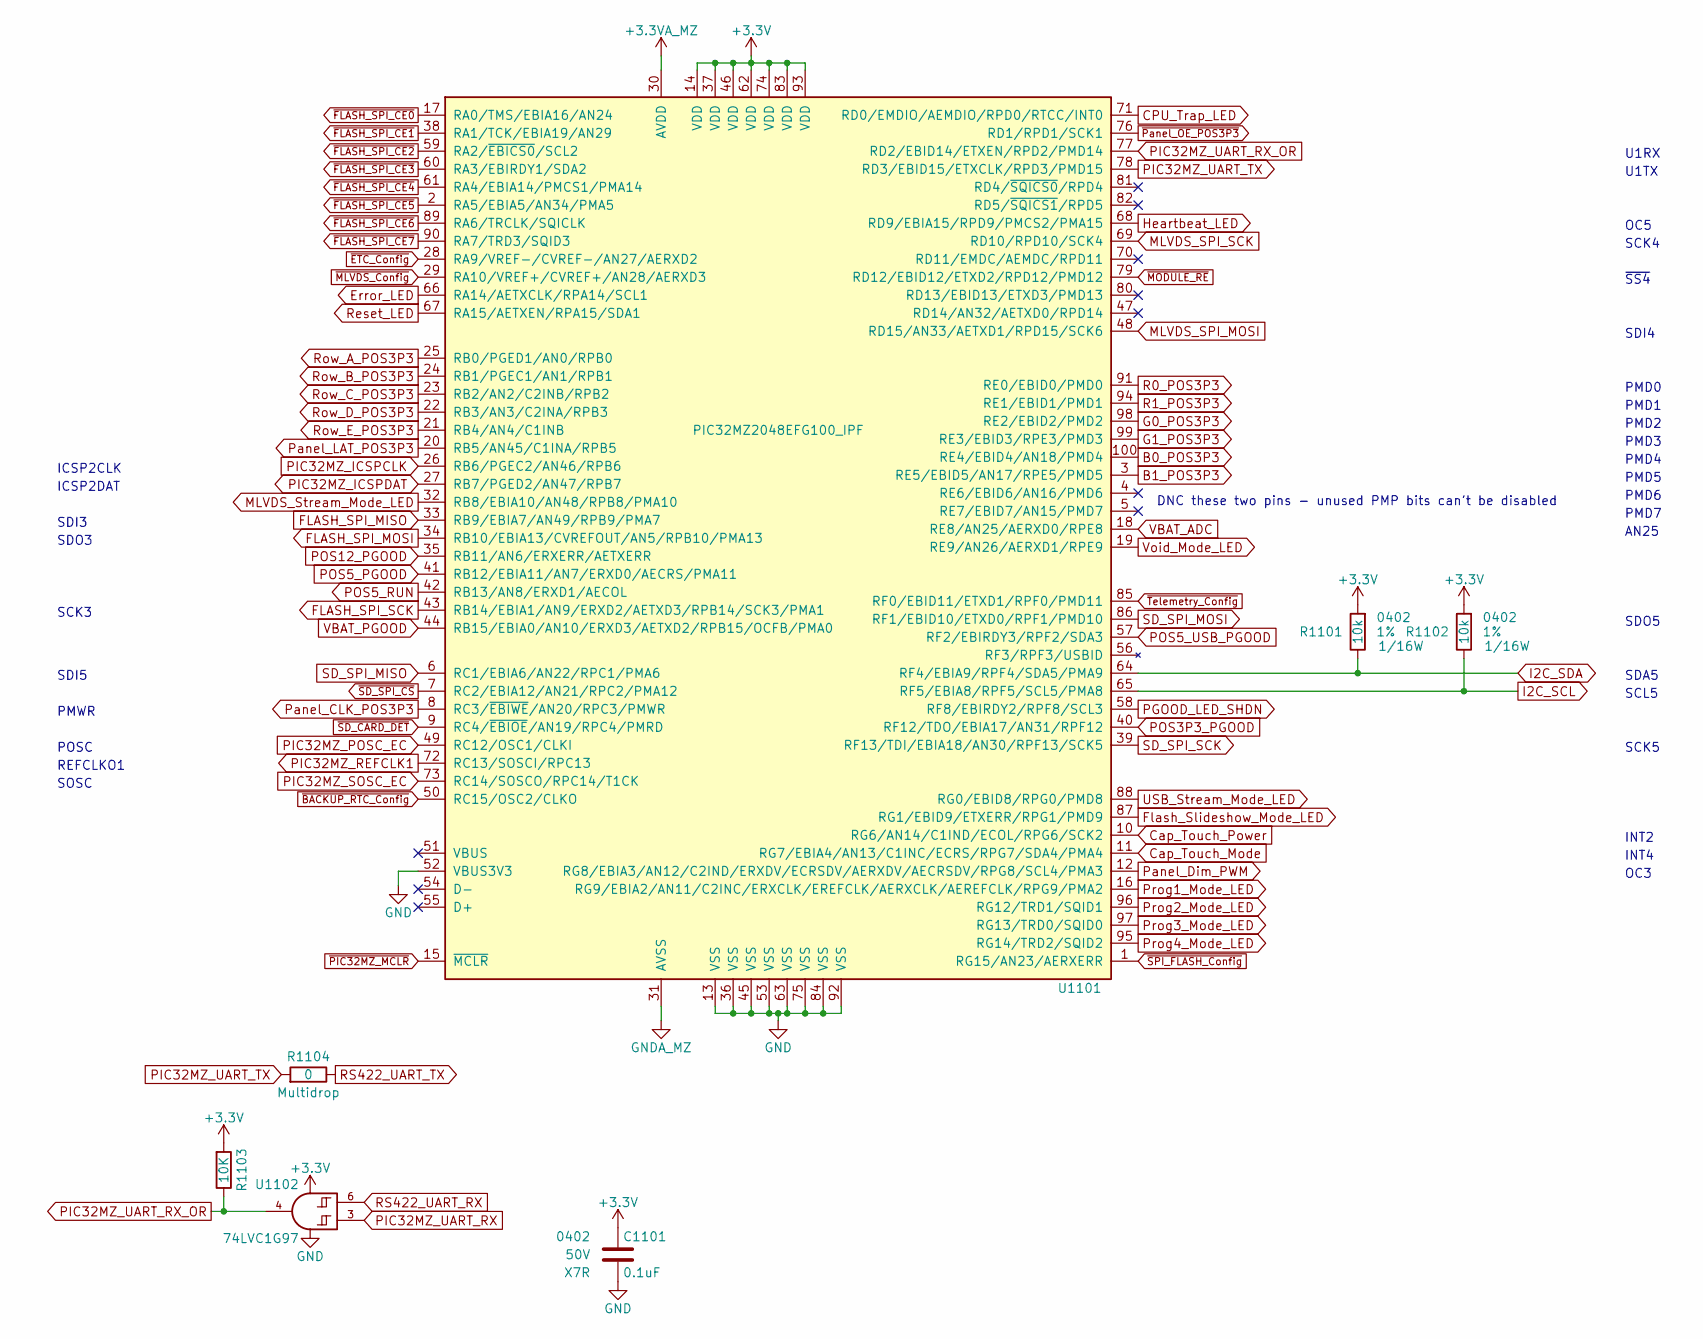
[picture p46: schematic PIC32MZ.sch, LED Panel Controller]

Parts:
C1101: 0.1uF; C_0402; Voltage 50V; Digi-Key PN 490-10698-1-ND
R1101, R1102: 10k; R_0402; Tolerance 1%; Digi-Key PN RMCF0402FT10K0CT-ND
R1103: 10K; R_0402; Tolerance 1%; Digi-Key PN RMCF0402FT10K0CT-ND
R1104: 0; R_0402; Tolerance 1%; Digi-Key PN RMCF0402ZT0R00CT-ND
U1101: PIC32MZ2048EFG100_IPF; TQFP-100_14x14mm_Pitch0.5mm; Digi-Key PN PIC32MZ2048EFG100-I/PF-ND
U1102: 74LVC1G97; SOT-363_SC-70-6; Digi-Key PN 1727-1772-1-ND

Connections:
+3.3VA_MZ: U1101.30 (AVDD); also elsewhere on the board
B0_POS3P3: U1101.100 (RE4/EBID4/AN18/PMD4); also elsewhere on the board
B1_POS3P3: U1101.3 (RE5/EBID5/AN17/RPE5/PMD5); also elsewhere on the board
CPU_Trap_LED: U1101.71 (RD0/EMDIO/AEMDIO/RPD0/RTCC/INT0); also elsewhere on the board
Cap_Touch_Mode: U1101.11 (RG7/EBIA4/AN13/C1INC/ECRS/RPG7/SDA4/PMA4); also elsewhere on the board
Cap_Touch_Power: U1101.10 (RG6/AN14/C1IND/ECOL/RPG6/SCK2); also elsewhere on the board
Error_LED: U1101.66 (RA14/AETXCLK/RPA14/SCL1); also elsewhere on the board
FLASH_SPI_MISO: U1101.33 (RB9/EBIA7/AN49/RPB9/PMA7); also elsewhere on the board
FLASH_SPI_MOSI: U1101.34 (RB10/EBIA13/CVREFOUT/AN5/RPB10/PMA13); also elsewhere on the board
FLASH_SPI_SCK: U1101.43 (RB14/EBIA1/AN9/ERXD2/AETXD3/RPB14/SCK3/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); also elsewhere on the board
Flash_Slideshow_Mode_LED: U1101.87 (RG1/EBID9/ETXERR/RPG1/PMD9); also elsewhere on the board
G0_POS3P3: U1101.98 (RE2/EBID2/PMD2); also elsewhere on the board
G1_POS3P3: U1101.99 (RE3/EBID3/RPE3/PMD3); also elsewhere on the board
GNDA_MZ: U1101.31 (AVSS); also elsewhere on the board
Heartbeat_LED: U1101.68 (RD9/EBIA15/RPD9/PMCS2/PMA15); also elsewhere on the board
I2C_SCL: R1102.2, U1101.65 (RF5/EBIA8/RPF5/SCL5/PMA8); also elsewhere on the board
I2C_SDA: R1101.2, U1101.64 (RF4/EBIA9/RPF4/SDA5/PMA9); also elsewhere on the board
MLVDS_SPI_MOSI: U1101.48 (RD15/AN33/AETXD1/RPD15/SCK6); also elsewhere on the board
MLVDS_SPI_SCK: U1101.69 (RD10/RPD10/SCK4); also elsewhere on the board
MLVDS_Stream_Mode_LED: U1101.32 (RB8/EBIA10/AN48/RPB8/PMA10); also elsewhere on the board
PGOOD_LED_SHDN: U1101.58 (RF8/EBIRDY2/RPF8/SCL3); also elsewhere on the board
PIC32MZ_ICSPCLK: U1101.26 (RB6/PGEC2/AN46/RPB6); also elsewhere on the board
PIC32MZ_ICSPDAT: U1101.27 (RB7/PGED2/AN47/RPB7); also elsewhere on the board
PIC32MZ_POSC_EC: U1101.49 (RC12/OSC1/CLKI); also elsewhere on the board
PIC32MZ_REFCLK1: U1101.72 (RC13/SOSCI/RPC13); also elsewhere on the board
PIC32MZ_SOSC_EC: U1101.73 (RC14/SOSCO/RPC14/T1CK); also elsewhere on the board
PIC32MZ_UART_RX_OR: R1103.2, U1101.77 (RD2/EBID14/ETXEN/RPD2/PMD14), U1102.4
POS3P3_PGOOD: U1101.40 (RF12/TDO/EBIA17/AN31/RPF12); also elsewhere on the board
POS5_PGOOD: U1101.41 (RB12/EBIA11/AN7/ERXD0/AECRS/PMA11); also elsewhere on the board
POS5_RUN: U1101.42 (RB13/AN8/ERXD1/AECOL); also elsewhere on the board
POS5_USB_PGOOD: U1101.57 (RF2/EBIRDY3/RPF2/SDA3); also elsewhere on the board
POS12_PGOOD: U1101.35 (RB11/AN6/ERXERR/AETXERR); also elsewhere on the board
Panel_CLK_POS3P3: U1101.8 (RC3/~EBIWE~/AN20/RPC3/PMWR); also elsewhere on the board
Panel_Dim_PWM: U1101.12 (RG8/EBIA3/AN12/C2IND/ERXDV/ECRSDV/AERXD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); also elsewhere on the board
Panel_LAT_POS3P3: U1101.20 (RB5/AN45/C1INA/RPB5); also elsewhere on the board
Prog1_Mode_LED: U1101.16 (RG9/EBIA2/AN11/C2INC/ERXCLK/EREFCLK/AER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); also elsewhere on the board
Prog2_Mode_LED: U1101.96 (RG12/TRD1/SQID1); also elsewhere on the board
Prog3_Mode_LED: U1101.97 (RG13/TRD0/SQID0); also elsewhere on the board
Prog4_Mode_LED: U1101.95 (RG14/TRD2/SQID2); also elsewhere on the board
R0_POS3P3: U1101.91 (RE0/EBID0/PMD0); also elsewhere on the board
R1_POS3P3: U1101.94 (RE1/EBID1/PMD1); also elsewhere on the board
RS422_UART_RX: U1102.6; also elsewhere on the board
RS422_UART_TX: R1104.2; also elsewhere on the board
Reset_LED: U1101.67 (RA15/AETXEN/RPA15/SDA1); also elsewhere on the board
Row_A_POS3P3: U1101.25 (RB0/PGED1/AN0/RPB0); also elsewhere on the board
Row_B_POS3P3: U1101.24 (RB1/PGEC1/AN1/RPB1); also elsewhere on the board
Row_C_POS3P3: U1101.23 (RB2/AN2/C2INB/RPB2); also elsewhere on the board
Row_D_POS3P3: U1101.22 (RB3/AN3/C2INA/RPB3); also elsewhere on the board
Row_E_POS3P3: U1101.21 (RB4/AN4/C1INB); also elsewhere on the board
SD_SPI_MISO: U1101.6 (RC1/EBIA6/AN22/RPC1/PMA6); also elsewhere on the board
SD_SPI_MOSI: U1101.86 (RF1/EBID10/ETXD0/RPF1/PMD10); also elsewhere on the board
SD_SPI_SCK: U1101.39 (RF13/TDI/EBIA18/AN30/RPF13/SCK5); also elsewhere on the board
USB_Stream_Mode_LED: U1101.88 (RG0/EBID8/RPG0/PMD8); also elsewhere on the board
VBAT_ADC: U1101.18 (RE8/AN25/AERXD0/RPE8); also elsewhere on the board
VBAT_PGOOD: U1101.44 (RB15/EBIA0/AN10/ERXD3/AETXD2/RPB15/OCFB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); also elsewhere on the board
Void_Mode_LED: U1101.19 (RE9/AN26/AERXD1/RPE9); also elsewhere on the board
~FLASH_SPI_CE0: U1101.17 (RA0/TMS/EBIA16/AN24); also elsewhere on the board
~FLASH_SPI_CE1: U1101.38 (RA1/TCK/EBIA19/AN29); also elsewhere on the board
~FLASH_SPI_CE2: U1101.59 (RA2/~EBICS0~/SCL2); also elsewhere on the board
~FLASH_SPI_CE3: U1101.60 (RA3/EBIRDY1/SDA2); also elsewhere on the board
~FLASH_SPI_CE4: U1101.61 (RA4/EBIA14/PMCS1/PMA14); also elsewhere on the board
~FLASH_SPI_CE5: U1101.2 (RA5/EBIA5/AN34/PMA5); also elsewhere on the board
~FLASH_SPI_CE6: U1101.89 (RA6/TRCLK/SQICLK); also elsewhere on the board
~FLASH_SPI_CE7: U1101.90 (RA7/TRD3/SQID3); also elsewhere on the board
~MODULE_RE: U1101.79 (RD12/EBID12/ETXD2/RPD12/PMD12); also elsewhere on the board
~PIC32MZ_MCLR: U1101.15 (~MCLR~); also elsewhere on the board
~Panel_OE_POS3P3: U1101.76 (RD1/RPD1/SCK1); also elsewhere on the board
~SD_CARD_DET: U1101.9 (RC4/~EBIOE~/AN19/RPC4/PMRD); also elsewhere on the board
~SD_SPI_CS: U1101.7 (RC2/EBIA12/AN21/RPC2/PMA12); also elsewhere on the board
~SPI_FLASH_Config: U1101.1 (RG15/AN23/AERXERR); also elsewhere on the board
~Telemetry_Config: U1101.85 (RF0/EBID11/ETXD1/RPF0/PMD11); also elsewhere on the board

Notes on the sheet:
SDA5
ICSP2CLK
POSC
REFCLKO1
SOSC
U1RX
U1TX
PMD0
PMD1
PMD2
PMD3
PMD4
PMD5
PMWR
ICSP2DAT
SCL5
PMD7
PMD6
DNC these two pins - unused PMP bits can't be disabled
OC3
SCK3
SDO3
SDI3
SCK4
SCK5
SDI5
SDO5
OC5
AN25
INT2
INT4
~SS4
SDI4

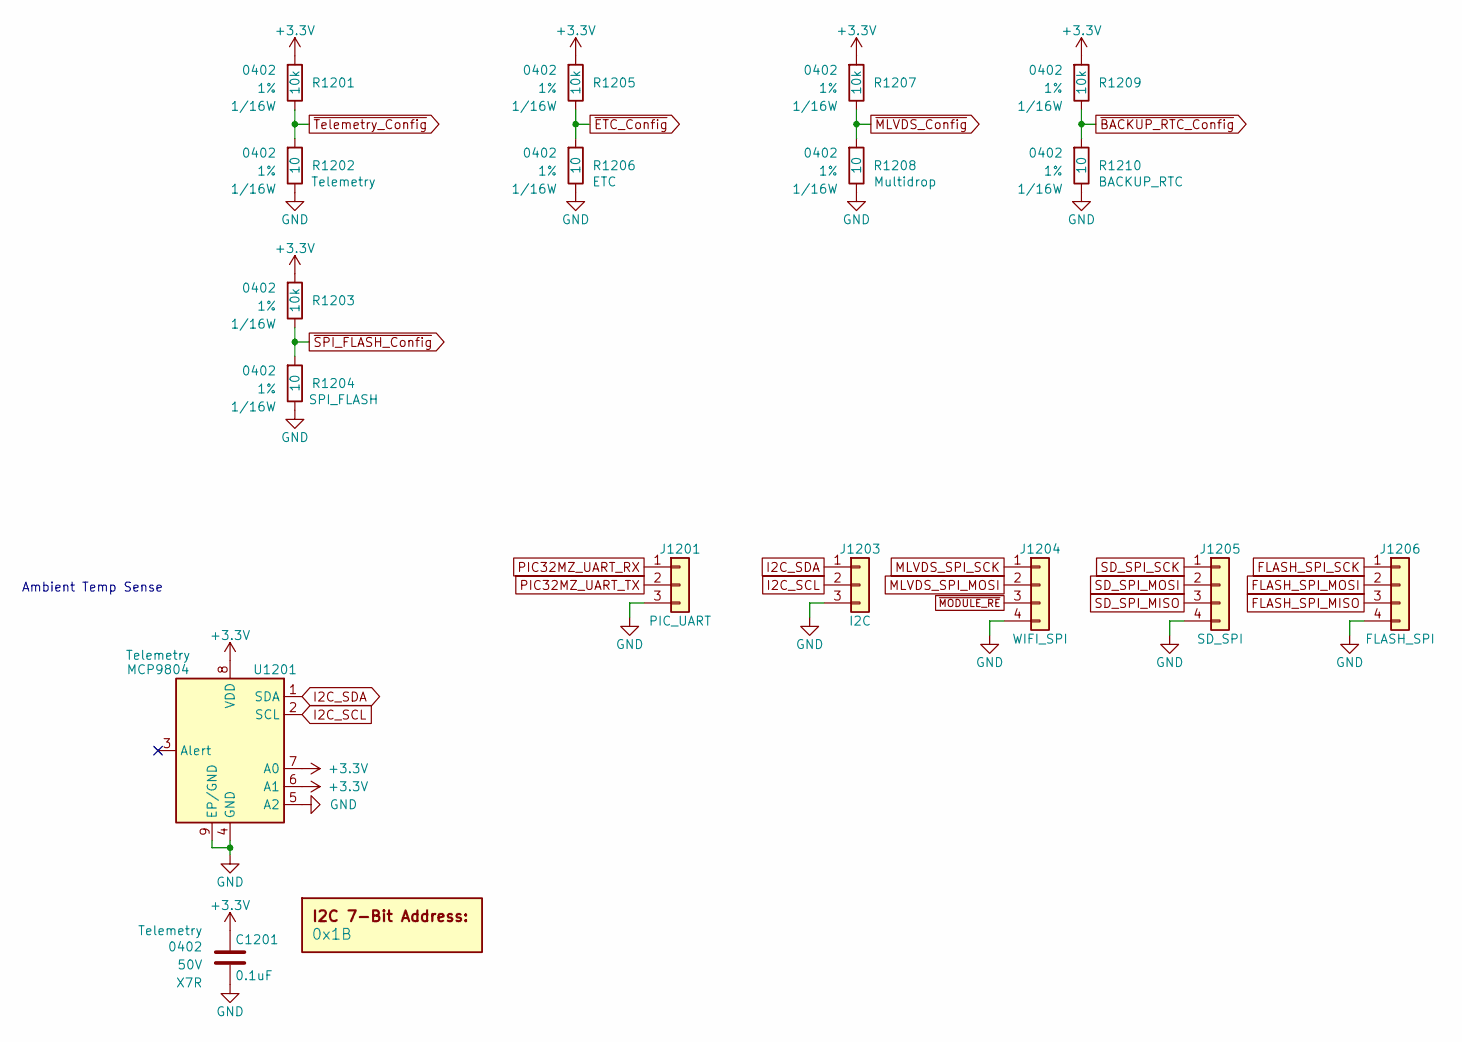
[picture p47: schematic config_hardstraps.sch, LED Panel Controller]

Parts:
C1201: 0.1uF; C_0402; Voltage 50V; Digi-Key PN 490-10698-1-ND
DOC1201: 0x1B
J1201: PIC_UART; PinHeader_1x03_P2.54mm_Vertical
J1203: I2C; PinHeader_1x03_P2.54mm_Vertical
J1204: WIFI_SPI; PinHeader_1x04_P2.54mm_Vertical
J1205: SD_SPI; PinHeader_1x04_P2.54mm_Vertical
J1206: FLASH_SPI; PinHeader_1x04_P2.54mm_Vertical
R1201, R1203, R1205, R1207, R1209: 10k; R_0402; Tolerance 1%; Digi-Key PN RMCF0402FT10K0CT-ND
R1202, R1204, R1206, R1208, R1210: 10; R_0402; Tolerance 1%; Digi-Key PN RMCF0402FT10R0CT-ND
U1201: MCP9804; DFN-8-1EP_3x2mm_P0.5mm_EP1.3x1.5mm; Digi-Key PN MCP9804T-E/MCCT-ND

Connections:
FLASH_SPI_MISO: J1206.3; also elsewhere on the board
FLASH_SPI_MOSI: J1206.2; also elsewhere on the board
FLASH_SPI_SCK: J1206.1; also elsewhere on the board
I2C_SCL: J1203.2, U1201.2 (SCL); also elsewhere on the board
I2C_SDA: J1203.1, U1201.1 (SDA); also elsewhere on the board
MLVDS_SPI_MOSI: J1204.2; also elsewhere on the board
MLVDS_SPI_SCK: J1204.1; also elsewhere on the board
SD_SPI_MISO: J1205.3; also elsewhere on the board
SD_SPI_MOSI: J1205.2; also elsewhere on the board
SD_SPI_SCK: J1205.1; also elsewhere on the board
~MODULE_RE: J1204.3; also elsewhere on the board
~SPI_FLASH_Config: R1203.2, R1204.1; also elsewhere on the board
~Telemetry_Config: R1201.2, R1202.1; also elsewhere on the board

Notes on the sheet:
Ambient Temp Sense

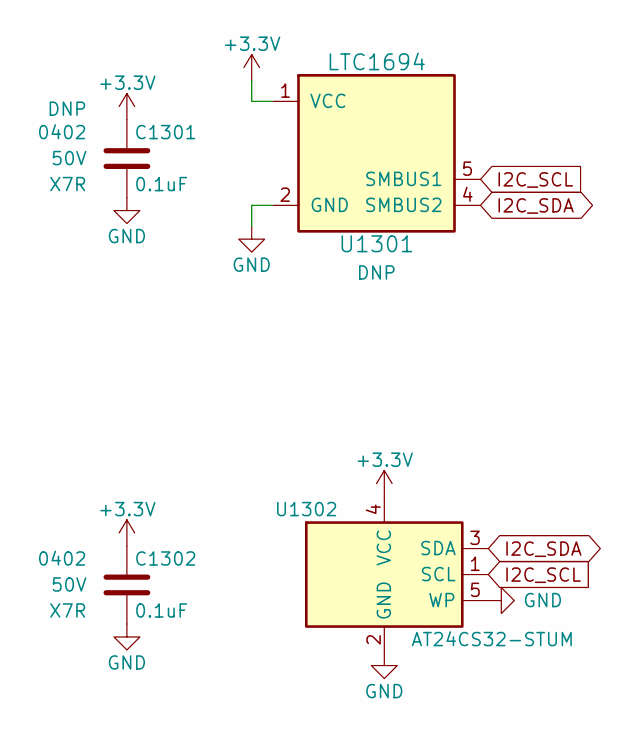
[picture p48: schematic I2C_Boost.sch, LED Panel Controller]

Parts:
C1301, C1302: 0.1uF; C_0402; Voltage 50V; Digi-Key PN 490-10698-1-ND
U1301: LTC1694; SOT-23-5; Digi-Key PN LTC1694CS5#TRPBFCT-ND
U1302: AT24CS32-STUM; SOT-23-5; Digi-Key PN AT24CS32-STUM-T

Connections:
I2C_SCL: U1301.5 (SMBUS1), U1302.1 (SCL); also elsewhere on the board
I2C_SDA: U1301.4 (SMBUS2), U1302.3 (SDA); also elsewhere on the board

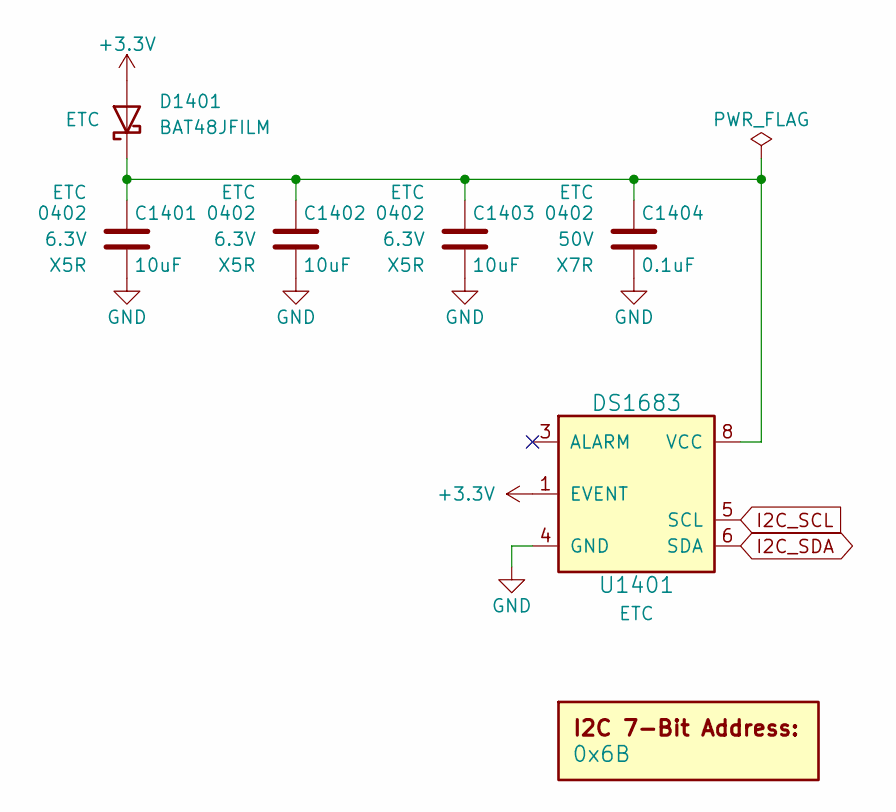
[picture p49: schematic Platform_ETC.sch, LED Panel Controller]

Parts:
C1401, C1402, C1403: 10uF; C_0402; Voltage 6.3V; Digi-Key PN 1276-1451-1-ND
C1404: 0.1uF; C_0402; Voltage 50V; Digi-Key PN 490-10698-1-ND
D1401: BAT48JFILM; D_SOD-323; Digi-Key PN 497-5711-1-ND
DOC1401: 0x6B
U1401: DS1683; SOIC-8_3.9x4.9mm_Pitch1.27mm; Digi-Key PN DS1683S+-ND

Connections:
I2C_SCL: U1401.5 (SCL); also elsewhere on the board
I2C_SDA: U1401.6 (SDA); also elsewhere on the board
unnamed: C1401.1, C1402.1, C1403.1, C1404.1, D1401.1 (K), U1401.8 (VCC)

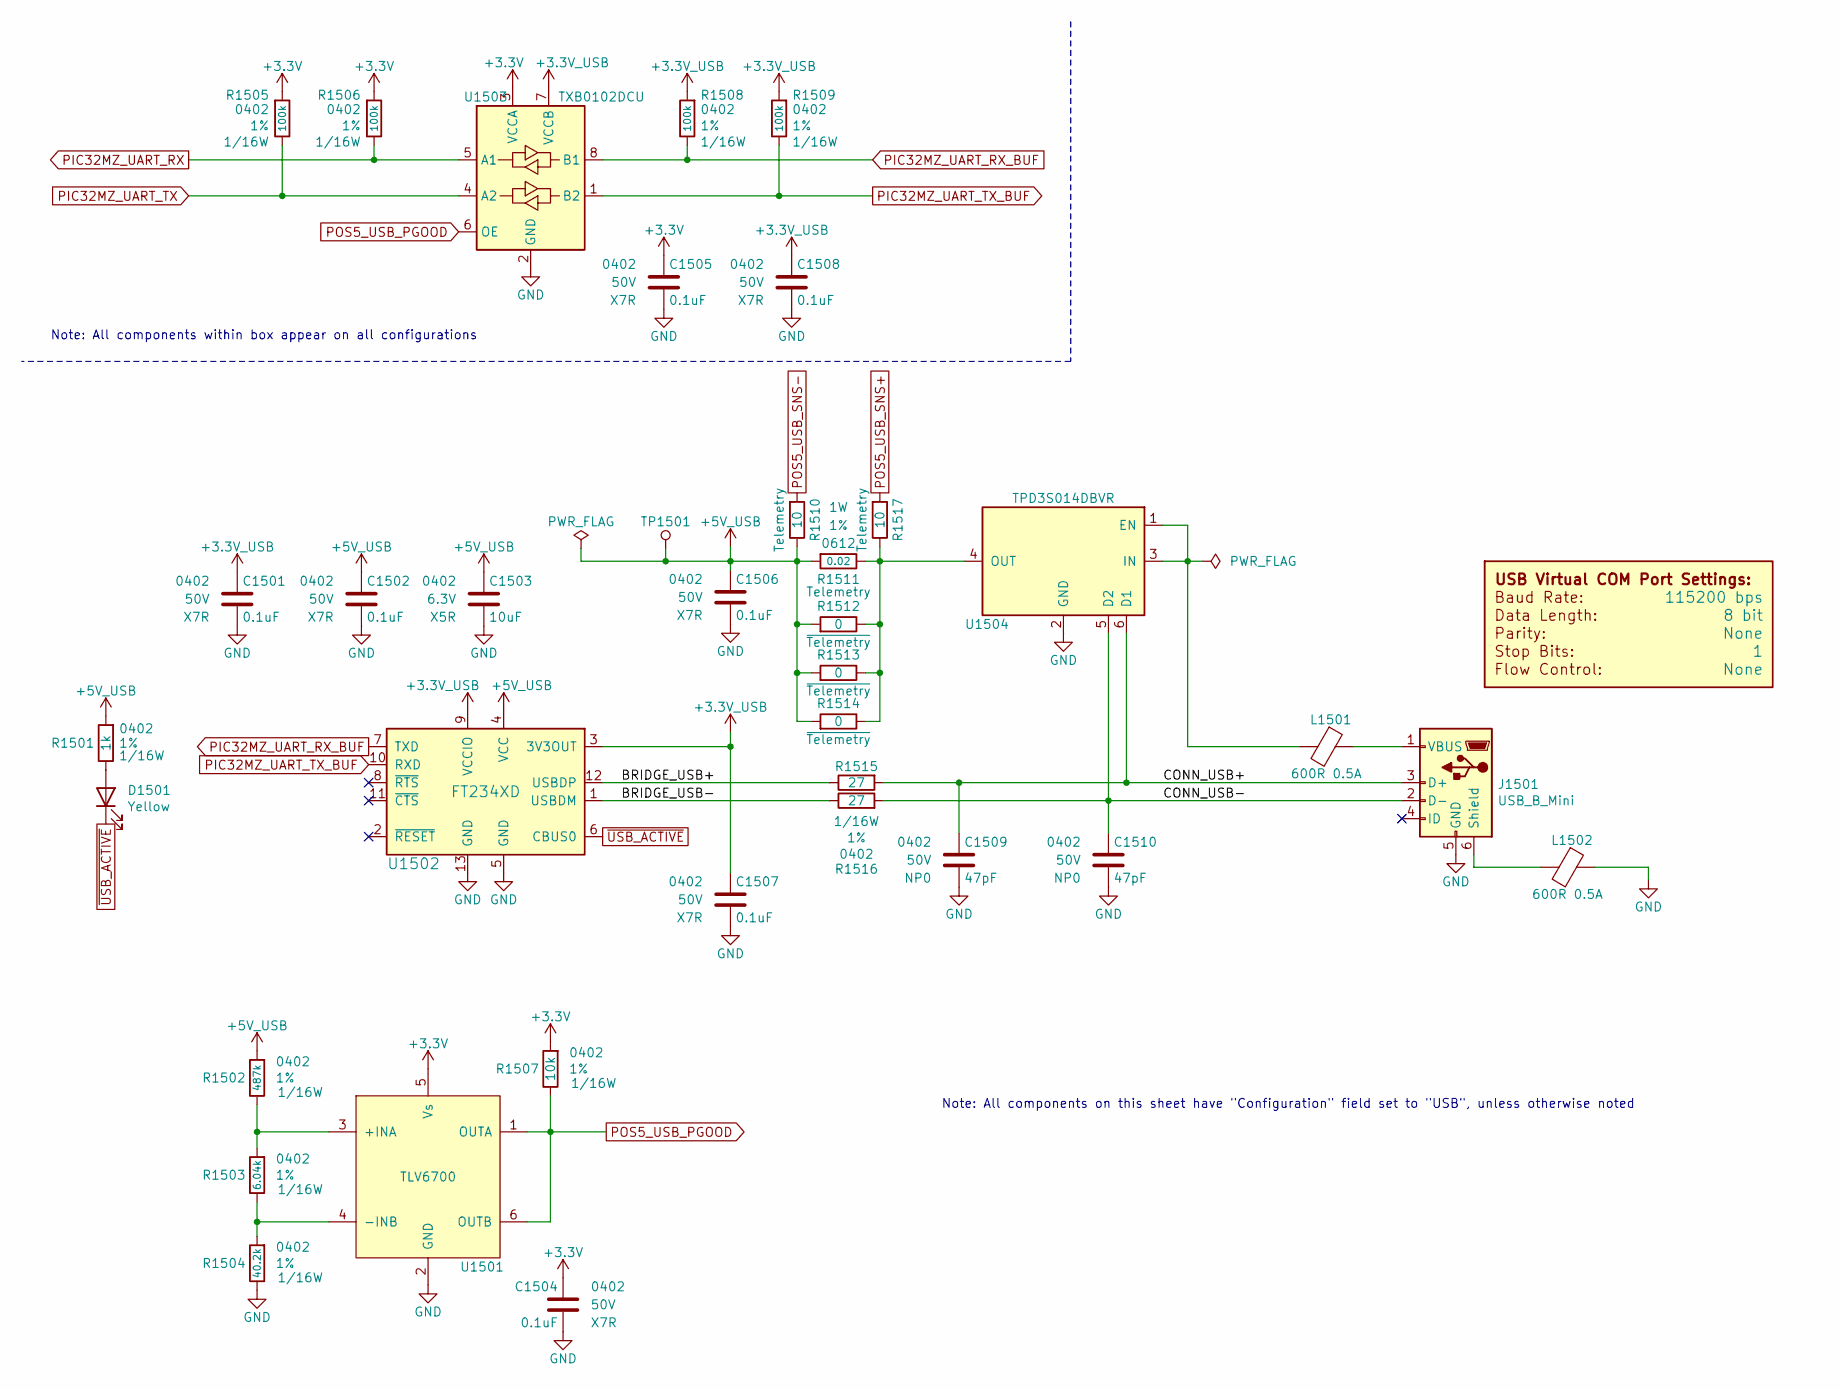
[picture p50: schematic USB_UART_Bridge.sch, LED Panel Controller]

Parts:
C1203: 10uF; C_0402; Voltage 6.3V; Digi-Key PN 1276-1451-1-ND
C1204, C1501, C1502, C1505, C1506, C1507, C1508: 0.1uF; C_0402; Voltage 50V; Digi-Key PN 490-10698-1-ND
C1509, C1510: 47pF; C_0402; Voltage 50V; Digi-Key PN 311-3783-1-ND
D1501: Yellow; LED_0402; Digi-Key PN 1497-1198-1-ND
DOC1501: COM_Port_Settings
J1501: USB_B_Mini; USB_Mini-B; Digi-Key PN 732-2109-1-ND
L1501, L1502: 600R 0.5A; L_0402; Digi-Key PN 490-5441-1-ND
R1206, R1207, R1216, R1217: 100k; R_0402; Tolerance 1%; Digi-Key PN RMCF0402FT100KCT-ND
R1208, R1215: 10; R_0402; Tolerance 1%; Digi-Key PN RMCF0402FT10R0CT-ND
R1209: 0.02; R_0612; Tolerance 1%; Digi-Key PN P16010CT-ND
R1210, R1211, R1212: 0; R_0402; Tolerance 1%; Digi-Key PN RMCF0402ZT0R00CT-N
R1501: 1k; R_0402; Tolerance 1%; Digi-Key PN RMCF0402FT1K00CT-ND
R1502: 487k; R_0402; Tolerance 1%; Digi-Key PN RMCF0402FT487KCT-ND
R1503: 6.04k; R_0402; Tolerance 1%; Digi-Key PN RMCF0402FT6K04CT-ND
R1504: 40.2k; R_0402; Tolerance 1%; Digi-Key PN RMCF0402FT40K2CT-ND
R1507: 10k; R_0402; Tolerance 1%; Digi-Key PN RMCF0402FT10K0CT-ND
R1515, R1516: 27; R_0402; Tolerance 1%; Digi-Key PN RMCF0402FT27R0CT-ND
TP1201: TP; Test_Point
U1501: TLV6700; SOT-23-6; Digi-Key PN 296-51696-1-ND
U1502: FT234XD; DFN-12-1EP_3x3mm_Pitch0.45mm; Digi-Key PN 768-1178-1-ND
U1503: TXB0102DCU; VSSOP-8_2.4x2.1mm_P0.5mm; Digi-Key PN 296-22862-1-ND
U1504: TPD3S014DBVR; SOT-23-6; Digi-Key PN 296-38835-1-ND

Connections:
+3.3V_USB: C1501.1, C1507.1, C1508.1, U1502.3 (3V3OUT), U1502.9 (VCCIO), U1503.7 (VCCB); also elsewhere on the board
/USB UART Bridge/BRIDGE_USB+: R1515.2, U1502.12 (USBDP)
/USB UART Bridge/BRIDGE_USB-: R1516.2, U1502.1 (USBDM)
/USB UART Bridge/CONN_USB+: C1509.1, J1501.3 (D+), R1515.1, U1504.6 (D1)
/USB UART Bridge/CONN_USB-: C1510.1, J1501.2 (D-), R1516.1, U1504.5 (D2)
unnamed: D1501.2 (A), R1501.2
unnamed: J1501.1 (VBUS), L1501.1
unnamed: J1501.6 (Shield), L1502.2
unnamed: L1501.2, U1504.1 (EN), U1504.3 (IN)
unnamed: R1502.2, R1503.1, U1501.3 (+INA)
unnamed: R1503.2, R1504.1, U1501.4 (-INB)
PIC32MZ_UART_RX_BUF: U1502.7 (TXD), U1503.8 (B1); also elsewhere on the board
PIC32MZ_UART_TX_BUF: U1502.10 (RXD), U1503.1 (B2); also elsewhere on the board
POS5_USB_PGOOD: R1507.2, U1501.1 (OUTA), U1501.6 (OUTB), U1503.6 (OE); also elsewhere on the board
~USB_ACTIVE: D1501.1 (K), U1502.6 (CBUS0)

Notes on the sheet:
Note: All components on this sheet have "Configuration" field set to "USB", unless otherwise noted
Note: All components within box appear on all configurations

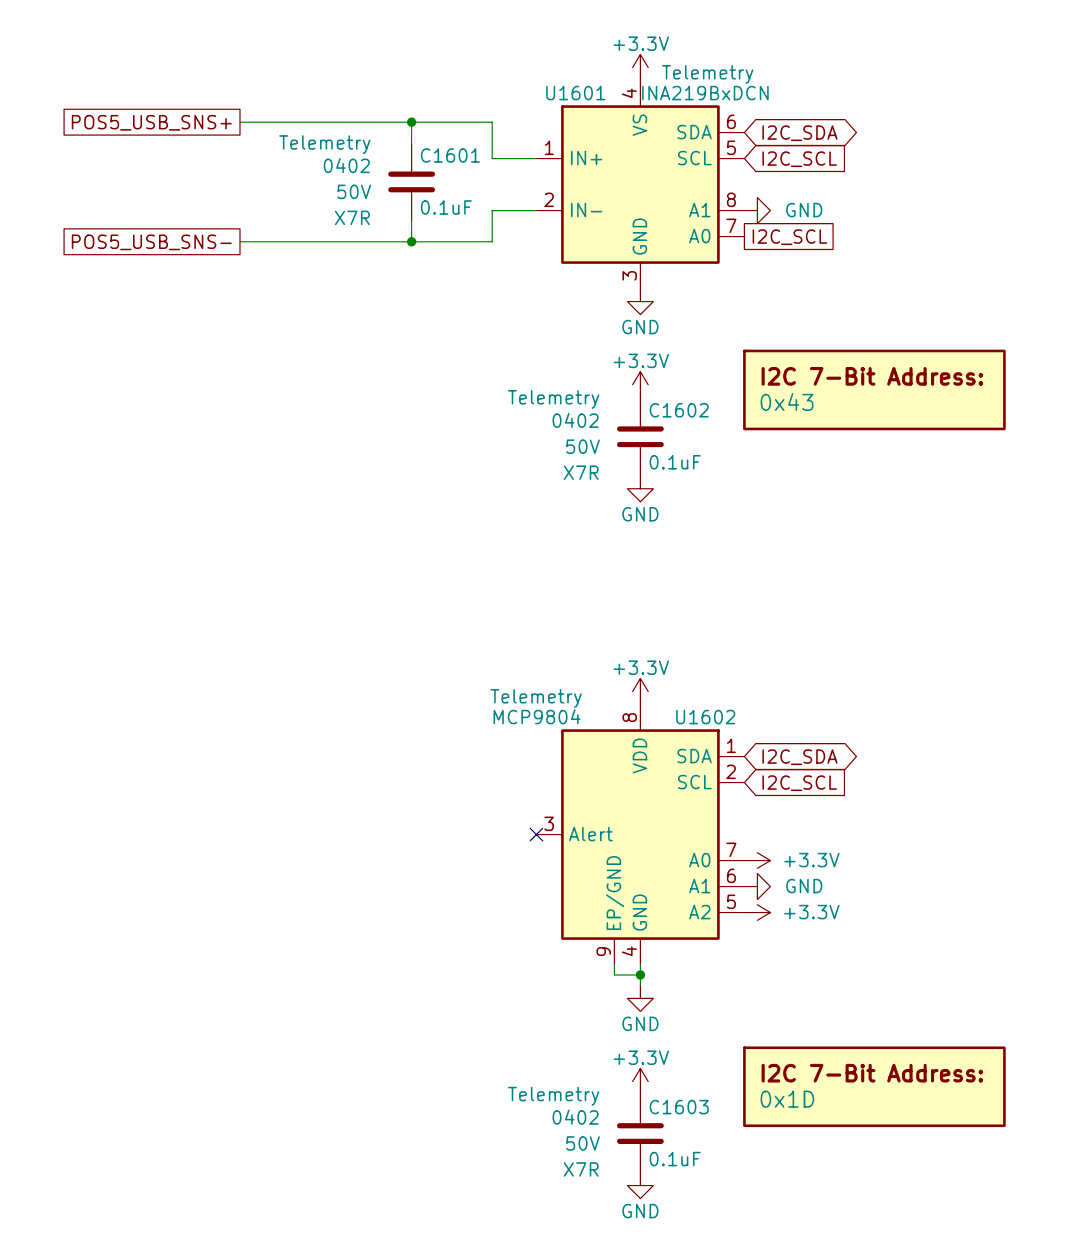
[picture p51: schematic USB_Telemetry.sch, LED Panel Controller]

Parts:
C1601, C1602, C1603: 0.1uF; C_0402; Voltage 50V; Digi-Key PN 490-10698-1-ND
DOC1601: 0x43
DOC1602: 0x1D
U1601: INA219BxDCN; SOT-23-8; Digi-Key PN 296-46420-1-ND
U1602: MCP9804; DFN-8-1EP_3x2mm_P0.5mm_EP1.3x1.5mm; Digi-Key PN MCP9804T-E/MCCT-ND

Connections:
I2C_SCL: U1601.5 (SCL), U1601.7 (A0), U1602.2 (SCL); also elsewhere on the board
I2C_SDA: U1601.6 (SDA), U1602.1 (SDA); also elsewhere on the board
POS5_USB_SNS+: C1601.1, U1601.1 (IN+); also elsewhere on the board
POS5_USB_SNS-: C1601.2, U1601.2 (IN-); also elsewhere on the board

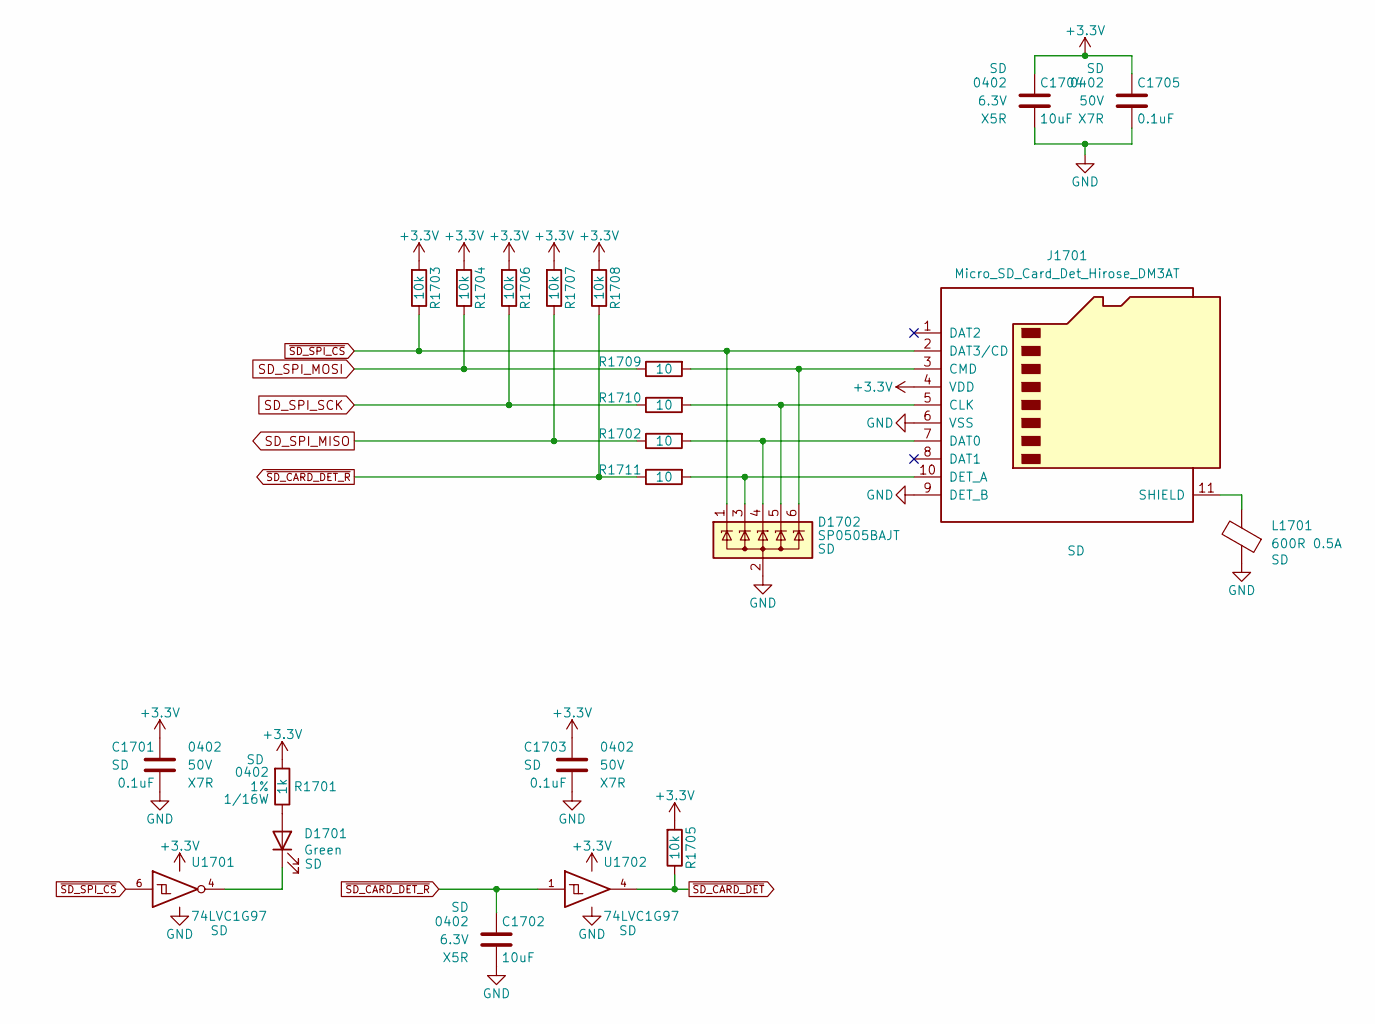
[picture p52: schematic SD_Card_Slot.sch, LED Panel Controller]

Parts:
C1701, C1703, C1705: 0.1uF; C_0402; Voltage 50V; Digi-Key PN 490-10698-1-ND
C1702, C1704: 10uF; C_0402; Voltage 6.3V; Digi-Key PN 1276-1451-1-ND
D1701: Green; LED_0402; Digi-Key PN 1497-1219-1-ND
D1702: SP0505BAJT; SOT-363_SC-70-6; Digi-Key PN F3160CT-ND
J1701: Micro_SD_Card_Det_Hirose_DM3AT; Hirose_DM3AT-SF-PEJM5; Digi-Key PN HR1964CT-ND
L1701: 600R 0.5A; L_0402; Digi-Key PN 490-5441-1-ND
R1701: 1k; R_0402; Tolerance 1%; Digi-Key PN RMCF0402FT1K00CT-ND
R1702, R1709, R1710, R1711: 10; R_0402; Tolerance 1%; Digi-Key PN RMCF0402FT10R0CT-ND
R1703, R1704, R1705, R1706, R1707, R1708: 10k; R_0402; Tolerance 1%; Digi-Key PN RMCF0402FT10K0CT-ND
U1701, U1702: 74LVC1G97; SOT-363_SC-70-6; Digi-Key PN 1727-1772-1-ND

Connections:
unnamed: D1701.1 (K), U1701.4
unnamed: D1701.2 (A), R1701.2
unnamed: D1702.3 (K), J1701.10 (DET_A), R1711.1
unnamed: D1702.4 (K), J1701.7 (DAT0), R1702.1
unnamed: D1702.5 (K), J1701.5 (CLK), R1710.1
unnamed: D1702.6 (K), J1701.3 (CMD), R1709.1
unnamed: J1701.11 (SHIELD), L1701.2
SD_SPI_MISO: R1702.2, R1707.2; also elsewhere on the board
SD_SPI_MOSI: R1704.2, R1709.2; also elsewhere on the board
SD_SPI_SCK: R1706.2, R1710.2; also elsewhere on the board
~SD_CARD_DET: R1705.2, U1702.4; also elsewhere on the board
~SD_CARD_DET_R: C1702.1, R1708.2, R1711.2, U1702.1
~SD_SPI_CS: D1702.1 (K), J1701.2 (DAT3/CD), R1703.2, U1701.6; also elsewhere on the board

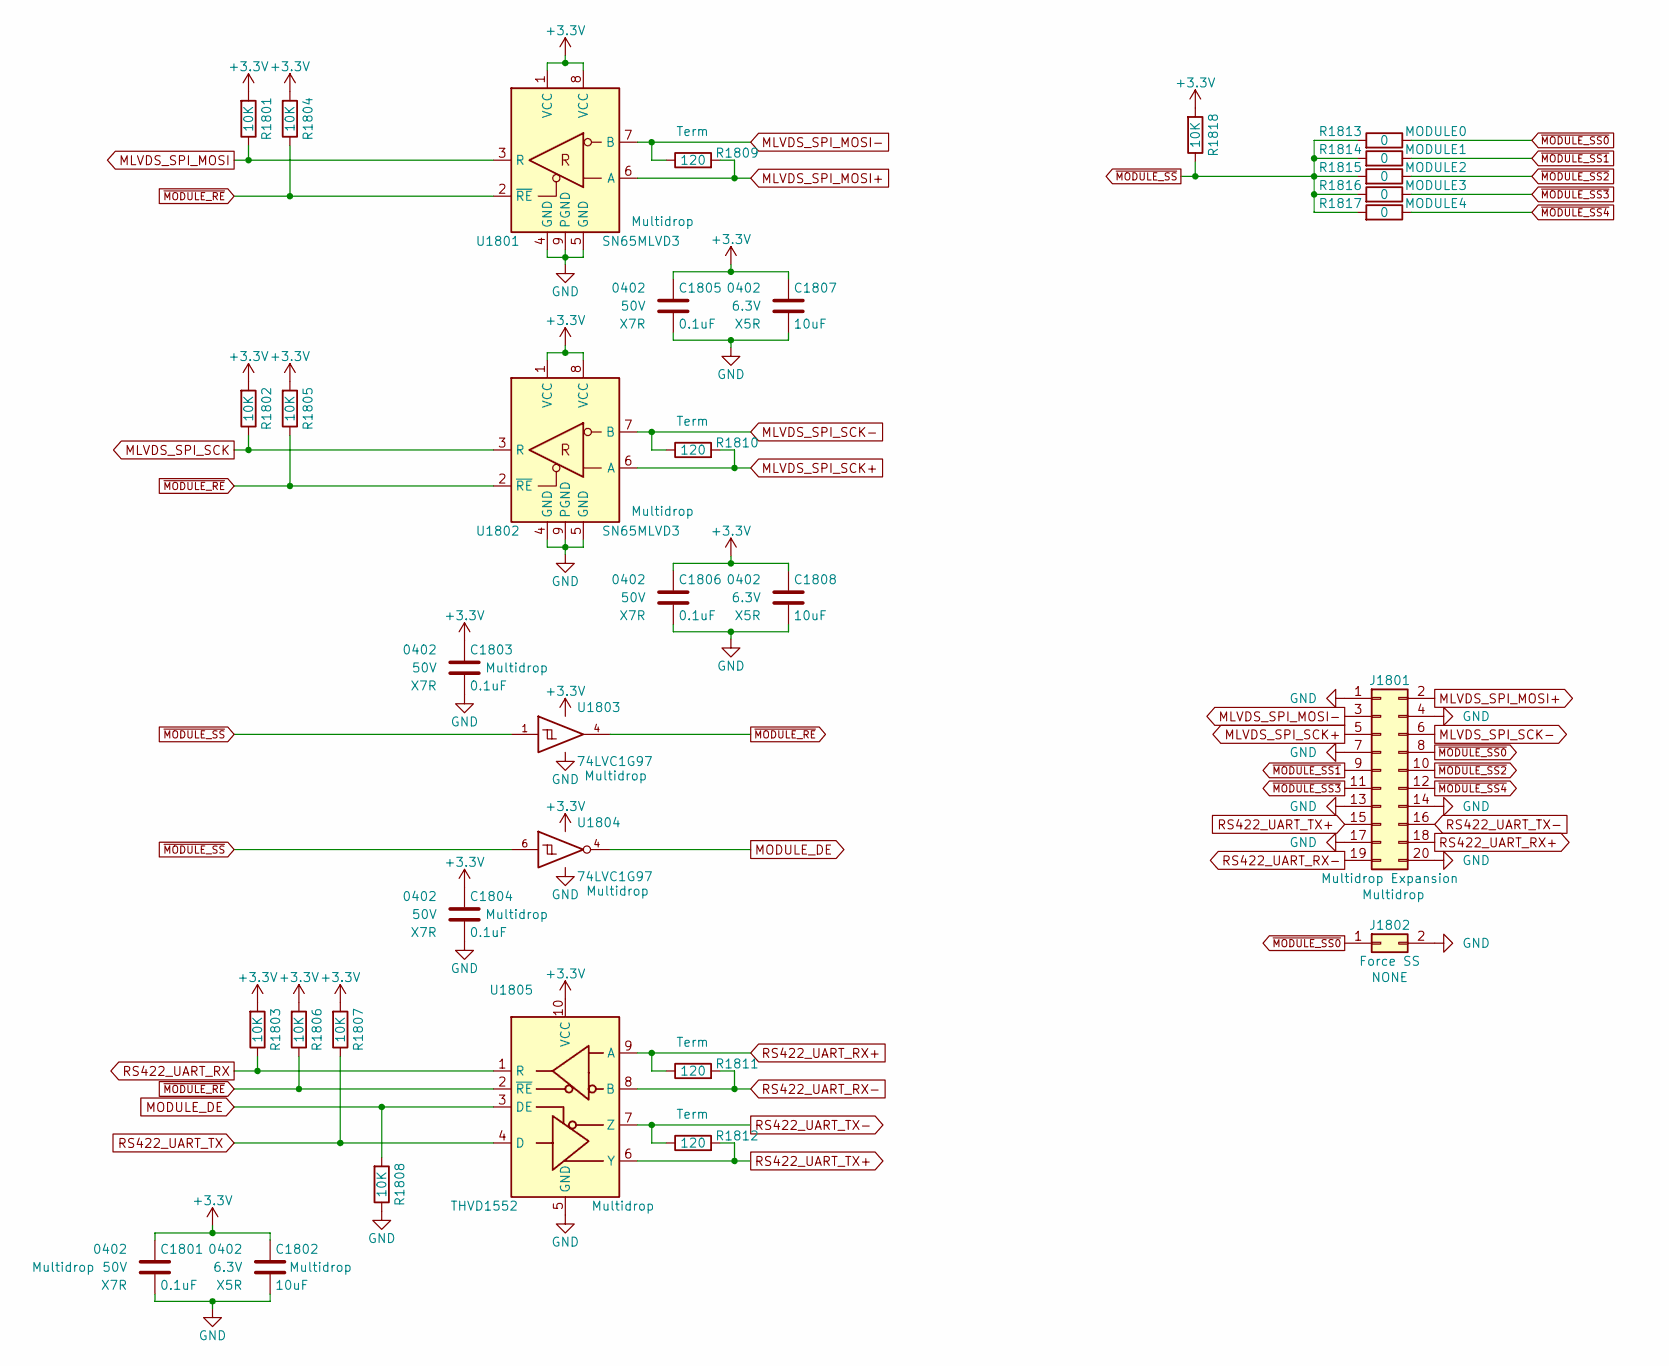
[picture p53: schematic MLVDS_Port.sch, LED Panel Controller]

Parts:
C1801, C1803, C1804, C1805, C1806: 0.1uF; C_0402; Voltage 50V; Digi-Key PN 490-10698-1-ND
C1802, C1807, C1808: 10uF; C_0402; Voltage 6.3V; Digi-Key PN 1276-1451-1-ND
J1801: Multidrop Expansion; IDC-Header_2x10_P2.54mm_Vertical; Digi-Key PN 732-2096-ND
J1802: Force SS; PinHeader_1x02_P2.54mm_Vertical
R1801, R1802, R1803, R1804, R1805, R1806, R1807, R1808, R1818: 10K; R_0402; Tolerance 1%; Digi-Key PN RMCF0402FT10K0CT-ND
R1809, R1810, R1811, R1812: 120; R_0402; Tolerance 1%; Digi-Key PN RMCF0402FT120RCT-ND
R1813, R1814, R1815, R1816, R1817: 0; R_0402; Tolerance 1%; Digi-Key PN RMCF0402ZT0R00CT-N
U1801, U1802: SN65MLVD3; DFN-8-1EP_3x3mm_Pitch0.65mm; Digi-Key PN 296-21314-1-ND
U1803, U1804: 74LVC1G97; SOT-363_SC-70-6; Digi-Key PN 1727-1772-1-ND
U1805: THVD1552; VSSOP-10_3x3mm_P0.5mm; Digi-Key PN 296-51654-1-ND

Connections:
MLVDS_SPI_MOSI: R1801.2, U1801.3 (R); also elsewhere on the board
MLVDS_SPI_MOSI+: J1801.2, R1809.1, U1801.6 (A)
MLVDS_SPI_MOSI-: J1801.3, R1809.2, U1801.7 (B)
MLVDS_SPI_SCK: R1802.2, U1802.3 (R); also elsewhere on the board
MLVDS_SPI_SCK+: J1801.5, R1810.1, U1802.6 (A)
MLVDS_SPI_SCK-: J1801.6, R1810.2, U1802.7 (B)
MODULE_DE: R1808.1, U1804.4, U1805.3 (DE)
RS422_UART_RX: R1803.2, U1805.1 (R); also elsewhere on the board
RS422_UART_RX+: J1801.18, R1811.2, U1805.9 (A)
RS422_UART_RX-: J1801.19, R1811.1, U1805.8 (B)
RS422_UART_TX: R1807.2, U1805.4 (D); also elsewhere on the board
RS422_UART_TX+: J1801.15, R1812.1, U1805.6 (Y)
RS422_UART_TX-: J1801.16, R1812.2, U1805.7 (Z)
~MODULE_RE: R1804.2, R1805.2, R1806.2, U1801.2 (~RE), U1802.2 (~RE), U1803.4, U1805.2 (~RE); also elsewhere on the board
~MODULE_SS: R1813.1, R1814.1, R1815.1, R1816.1, R1817.1, R1818.2, U1803.1, U1804.6
~MODULE_SS0: J1801.8, J1802.1, R1813.2
~MODULE_SS1: J1801.9, R1814.2
~MODULE_SS2: J1801.10, R1815.2
~MODULE_SS3: J1801.11, R1816.2
~MODULE_SS4: J1801.12, R1817.2
