drewsum/LED_Panel_Controller/hdw/LED_Panel_Controller/LED_Panel_Controller.kicad_pcb

## KiCad design hdw/LED_Panel_Controller/LED_Panel_Controller.kicad_pcb (continued)

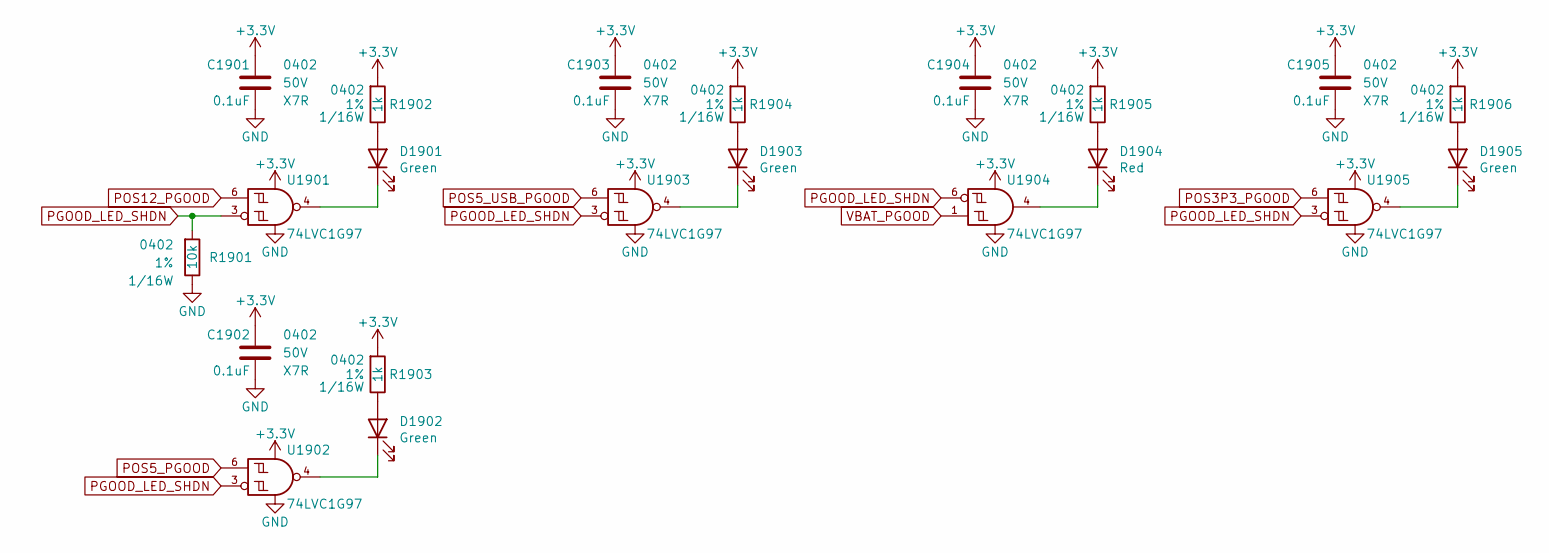
[picture p54: schematic PGOOD_LEDs.sch, LED Panel Controller]

Parts:
C1901, C1902, C1903, C1904, C1905: 0.1uF; C_0402; Voltage 50V; Digi-Key PN 490-10698-1-ND
D1901, D1902, D1903, D1905: Green; LED_0402; Digi-Key PN 1497-1219-1-ND
D1904: Red; LED_0402; Digi-Key PN 1497-1174-1-ND
R1901: 10k; R_0402; Tolerance 1%; Digi-Key PN RMCF0402FT10K0CT-ND
R1902, R1903, R1904, R1905, R1906: 1k; R_0402; Tolerance 1%; Digi-Key PN RMCF0402FT1K00CT-ND
U1901, U1902, U1903, U1904, U1905: 74LVC1G97; SOT-363_SC-70-6; Digi-Key PN 1727-1772-1-ND

Connections:
unnamed: D1901.1 (K), U1901.4
unnamed: D1901.2 (A), R1902.2
unnamed: D1902.1 (K), U1902.4
unnamed: D1902.2 (A), R1903.2
unnamed: D1903.1 (K), U1903.4
unnamed: D1903.2 (A), R1904.2
unnamed: D1904.1 (K), U1904.4
unnamed: D1904.2 (A), R1905.2
unnamed: D1905.1 (K), U1905.4
unnamed: D1905.2 (A), R1906.2
PGOOD_LED_SHDN: R1901.1, U1901.3, U1902.3, U1903.3, U1904.6, U1905.3; also elsewhere on the board
POS3P3_PGOOD: U1905.6; also elsewhere on the board
POS5_PGOOD: U1902.6; also elsewhere on the board
POS5_USB_PGOOD: U1903.6; also elsewhere on the board
POS12_PGOOD: U1901.6; also elsewhere on the board
VBAT_PGOOD: U1904.1; also elsewhere on the board

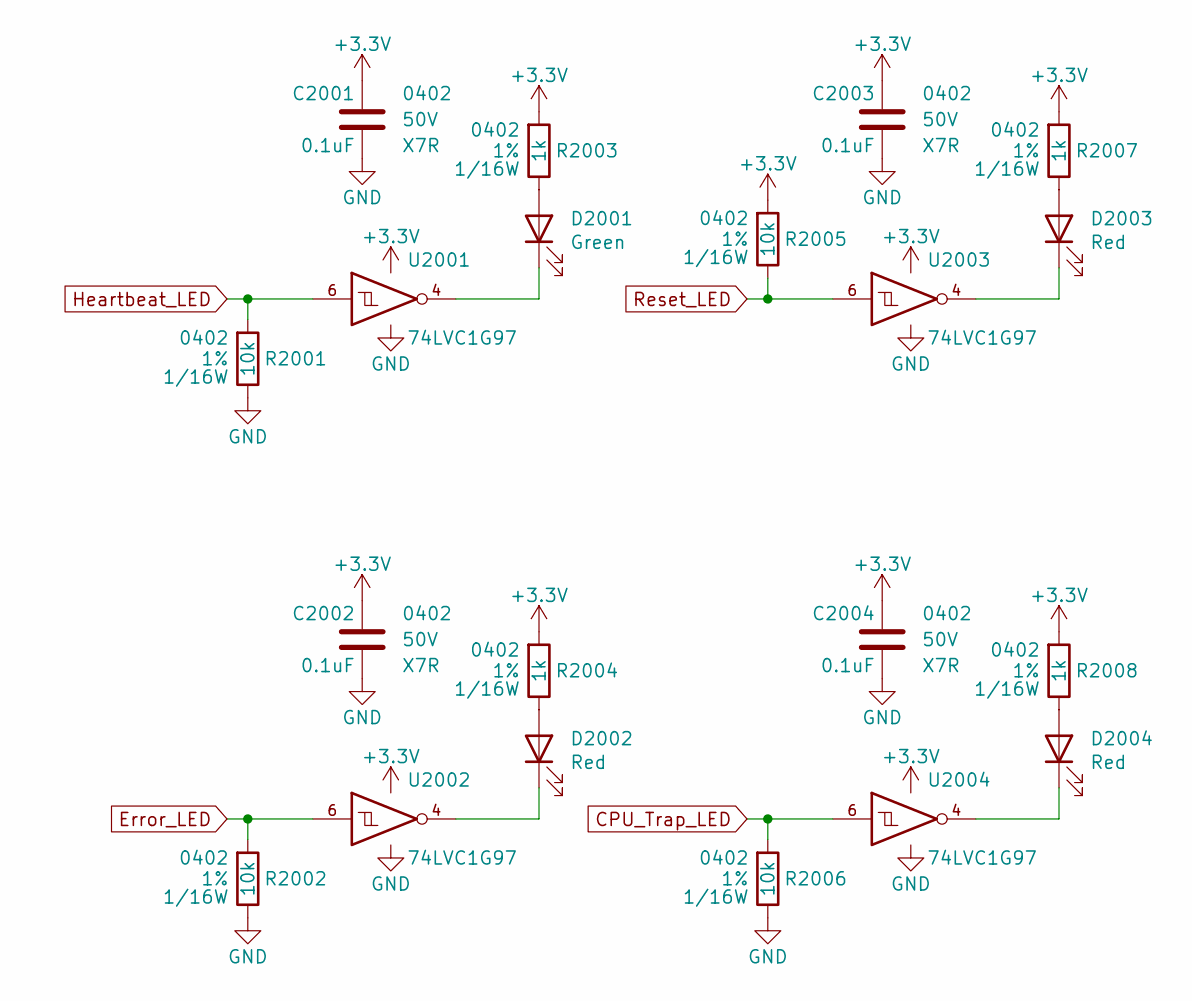
[picture p55: schematic Status_LEDs.sch, LED Panel Controller]

Parts:
C2001, C2002, C2003, C2004: 0.1uF; C_0402; Voltage 50V; Digi-Key PN 490-10698-1-ND
D2001: Green; LED_0402; Digi-Key PN 1497-1219-1-ND
D2002, D2003, D2004: Red; LED_0402; Digi-Key PN 1497-1174-1-ND
R2001, R2002, R2005, R2006: 10k; R_0402; Tolerance 1%; Digi-Key PN RMCF0402FT10K0CT-ND
R2003, R2004, R2007, R2008: 1k; R_0402; Tolerance 1%; Digi-Key PN RMCF0402FT1K00CT-ND
U2001, U2002, U2003, U2004: 74LVC1G97; SOT-363_SC-70-6; Digi-Key PN 1727-1772-1-ND

Connections:
CPU_Trap_LED: R2006.1, U2004.6; also elsewhere on the board
Error_LED: R2002.1, U2002.6; also elsewhere on the board
Heartbeat_LED: R2001.1, U2001.6; also elsewhere on the board
unnamed: D2001.1 (K), U2001.4
unnamed: D2001.2 (A), R2003.2
unnamed: D2002.1 (K), U2002.4
unnamed: D2002.2 (A), R2004.2
unnamed: D2003.1 (K), U2003.4
unnamed: D2003.2 (A), R2007.2
unnamed: D2004.1 (K), U2004.4
unnamed: D2004.2 (A), R2008.2
Reset_LED: R2005.2, U2003.6; also elsewhere on the board

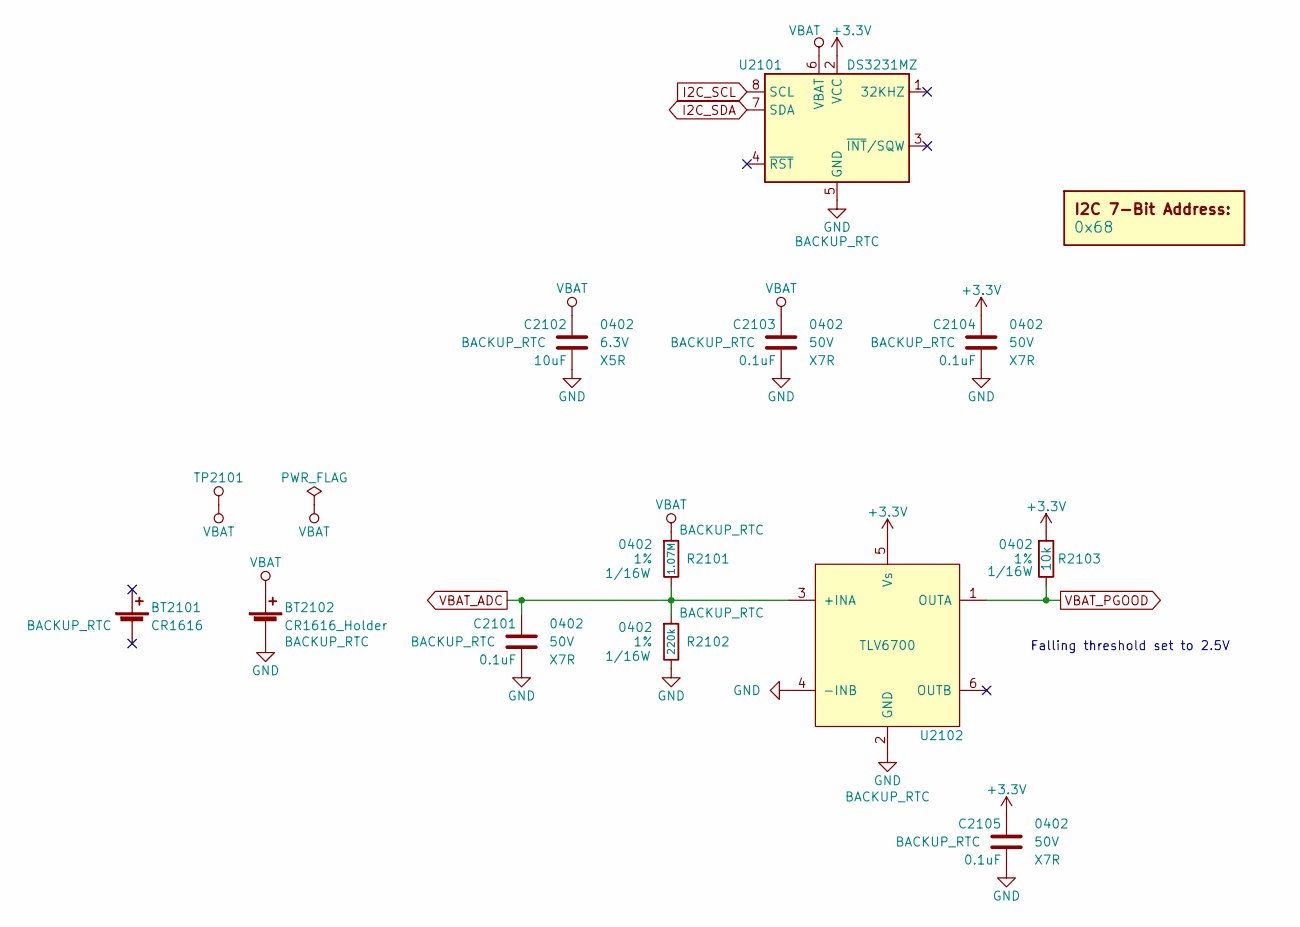
[picture p56: schematic Backup_RTC.sch, LED Panel Controller]

Parts:
BT2101: CR1616; Digi-Key PN P034-ND
BT2102: CR1616_Holder; BAT_BU1632SM-JJ-GTR; Digi-Key PN BU1632SM-JJ-GCT-ND
C2101, C2103, C2104, C2105: 0.1uF; C_0402; Voltage 50V; Digi-Key PN 490-10698-1-ND
C2102: 10uF; C_0402; Voltage 6.3V; Digi-Key PN 1276-1451-1-ND
DOC2101: 0x68
R2101: 1.07M; R_0402; Tolerance 1%; Digi-Key PN RMCF0402FT1M07CT-ND
R2102: 220k; R_0402; Tolerance 1%; Digi-Key PN RMCF0402FT220KCT-ND
R2103: 10k; R_0402; Tolerance 1%; Digi-Key PN RMCF0402FT10K0CT-ND
TP2101: TP; Test_Point
U2101: DS3231MZ; SOIC-8_3.9x4.9mm_P1.27mm; Digi-Key PN DS3231MZ+-ND
U2102: TLV6700; SOT-23-6; Digi-Key PN 296-51696-1-ND

Connections:
I2C_SCL: U2101.8 (SCL); also elsewhere on the board
I2C_SDA: U2101.7 (SDA); also elsewhere on the board
VBAT: BT2102.1 (+), C2102.1, C2103.1, R2101.1, TP2101.1, U2101.6 (VBAT)
VBAT_ADC: C2101.1, R2101.2, R2102.1, U2102.3 (+INA); also elsewhere on the board
VBAT_PGOOD: R2103.2, U2102.1 (OUTA); also elsewhere on the board

Notes on the sheet:
Falling threshold set to 2.5V

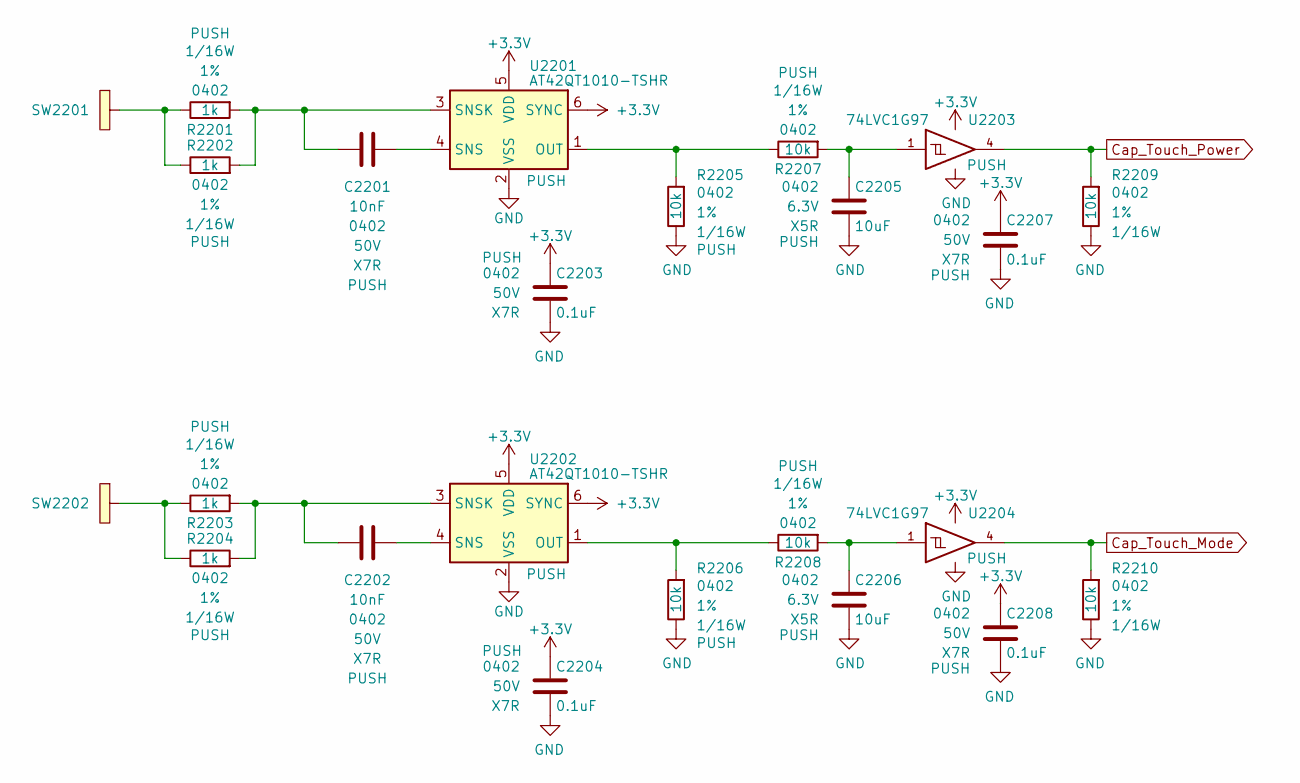
[picture p57: schematic Pushbuttons.sch, LED Panel Controller]

Parts:
C2201, C2202: 10nF; C_0402; Voltage 50V; Digi-Key PN 399-3066-1-ND
C2203, C2204, C2207, C2208: 0.1uF; C_0402; Voltage 50V; Digi-Key PN 490-10698-1-ND
C2205, C2206: 10uF; C_0402; Voltage 6.3V; Digi-Key PN 1276-1451-1-ND
R2201, R2202, R2203, R2204: 1k; R_0402; Tolerance 1%; Digi-Key PN RMCF0402FT1K00CT-ND
R2205, R2206, R2207, R2208, R2209, R2210: 10k; R_0402; Tolerance 1%; Digi-Key PN RMCF0402FT10K0CT-ND
SW2201, SW2202: Cap_Touch; Capacitive_Touch_Pad
U2201, U2202: AT42QT1010-TSHR; SOT-23-6; Digi-Key PN AT42QT1010-TSHRCT-ND
U2203, U2204: 74LVC1G97; SOT-363_SC-70-6; Digi-Key PN 1727-1772-1-ND

Connections:
Cap_Touch_Mode: R2210.1, U2204.4; also elsewhere on the board
Cap_Touch_Power: R2209.1, U2203.4; also elsewhere on the board
unnamed: C2201.1, U2201.4 (SNS)
unnamed: C2201.2, R2201.1, R2202.1, U2201.3 (SNSK)
unnamed: C2202.1, U2202.4 (SNS)
unnamed: C2202.2, R2203.1, R2204.1, U2202.3 (SNSK)
unnamed: C2205.1, R2207.1, U2203.1
unnamed: C2206.1, R2208.1, U2204.1
unnamed: R2201.2, R2202.2, SW2201.1
unnamed: R2203.2, R2204.2, SW2202.1
unnamed: R2205.1, R2207.2, U2201.1 (OUT)
unnamed: R2206.1, R2208.2, U2202.1 (OUT)

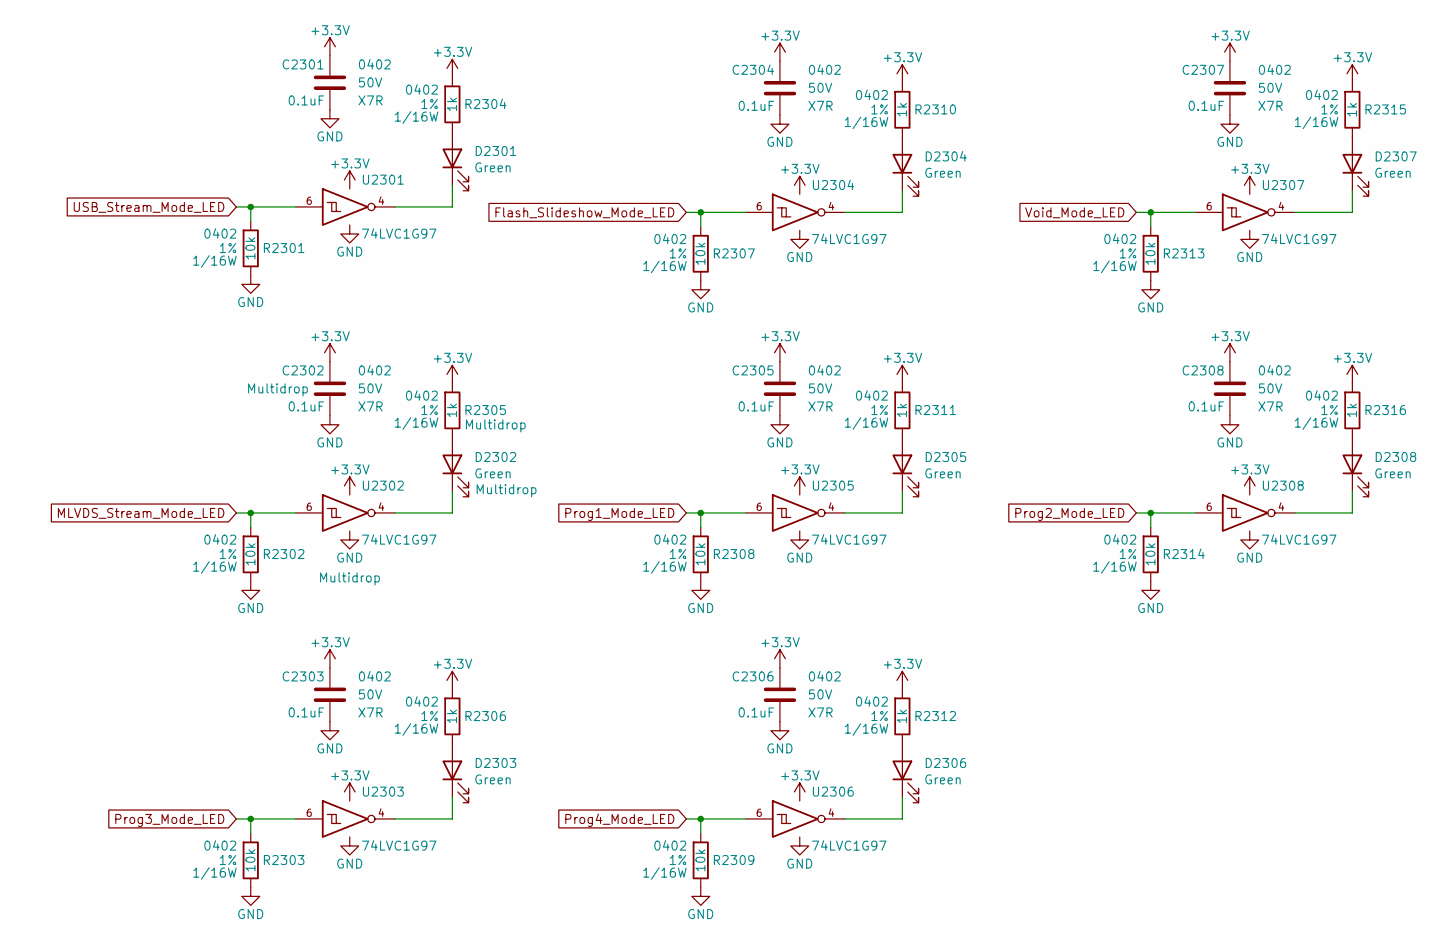
[picture p58: schematic Mode_LEDs.sch, LED Panel Controller]

Parts:
C2301, C2302, C2303, C2304, C2305, C2306, C2307, C2308: 0.1uF; C_0402; Voltage 50V; Digi-Key PN 490-10698-1-ND
D2301, D2302, D2303, D2304, D2305, D2306, D2307, D2308: Green; LED_0402; Digi-Key PN 1497-1219-1-ND
R2301, R2302, R2303, R2307, R2308, R2309, R2313, R2314: 10k; R_0402; Tolerance 1%; Digi-Key PN RMCF0402FT10K0CT-ND
R2304, R2305, R2306, R2310, R2311, R2312, R2315, R2316: 1k; R_0402; Tolerance 1%; Digi-Key PN RMCF0402FT1K00CT-ND
U2301, U2302, U2303, U2304, U2305, U2306, U2307, U2308: 74LVC1G97; SOT-363_SC-70-6; Digi-Key PN 1727-1772-1-ND

Connections:
Flash_Slideshow_Mode_LED: R2307.1, U2304.6; also elsewhere on the board
MLVDS_Stream_Mode_LED: R2302.1, U2302.6; also elsewhere on the board
unnamed: D2301.1 (K), U2301.4
unnamed: D2301.2 (A), R2304.2
unnamed: D2302.1 (K), U2302.4
unnamed: D2302.2 (A), R2305.2
unnamed: D2303.1 (K), U2303.4
unnamed: D2303.2 (A), R2306.2
unnamed: D2304.1 (K), U2304.4
unnamed: D2304.2 (A), R2310.2
unnamed: D2305.1 (K), U2305.4
unnamed: D2305.2 (A), R2311.2
unnamed: D2306.1 (K), U2306.4
unnamed: D2306.2 (A), R2312.2
unnamed: D2307.1 (K), U2307.4
unnamed: D2307.2 (A), R2315.2
unnamed: D2308.1 (K), U2308.4
unnamed: D2308.2 (A), R2316.2
Prog1_Mode_LED: R2308.1, U2305.6; also elsewhere on the board
Prog2_Mode_LED: R2314.1, U2308.6; also elsewhere on the board
Prog3_Mode_LED: R2303.1, U2303.6; also elsewhere on the board
Prog4_Mode_LED: R2309.1, U2306.6; also elsewhere on the board
USB_Stream_Mode_LED: R2301.1, U2301.6; also elsewhere on the board
Void_Mode_LED: R2313.1, U2307.6; also elsewhere on the board

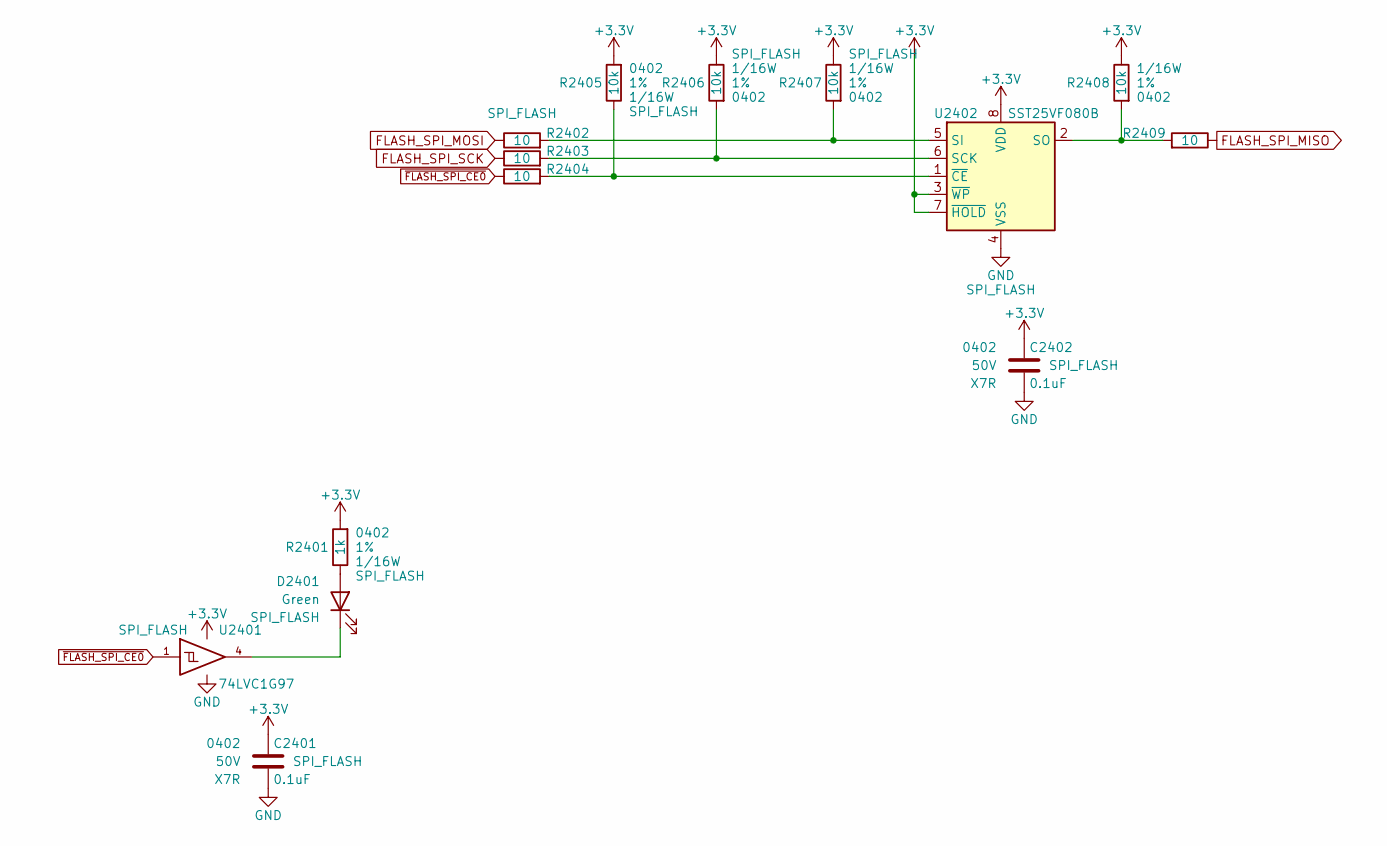
[picture p59: schematic SPI_Flash_0.sch, LED Panel Controller]

Parts:
C2401, C2402: 0.1uF; C_0402; Voltage 50V; Digi-Key PN 490-10698-1-ND
D2401: Green; LED_0402; Digi-Key PN 1497-1219-1-ND
R2401: 1k; R_0402; Tolerance 1%; Digi-Key PN RMCF0402FT1K00CT-ND
R2402, R2403, R2404, R2409: 10; R_0402; Tolerance 1%; Digi-Key PN RMCF0402FT10R0CT-ND
R2405, R2406, R2407, R2408: 10k; R_0402; Tolerance 1%; Digi-Key PN RMCF0402FT10K0CT-ND
U2401: 74LVC1G97; SOT-363_SC-70-6; Digi-Key PN 1727-1772-1-ND
U2402: SST25VF080B; SOIC-8_5.275x5.275mm_P1.27mm; Digi-Key PN SST25VF080B-50-4I-S2AE-T

Connections:
FLASH_SPI_MISO: R2409.2; also elsewhere on the board
FLASH_SPI_MOSI: R2402.2; also elsewhere on the board
FLASH_SPI_SCK: R2403.2; also elsewhere on the board
unnamed: D2401.1 (K), U2401.4
unnamed: D2401.2 (A), R2401.2
unnamed: R2402.1, R2407.1, U2402.5 (SI)
unnamed: R2403.1, R2406.1, U2402.6 (SCK)
unnamed: R2404.1, R2405.2, U2402.1 (~CE)
unnamed: R2408.1, R2409.1, U2402.2 (SO)
~FLASH_SPI_CE0: R2404.2, U2401.1; also elsewhere on the board

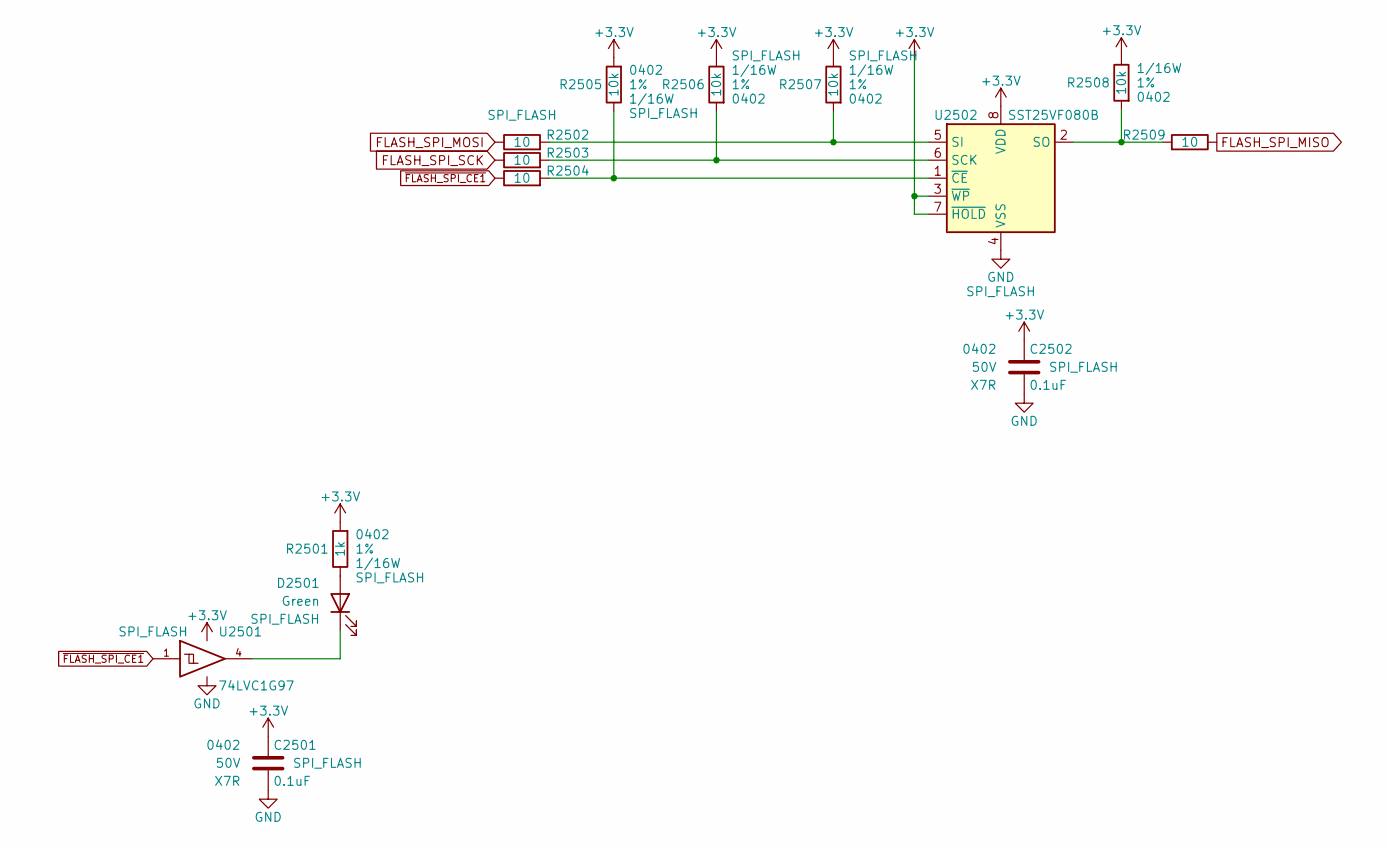
[picture p60: schematic SPI_Flash_1.sch, LED Panel Controller]

Parts:
C2501, C2502: 0.1uF; C_0402; Voltage 50V; Digi-Key PN 490-10698-1-ND
D2501: Green; LED_0402; Digi-Key PN 1497-1219-1-ND
R2501: 1k; R_0402; Tolerance 1%; Digi-Key PN RMCF0402FT1K00CT-ND
R2502, R2503, R2504, R2509: 10; R_0402; Tolerance 1%; Digi-Key PN RMCF0402FT10R0CT-ND
R2505, R2506, R2507, R2508: 10k; R_0402; Tolerance 1%; Digi-Key PN RMCF0402FT10K0CT-ND
U2501: 74LVC1G97; SOT-363_SC-70-6; Digi-Key PN 1727-1772-1-ND
U2502: SST25VF080B; SOIC-8_5.275x5.275mm_P1.27mm; Digi-Key PN SST25VF080B-50-4I-S2AE-T

Connections:
FLASH_SPI_MISO: R2509.2; also elsewhere on the board
FLASH_SPI_MOSI: R2502.2; also elsewhere on the board
FLASH_SPI_SCK: R2503.2; also elsewhere on the board
unnamed: D2501.1 (K), U2501.4
unnamed: D2501.2 (A), R2501.2
unnamed: R2502.1, R2507.1, U2502.5 (SI)
unnamed: R2503.1, R2506.1, U2502.6 (SCK)
unnamed: R2504.1, R2505.2, U2502.1 (~CE)
unnamed: R2508.1, R2509.1, U2502.2 (SO)
~FLASH_SPI_CE1: R2504.2, U2501.1; also elsewhere on the board

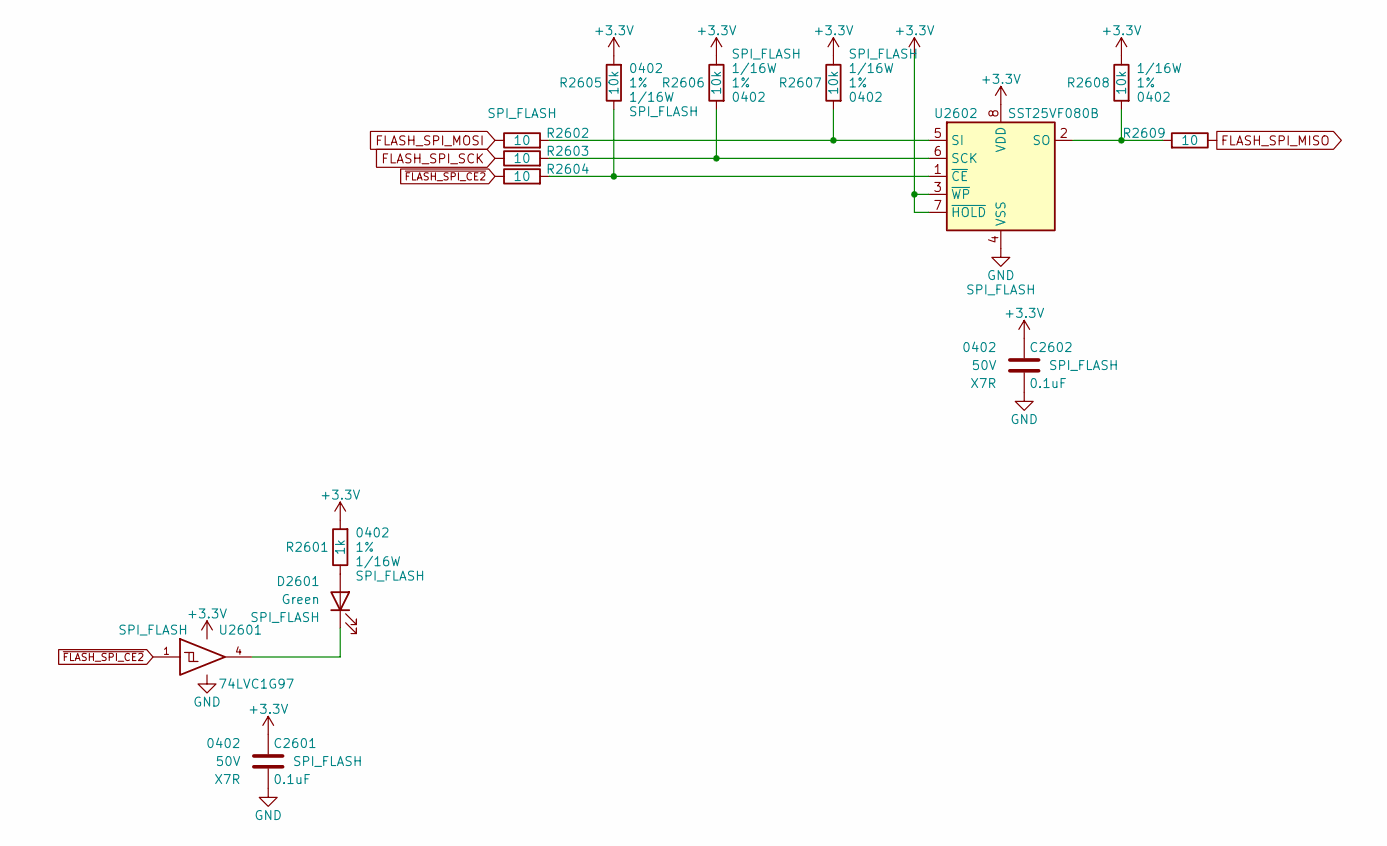
[picture p61: schematic SPI_Flash_2.sch, LED Panel Controller]

Parts:
C2601, C2602: 0.1uF; C_0402; Voltage 50V; Digi-Key PN 490-10698-1-ND
D2601: Green; LED_0402; Digi-Key PN 1497-1219-1-ND
R2601: 1k; R_0402; Tolerance 1%; Digi-Key PN RMCF0402FT1K00CT-ND
R2602, R2603, R2604, R2609: 10; R_0402; Tolerance 1%; Digi-Key PN RMCF0402FT10R0CT-ND
R2605, R2606, R2607, R2608: 10k; R_0402; Tolerance 1%; Digi-Key PN RMCF0402FT10K0CT-ND
U2601: 74LVC1G97; SOT-363_SC-70-6; Digi-Key PN 1727-1772-1-ND
U2602: SST25VF080B; SOIC-8_5.275x5.275mm_P1.27mm; Digi-Key PN SST25VF080B-50-4I-S2AE-T

Connections:
FLASH_SPI_MISO: R2609.2; also elsewhere on the board
FLASH_SPI_MOSI: R2602.2; also elsewhere on the board
FLASH_SPI_SCK: R2603.2; also elsewhere on the board
unnamed: D2601.1 (K), U2601.4
unnamed: D2601.2 (A), R2601.2
unnamed: R2602.1, R2607.1, U2602.5 (SI)
unnamed: R2603.1, R2606.1, U2602.6 (SCK)
unnamed: R2604.1, R2605.2, U2602.1 (~CE)
unnamed: R2608.1, R2609.1, U2602.2 (SO)
~FLASH_SPI_CE2: R2604.2, U2601.1; also elsewhere on the board

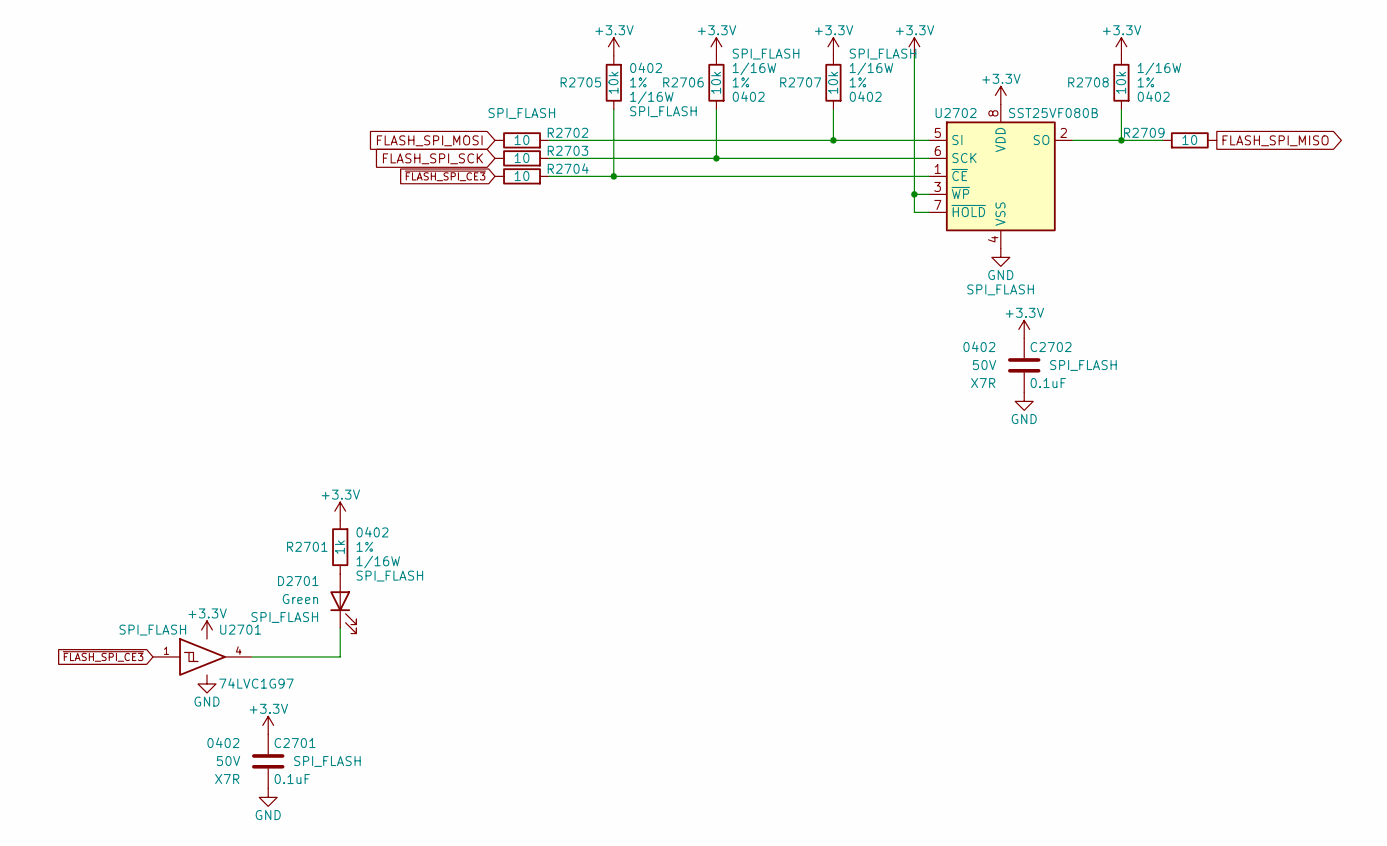
[picture p62: schematic SPI_Flash_3.sch, LED Panel Controller]

Parts:
C2701, C2702: 0.1uF; C_0402; Voltage 50V; Digi-Key PN 490-10698-1-ND
D2701: Green; LED_0402; Digi-Key PN 1497-1219-1-ND
R2701: 1k; R_0402; Tolerance 1%; Digi-Key PN RMCF0402FT1K00CT-ND
R2702, R2703, R2704, R2709: 10; R_0402; Tolerance 1%; Digi-Key PN RMCF0402FT10R0CT-ND
R2705, R2706, R2707, R2708: 10k; R_0402; Tolerance 1%; Digi-Key PN RMCF0402FT10K0CT-ND
U2701: 74LVC1G97; SOT-363_SC-70-6; Digi-Key PN 1727-1772-1-ND
U2702: SST25VF080B; SOIC-8_5.275x5.275mm_P1.27mm; Digi-Key PN SST25VF080B-50-4I-S2AE-T

Connections:
FLASH_SPI_MISO: R2709.2; also elsewhere on the board
FLASH_SPI_MOSI: R2702.2; also elsewhere on the board
FLASH_SPI_SCK: R2703.2; also elsewhere on the board
unnamed: D2701.1 (K), U2701.4
unnamed: D2701.2 (A), R2701.2
unnamed: R2702.1, R2707.1, U2702.5 (SI)
unnamed: R2703.1, R2706.1, U2702.6 (SCK)
unnamed: R2704.1, R2705.2, U2702.1 (~CE)
unnamed: R2708.1, R2709.1, U2702.2 (SO)
~FLASH_SPI_CE3: R2704.2, U2701.1; also elsewhere on the board

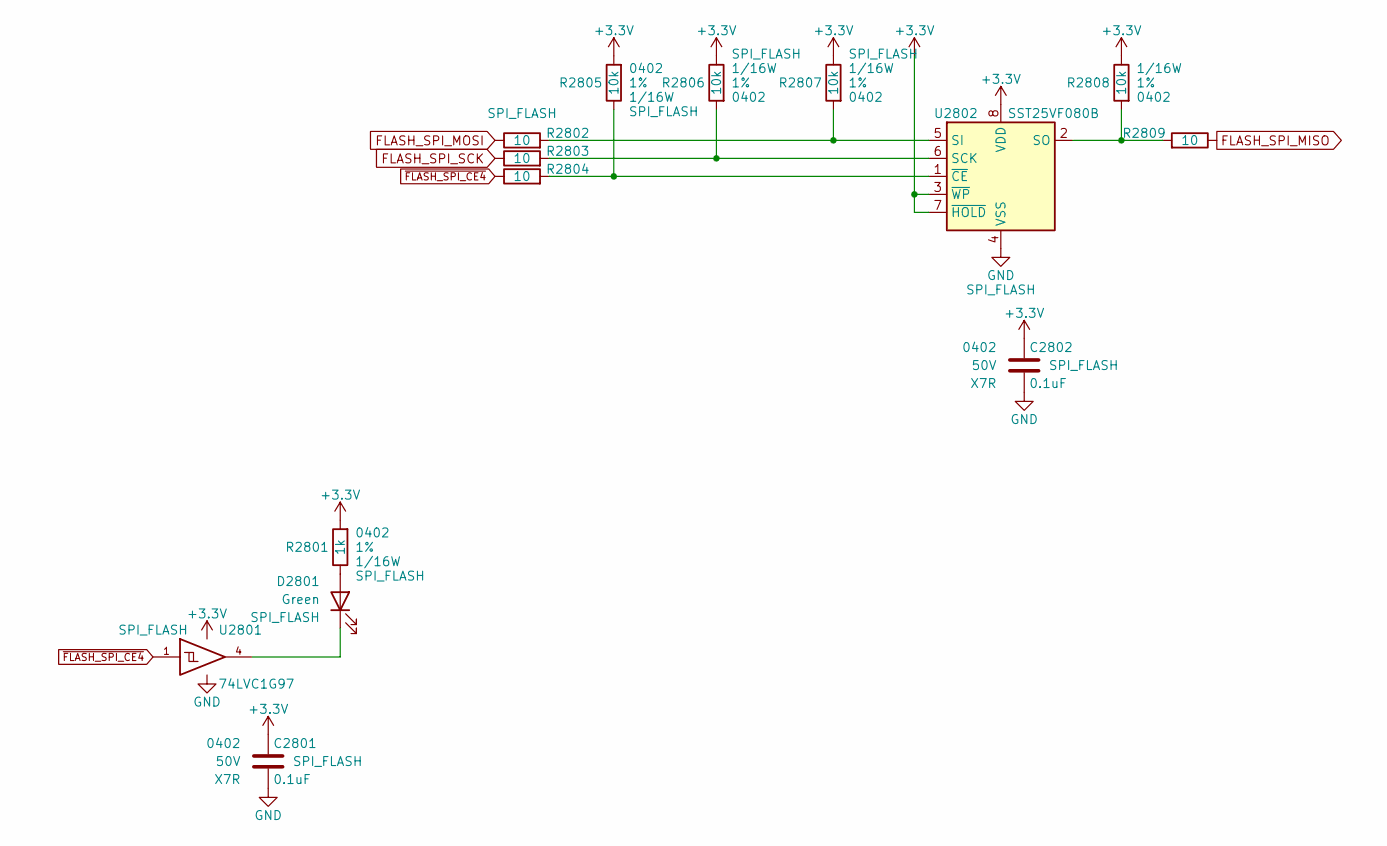
[picture p63: schematic SPI_Flash_4.sch, LED Panel Controller]

Parts:
C2801, C2802: 0.1uF; C_0402; Voltage 50V; Digi-Key PN 490-10698-1-ND
D2801: Green; LED_0402; Digi-Key PN 1497-1219-1-ND
R2801: 1k; R_0402; Tolerance 1%; Digi-Key PN RMCF0402FT1K00CT-ND
R2802, R2803, R2804, R2809: 10; R_0402; Tolerance 1%; Digi-Key PN RMCF0402FT10R0CT-ND
R2805, R2806, R2807, R2808: 10k; R_0402; Tolerance 1%; Digi-Key PN RMCF0402FT10K0CT-ND
U2801: 74LVC1G97; SOT-363_SC-70-6; Digi-Key PN 1727-1772-1-ND
U2802: SST25VF080B; SOIC-8_5.275x5.275mm_P1.27mm; Digi-Key PN SST25VF080B-50-4I-S2AE-T

Connections:
FLASH_SPI_MISO: R2809.2; also elsewhere on the board
FLASH_SPI_MOSI: R2802.2; also elsewhere on the board
FLASH_SPI_SCK: R2803.2; also elsewhere on the board
unnamed: D2801.1 (K), U2801.4
unnamed: D2801.2 (A), R2801.2
unnamed: R2802.1, R2807.1, U2802.5 (SI)
unnamed: R2803.1, R2806.1, U2802.6 (SCK)
unnamed: R2804.1, R2805.2, U2802.1 (~CE)
unnamed: R2808.1, R2809.1, U2802.2 (SO)
~FLASH_SPI_CE4: R2804.2, U2801.1; also elsewhere on the board

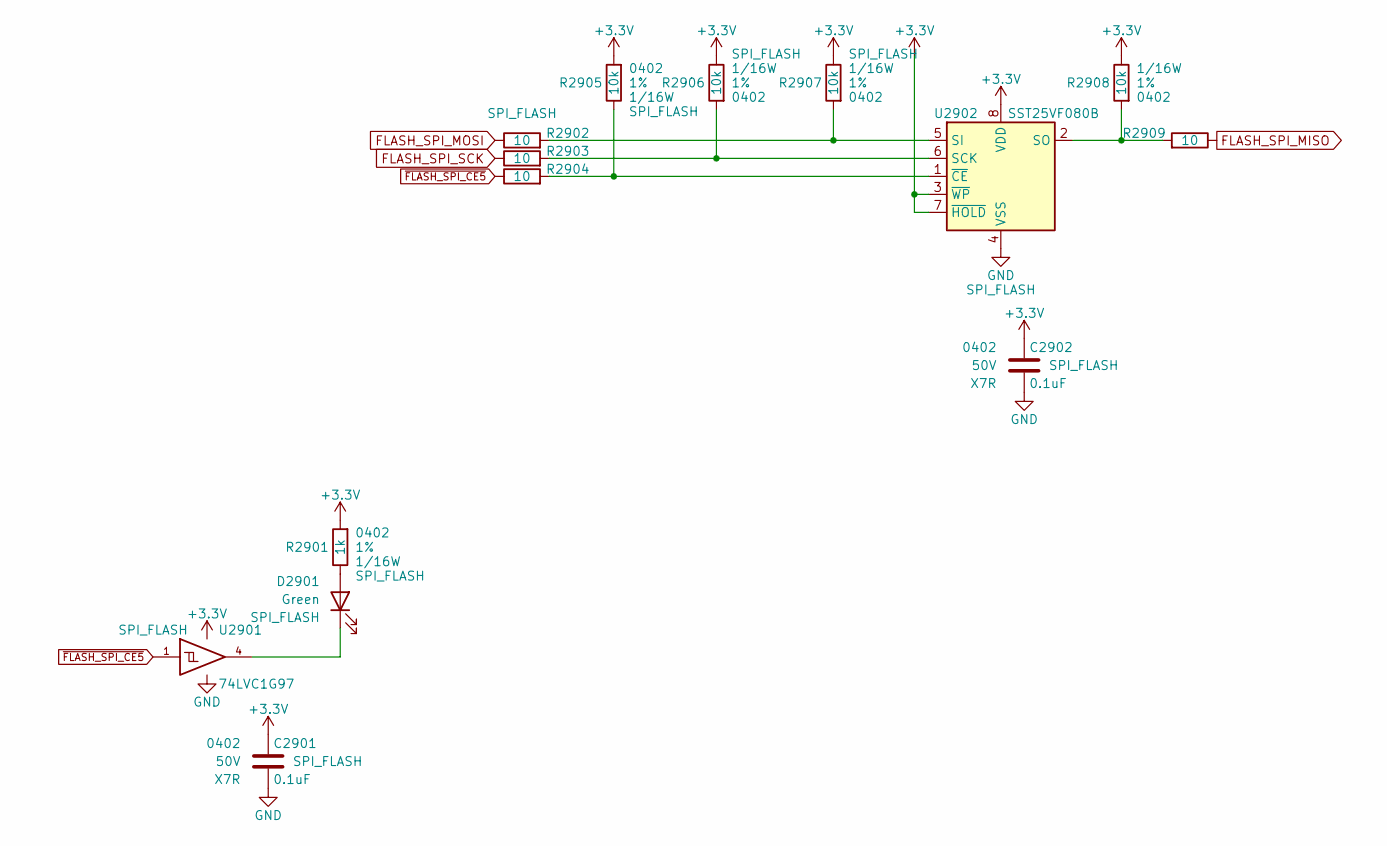
[picture p64: schematic SPI_Flash_5.sch, LED Panel Controller]

Parts:
C2901, C2902: 0.1uF; C_0402; Voltage 50V; Digi-Key PN 490-10698-1-ND
D2901: Green; LED_0402; Digi-Key PN 1497-1219-1-ND
R2901: 1k; R_0402; Tolerance 1%; Digi-Key PN RMCF0402FT1K00CT-ND
R2902, R2903, R2904, R2909: 10; R_0402; Tolerance 1%; Digi-Key PN RMCF0402FT10R0CT-ND
R2905, R2906, R2907, R2908: 10k; R_0402; Tolerance 1%; Digi-Key PN RMCF0402FT10K0CT-ND
U2901: 74LVC1G97; SOT-363_SC-70-6; Digi-Key PN 1727-1772-1-ND
U2902: SST25VF080B; SOIC-8_5.275x5.275mm_P1.27mm; Digi-Key PN SST25VF080B-50-4I-S2AE-T

Connections:
FLASH_SPI_MISO: R2909.2; also elsewhere on the board
FLASH_SPI_MOSI: R2902.2; also elsewhere on the board
FLASH_SPI_SCK: R2903.2; also elsewhere on the board
unnamed: D2901.1 (K), U2901.4
unnamed: D2901.2 (A), R2901.2
unnamed: R2902.1, R2907.1, U2902.5 (SI)
unnamed: R2903.1, R2906.1, U2902.6 (SCK)
unnamed: R2904.1, R2905.2, U2902.1 (~CE)
unnamed: R2908.1, R2909.1, U2902.2 (SO)
~FLASH_SPI_CE5: R2904.2, U2901.1; also elsewhere on the board

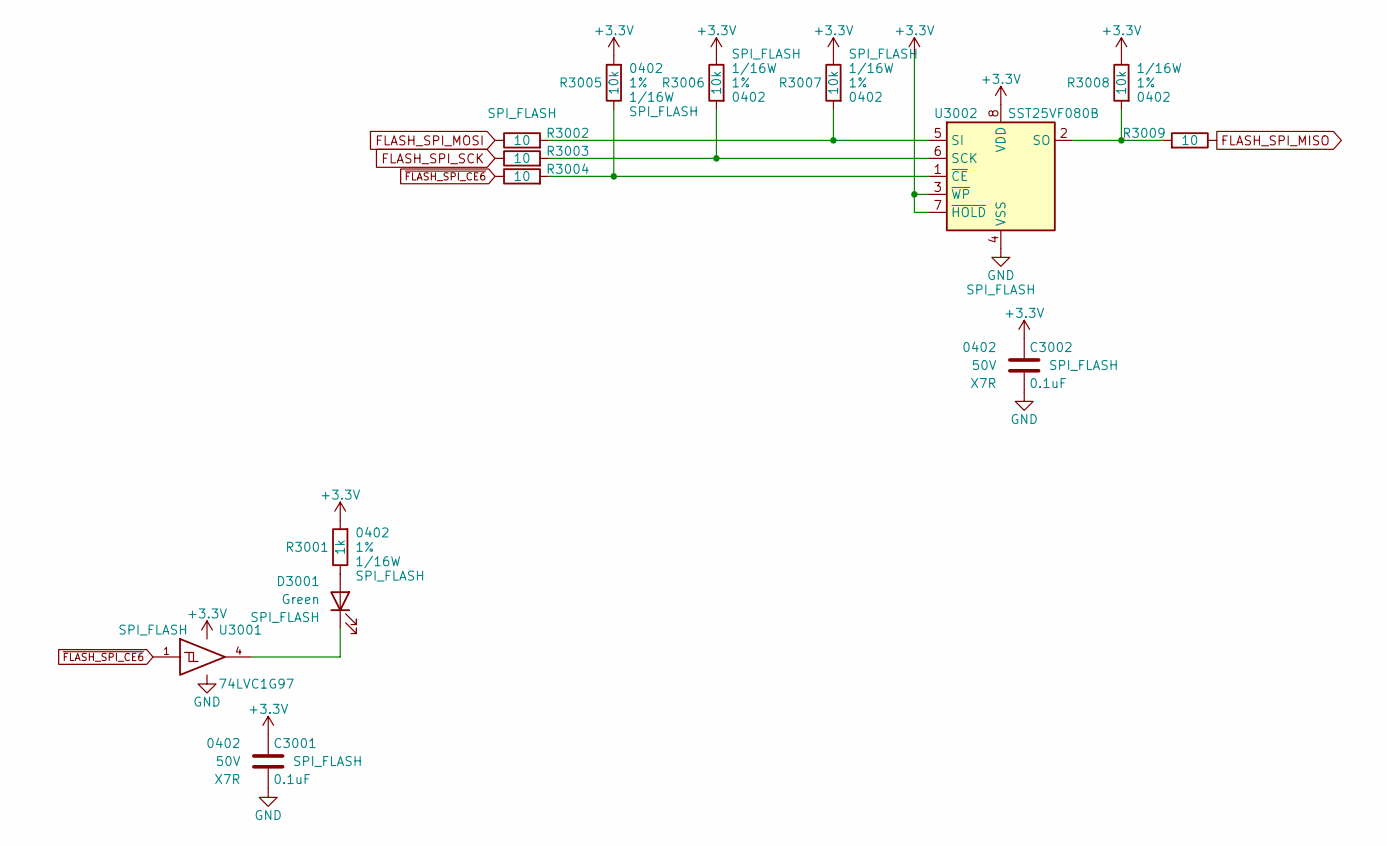
[picture p65: schematic SPI_Flash_6.sch, LED Panel Controller]

Parts:
C3001, C3002: 0.1uF; C_0402; Voltage 50V; Digi-Key PN 490-10698-1-ND
D3001: Green; LED_0402; Digi-Key PN 1497-1219-1-ND
R3001: 1k; R_0402; Tolerance 1%; Digi-Key PN RMCF0402FT1K00CT-ND
R3002, R3003, R3004, R3009: 10; R_0402; Tolerance 1%; Digi-Key PN RMCF0402FT10R0CT-ND
R3005, R3006, R3007, R3008: 10k; R_0402; Tolerance 1%; Digi-Key PN RMCF0402FT10K0CT-ND
U3001: 74LVC1G97; SOT-363_SC-70-6; Digi-Key PN 1727-1772-1-ND
U3002: SST25VF080B; SOIC-8_5.275x5.275mm_P1.27mm; Digi-Key PN SST25VF080B-50-4I-S2AE-T

Connections:
FLASH_SPI_MISO: R3009.2; also elsewhere on the board
FLASH_SPI_MOSI: R3002.2; also elsewhere on the board
FLASH_SPI_SCK: R3003.2; also elsewhere on the board
unnamed: D3001.1 (K), U3001.4
unnamed: D3001.2 (A), R3001.2
unnamed: R3002.1, R3007.1, U3002.5 (SI)
unnamed: R3003.1, R3006.1, U3002.6 (SCK)
unnamed: R3004.1, R3005.2, U3002.1 (~CE)
unnamed: R3008.1, R3009.1, U3002.2 (SO)
~FLASH_SPI_CE6: R3004.2, U3001.1; also elsewhere on the board
