drewsum/LED_Panel_Controller/hdw/LED_Panel_Controller/LED_Panel_Controller.kicad_pcb

## KiCad design hdw/LED_Panel_Controller/LED_Panel_Controller.kicad_pcb (continued)

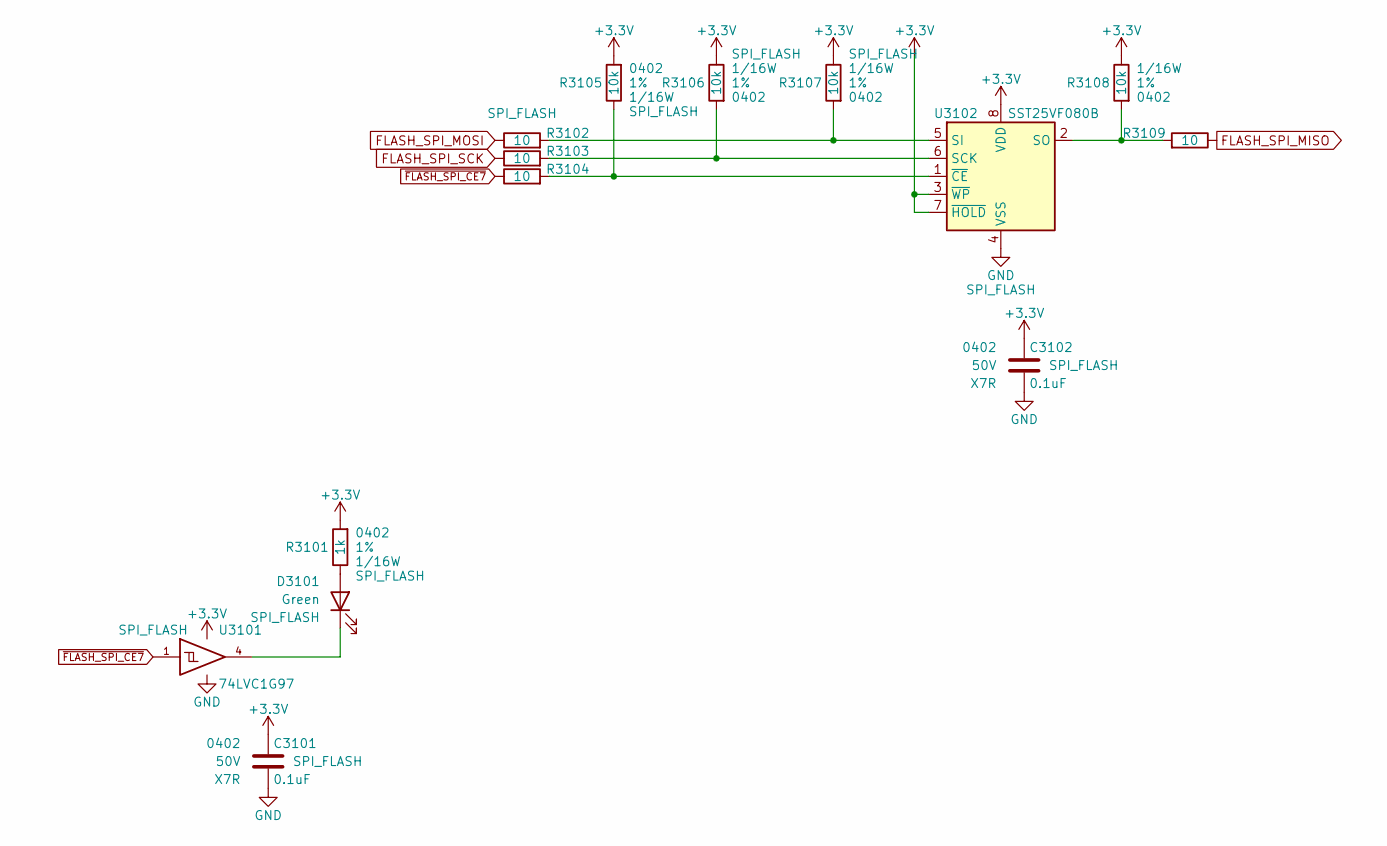
[picture p66: schematic SPI_Flash_7.sch, LED Panel Controller]

Parts:
C3101, C3102: 0.1uF; C_0402; Voltage 50V; Digi-Key PN 490-10698-1-ND
D3101: Green; LED_0402; Digi-Key PN 1497-1219-1-ND
R3101: 1k; R_0402; Tolerance 1%; Digi-Key PN RMCF0402FT1K00CT-ND
R3102, R3103, R3104, R3109: 10; R_0402; Tolerance 1%; Digi-Key PN RMCF0402FT10R0CT-ND
R3105, R3106, R3107, R3108: 10k; R_0402; Tolerance 1%; Digi-Key PN RMCF0402FT10K0CT-ND
U3101: 74LVC1G97; SOT-363_SC-70-6; Digi-Key PN 1727-1772-1-ND
U3102: SST25VF080B; SOIC-8_5.275x5.275mm_P1.27mm; Digi-Key PN SST25VF080B-50-4I-S2AE-T

Connections:
FLASH_SPI_MISO: R3109.2; also elsewhere on the board
FLASH_SPI_MOSI: R3102.2; also elsewhere on the board
FLASH_SPI_SCK: R3103.2; also elsewhere on the board
unnamed: D3101.1 (K), U3101.4
unnamed: D3101.2 (A), R3101.2
unnamed: R3102.1, R3107.1, U3102.5 (SI)
unnamed: R3103.1, R3106.1, U3102.6 (SCK)
unnamed: R3104.1, R3105.2, U3102.1 (~CE)
unnamed: R3108.1, R3109.1, U3102.2 (SO)
~FLASH_SPI_CE7: R3104.2, U3101.1; also elsewhere on the board

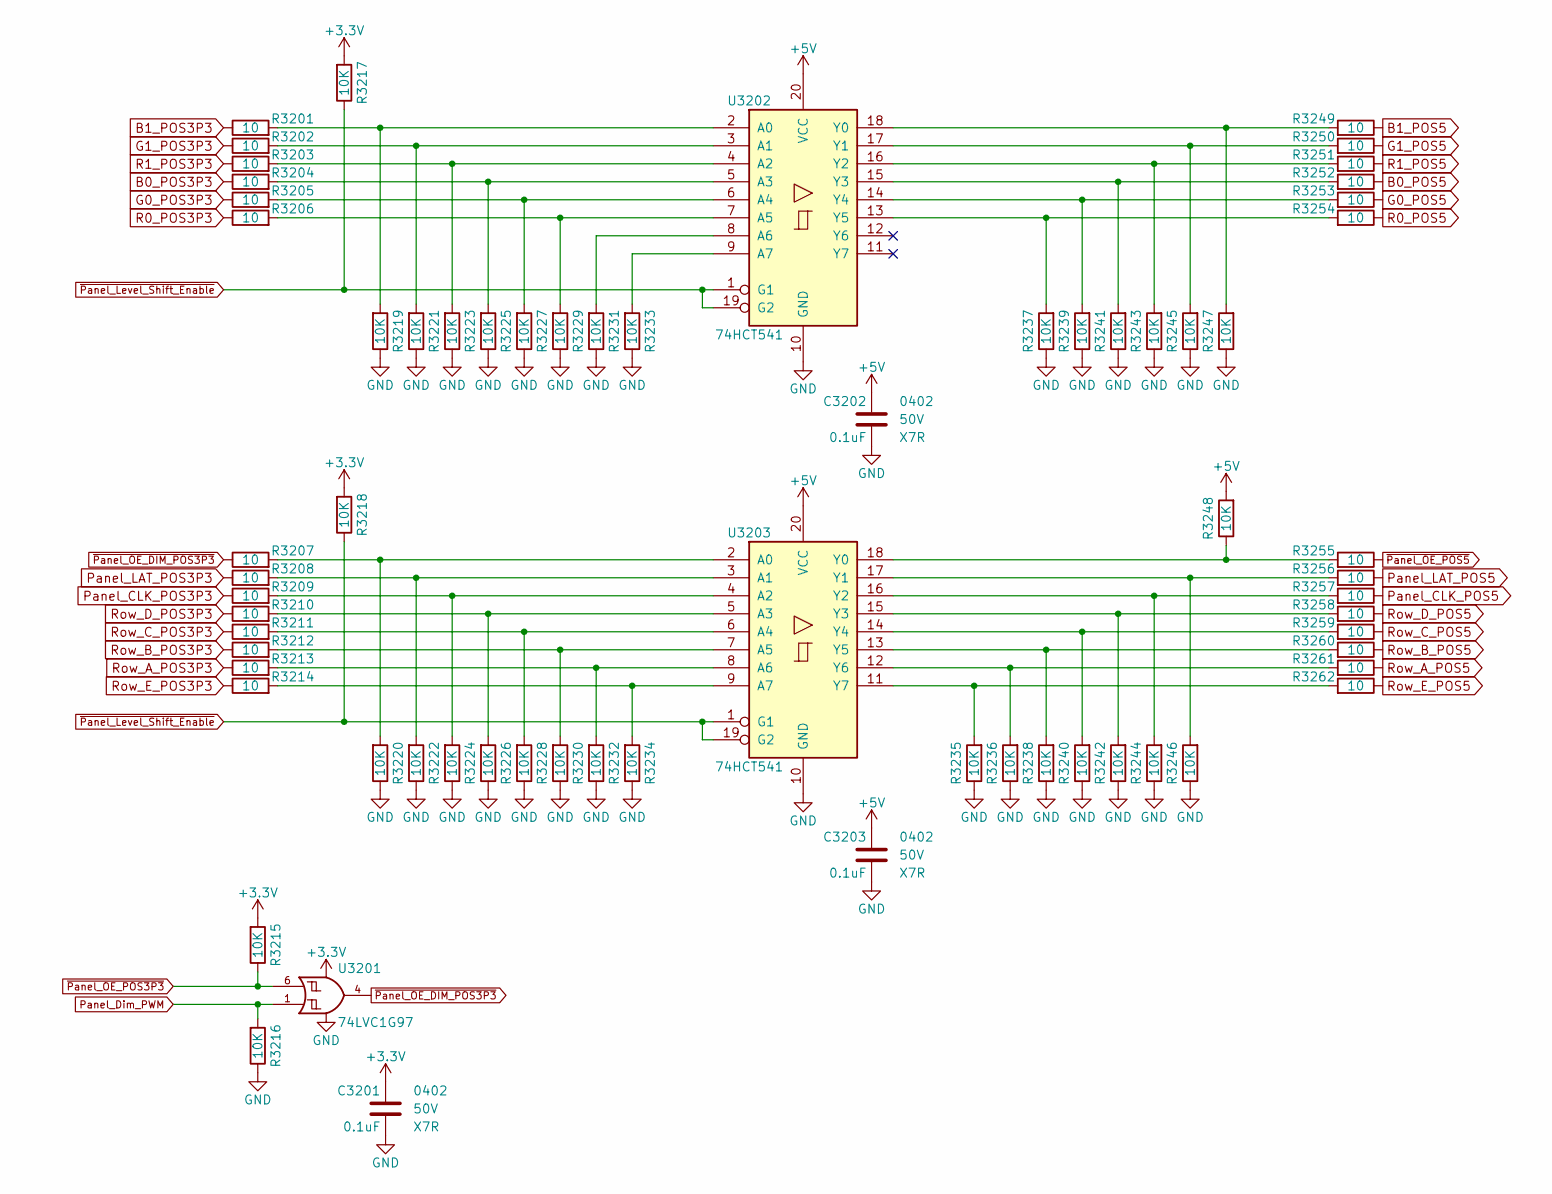
[picture p67: schematic Panel_Level_Shifters.sch, LED Panel Controller]

Parts:
C3201, C3202, C3203: 0.1uF; C_0402; Voltage 50V; Digi-Key PN 490-10698-1-ND
R3201, R3202, R3203, R3204, R3205, R3206, R3207, R3208, R3209, R3210, R3211, R3212, R3213, R3214, R3249, R3250, R3251, R3252, R3253, R3254, R3255, R3256, R3257, R3258, R3259, R3260, R3261, R3262: 10; R_0402; Tolerance 1%; Digi-Key PN RMCF0402FT10R0CT-ND
R3215, R3216, R3217, R3218, R3219, R3220, R3221, R3222, R3223, R3224, R3225, R3226, R3227, R3228, R3229, R3230, R3231, R3232, R3233, R3234, R3235, R3236, R3237, R3238, R3239, R3240, R3241, R3242, R3243, R3244, R3245, R3246, R3247, R3248: 10K; R_0402; Tolerance 1%; Digi-Key PN RMCF0402FT10K0CT-ND
U3201: 74LVC1G97; SOT-363_SC-70-6; Digi-Key PN 1727-1772-1-ND
U3202, U3203: 74HCT541; SSOP-20_4.4x6.5mm_Pitch0.65mm; Digi-Key PN 296-26499-1-ND

Connections:
+5V: C3202.1, C3203.1, R3248.1, U3202.20 (VCC), U3203.20 (VCC); also elsewhere on the board
B0_POS3P3: R3204.2; also elsewhere on the board
B0_POS5: R3252.2; also elsewhere on the board
B1_POS3P3: R3201.2; also elsewhere on the board
B1_POS5: R3249.2; also elsewhere on the board
G0_POS3P3: R3205.2; also elsewhere on the board
G0_POS5: R3253.2; also elsewhere on the board
G1_POS3P3: R3202.2; also elsewhere on the board
G1_POS5: R3250.2; also elsewhere on the board
unnamed: R3201.1, R3219.1, U3202.2 (A0)
unnamed: R3202.1, R3221.1, U3202.3 (A1)
unnamed: R3203.1, R3223.1, U3202.4 (A2)
unnamed: R3204.1, R3225.1, U3202.5 (A3)
unnamed: R3205.1, R3227.1, U3202.6 (A4)
unnamed: R3206.1, R3229.1, U3202.7 (A5)
unnamed: R3207.1, R3220.1, U3203.2 (A0)
unnamed: R3208.1, R3222.1, U3203.3 (A1)
unnamed: R3209.1, R3224.1, U3203.4 (A2)
unnamed: R3210.1, R3226.1, U3203.5 (A3)
unnamed: R3211.1, R3228.1, U3203.6 (A4)
unnamed: R3212.1, R3230.1, U3203.7 (A5)
unnamed: R3213.1, R3232.1, U3203.8 (A6)
unnamed: R3214.1, R3234.1, U3203.9 (A7)
unnamed: R3231.1, U3202.8 (A6)
unnamed: R3233.1, U3202.9 (A7)
unnamed: R3235.1, R3262.1, U3203.11 (Y7)
unnamed: R3236.1, R3261.1, U3203.12 (Y6)
unnamed: R3237.1, R3254.1, U3202.13 (Y5)
unnamed: R3238.1, R3260.1, U3203.13 (Y5)
unnamed: R3239.1, R3253.1, U3202.14 (Y4)
unnamed: R3240.1, R3259.1, U3203.14 (Y4)
unnamed: R3241.1, R3252.1, U3202.15 (Y3)
unnamed: R3242.1, R3258.1, U3203.15 (Y3)
unnamed: R3243.1, R3251.1, U3202.16 (Y2)
unnamed: R3244.1, R3257.1, U3203.16 (Y2)
unnamed: R3245.1, R3250.1, U3202.17 (Y1)
unnamed: R3246.1, R3256.1, U3203.17 (Y1)
unnamed: R3247.1, R3249.1, U3202.18 (Y0)
unnamed: R3248.2, R3255.1, U3203.18 (Y0)
Panel_CLK_POS3P3: R3209.2; also elsewhere on the board
Panel_CLK_POS5: R3257.2; also elsewhere on the board
Panel_Dim_PWM: R3216.1, U3201.1; also elsewhere on the board
Panel_LAT_POS3P3: R3208.2; also elsewhere on the board
Panel_LAT_POS5: R3256.2; also elsewhere on the board
R0_POS3P3: R3206.2; also elsewhere on the board
R0_POS5: R3254.2; also elsewhere on the board
R1_POS3P3: R3203.2; also elsewhere on the board
R1_POS5: R3251.2; also elsewhere on the board
Row_A_POS3P3: R3213.2; also elsewhere on the board
Row_A_POS5: R3261.2; also elsewhere on the board
Row_B_POS3P3: R3212.2; also elsewhere on the board
Row_B_POS5: R3260.2; also elsewhere on the board
Row_C_POS3P3: R3211.2; also elsewhere on the board
Row_C_POS5: R3259.2; also elsewhere on the board
Row_D_POS3P3: R3210.2; also elsewhere on the board
Row_D_POS5: R3258.2; also elsewhere on the board
Row_E_POS3P3: R3214.2; also elsewhere on the board
Row_E_POS5: R3262.2; also elsewhere on the board
~Panel_Level_Shift_Enable: R3217.2, R3218.2, U3202.1 (G1), U3202.19 (G2), U3203.1 (G1), U3203.19 (G2)
~Panel_OE_DIM_POS3P3: R3207.2, U3201.4
~Panel_OE_POS3P3: R3215.2, U3201.6; also elsewhere on the board
~Panel_OE_POS5: R3255.2; also elsewhere on the board

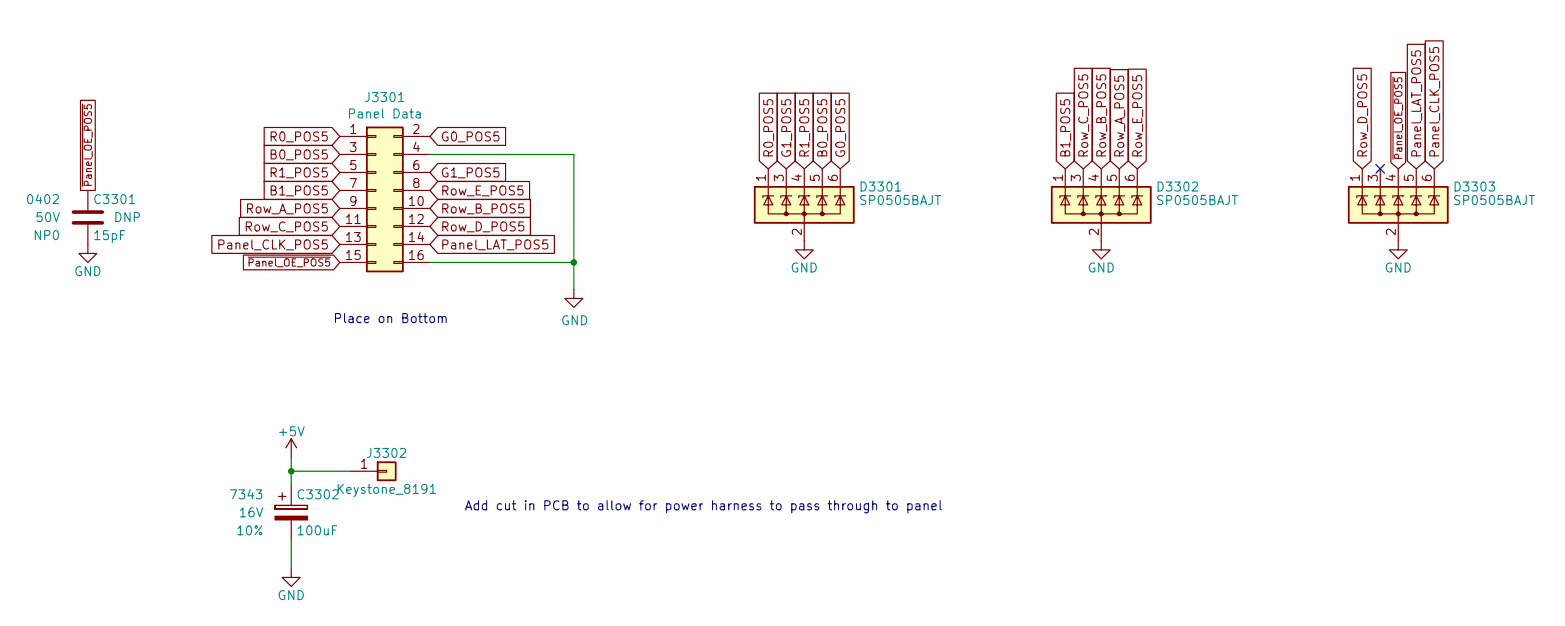
[picture p68: schematic Panel_Connectors.sch, LED Panel Controller]

Parts:
C3301: 15pF; C_0402; Voltage 50V; Digi-Key PN 587-1949-1-ND
C3302: 100uF; CP_Tantalum_Case-X_EIA-7343-43_Reflow; Voltage 16V; Tolerance 10%; Digi-Key PN 718-1102-1-ND
D3301, D3302, D3303: SP0505BAJT; SOT-363_SC-70-6; Digi-Key PN F3160CT-ND
J3301: Panel Data; PinSocket_2x08_P2.54mm_Vertical; Digi-Key PN S9196-ND
J3302: Keystone_8191; Digi-Key PN 36-8191-ND

Connections:
+5V: C3302.1, J3302.1; also elsewhere on the board
B0_POS5: D3301.5 (K), J3301.3; also elsewhere on the board
B1_POS5: D3302.1 (K), J3301.7; also elsewhere on the board
G0_POS5: D3301.6 (K), J3301.2; also elsewhere on the board
G1_POS5: D3301.3 (K), J3301.6; also elsewhere on the board
Panel_CLK_POS5: D3303.6 (K), J3301.13; also elsewhere on the board
Panel_LAT_POS5: D3303.5 (K), J3301.14; also elsewhere on the board
R0_POS5: D3301.1 (K), J3301.1; also elsewhere on the board
R1_POS5: D3301.4 (K), J3301.5; also elsewhere on the board
Row_A_POS5: D3302.5 (K), J3301.9; also elsewhere on the board
Row_B_POS5: D3302.4 (K), J3301.10; also elsewhere on the board
Row_C_POS5: D3302.3 (K), J3301.11; also elsewhere on the board
Row_D_POS5: D3303.1 (K), J3301.12; also elsewhere on the board
Row_E_POS5: D3302.6 (K), J3301.8; also elsewhere on the board
~Panel_OE_POS5: C3301.1, D3303.4 (K), J3301.15; also elsewhere on the board

Notes on the sheet:
Place on Bottom
Add cut in PCB to allow for power harness to pass through to panel

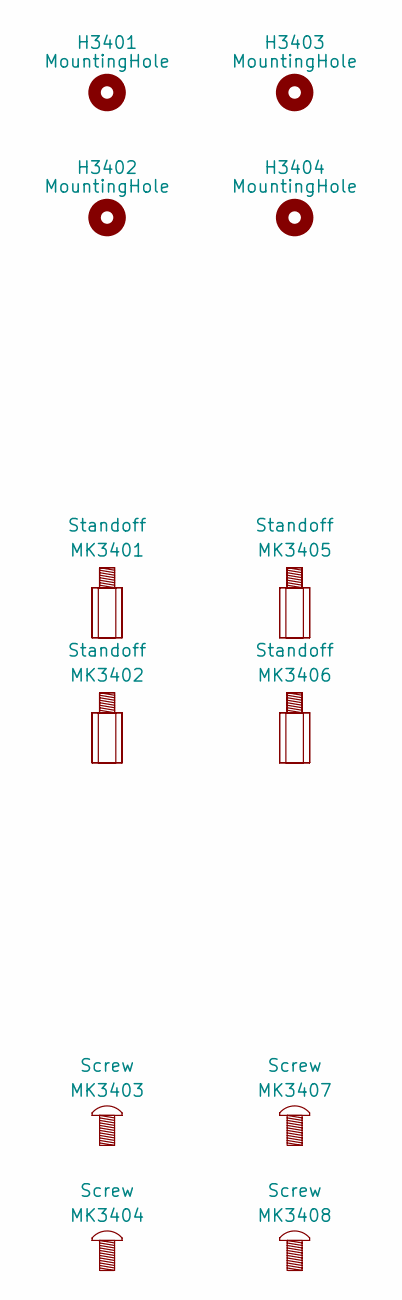
[picture p69: schematic Mechanical.sch, LED Panel Controller]

Parts:
H3401, H3402, H3403, H3404: MountingHole; MountingHole_3mm
MK3401, MK3402, MK3405, MK3406: Standoff; Digi-Key PN 1772-1220-ND
MK3403, MK3404, MK3407, MK3408: Screw; Digi-Key PN 36-9900-ND

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
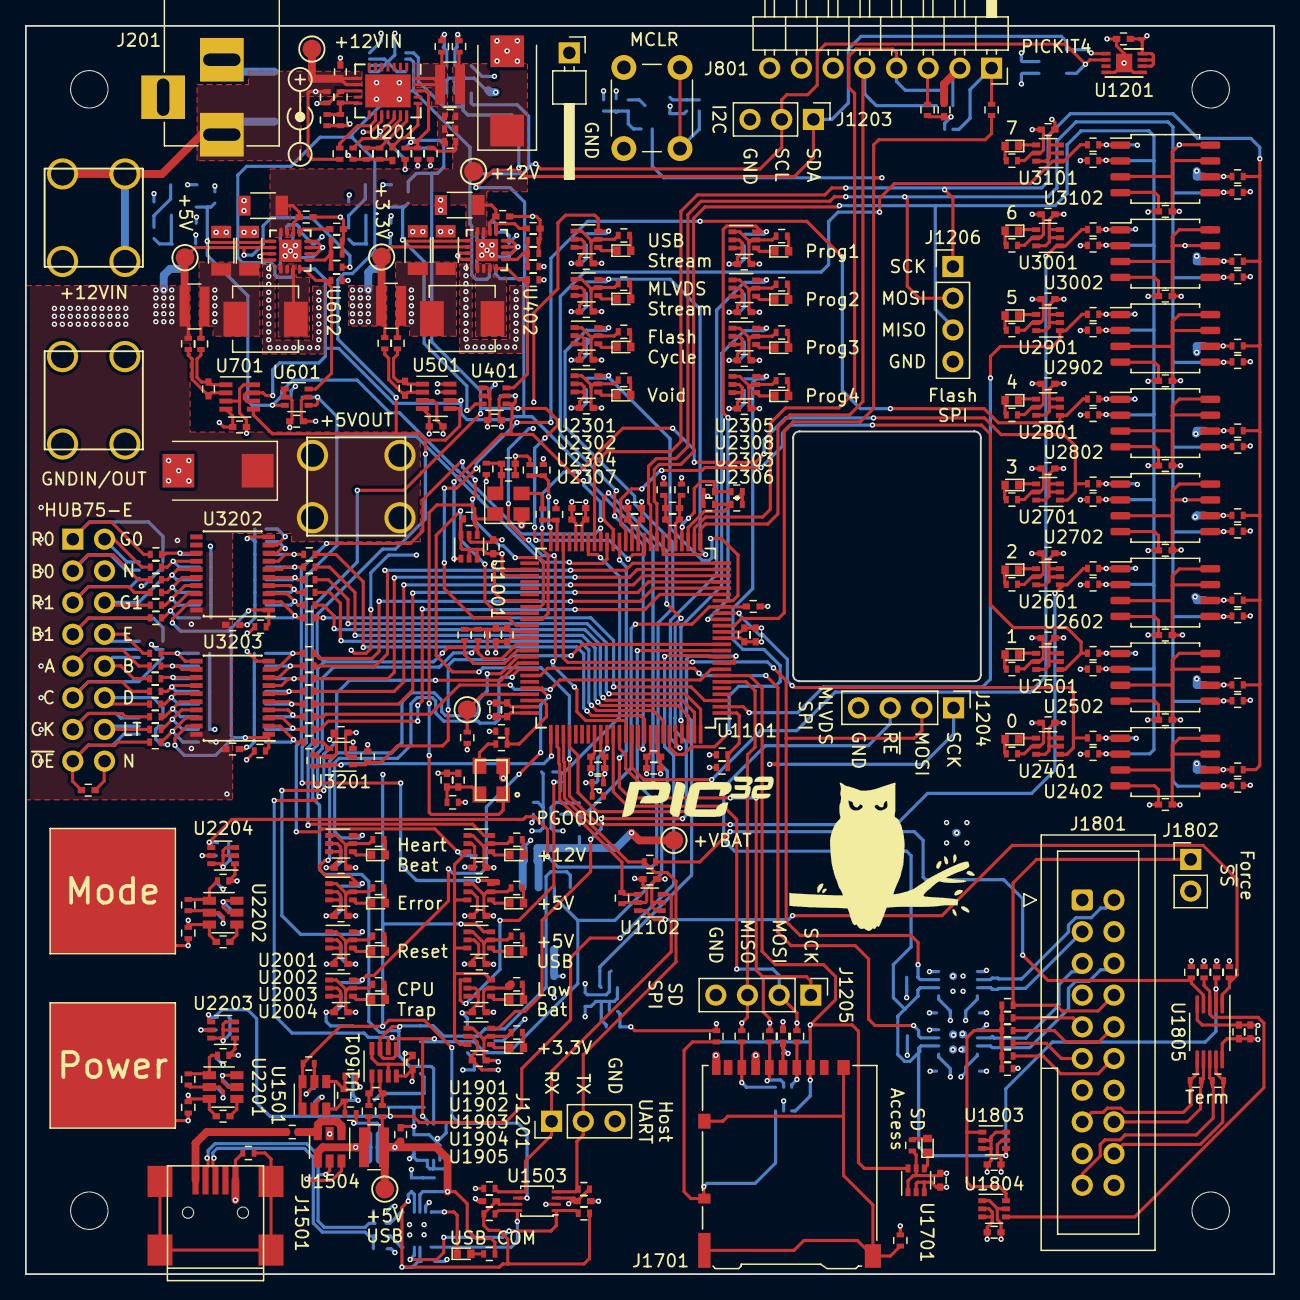
[picture p70: board LED_Panel_Controller.kicad_pcb from above]

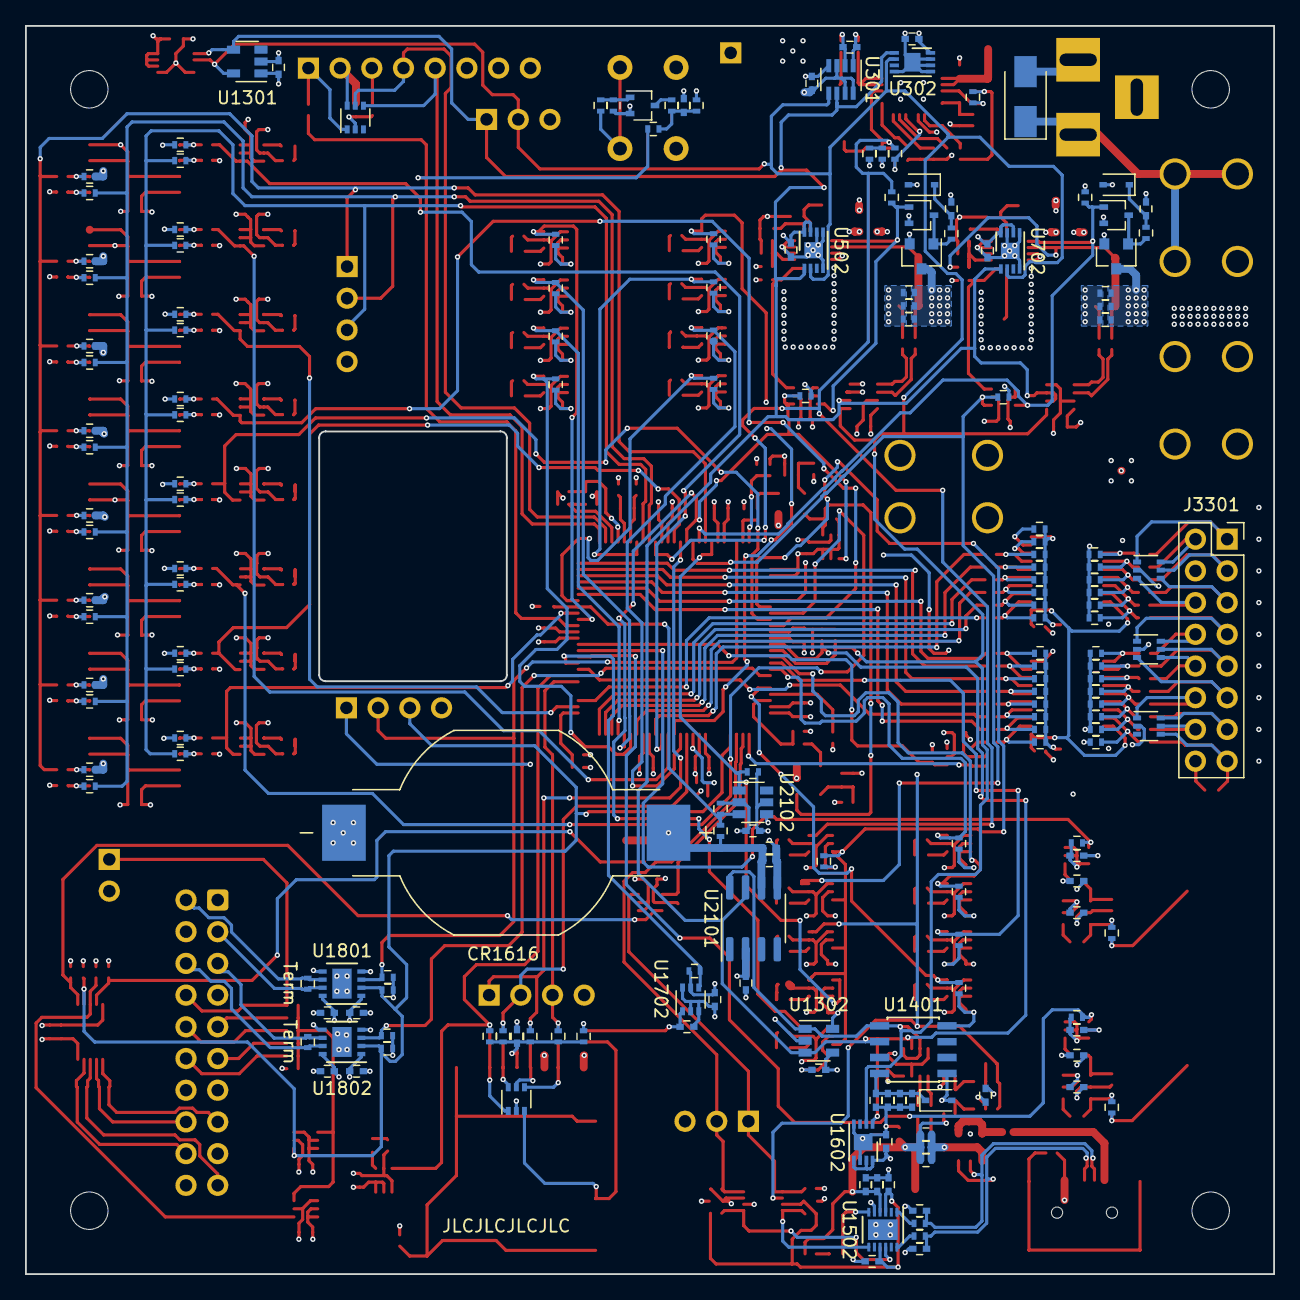
[picture p71: board LED_Panel_Controller.kicad_pcb from below]

Board: 4 copper layers, 100.0 x 100.0 mm, 589 parts (189 on the bottom side), 305 nets.

Other parts of the board:
C1503: 10uF; C_0402
C1504: 0.1uF; C_0402
R1505, R1506, R1508, R1509: 100k; R_0402
R1510, R1517: 10; R_0402
R1511: 0.02; R_0612
R1512, R1513, R1514: 0; R_0402
TP1501: TP; Test_Point
symbol1: Owl_1_Logo
symbol2: PIC32_Logo

Their connections:
+3.3V_USB: R1508.1, R1509.1; also elsewhere on the board
PIC32MZ_UART_RX_BUF: R1508.2; also elsewhere on the board
PIC32MZ_UART_TX_BUF: R1509.2; also elsewhere on the board
POS5_USB_SNS+: R1517.1; also elsewhere on the board
POS5_USB_SNS-: R1510.1; also elsewhere on the board
