drewsum/LED_Panel_Controller/sfw/U1101_firmware/LED_Panel_Controller.X/panel_control.h

/* ************************************************************************** */
/** Descriptive File Name

  @Company
    Company Name

  @File Name
    filename.h

  @Summary
    Brief description of the file.

  @Description
    Describe the purpose of this file.
 */
/* ************************************************************************** */

#ifndef _PANEL_CONTROL_H    /* Guard against multiple inclusion */
#define _PANEL_CONTROL_H

#include <xc.h>

// These are macros needed for defining ISRs, included in XC32
#include <sys/attribs.h>


// this is the raw output data that is fed into the shift registers in the 64x64 LED panel
// meant for HUB75-E interface
// 1byte * 64 cols * 32 rows * 8 color_frames = 16,384 bytes
#define PANEL_DIRECT_DATA_BUFFER_SIZE           16384
volatile __attribute__((coherent)) uint8_t panel_direct_data_buffer[PANEL_DIRECT_DATA_BUFFER_SIZE];
volatile __attribute__((coherent)) uint8_t panel_direct_data_scratchpad[PANEL_DIRECT_DATA_BUFFER_SIZE];

// this structure holds variables needed for drawing images on the panel
// PMP and DMA handle shifting data into panel for 64 columms
// code must set the row
// Since pixels can only draw RGB colors, 8 color_frames can be drawn to
// get better color resolution
volatile __attribute__((coherent)) struct panel_data_vars_t {
    
    uint8_t current_row;            // which row is currently selected (0 to 32)
    uint8_t current_color_frame;    // which color frame is currently being drawn (0 to 7)
    
} panel_data_vars;

// this function sets up PMP for use with an 8 bit LCD
void PMPInitialize(void);

// This ISR is triggered when a PMP error occurs
void __ISR(_PMP_ERROR_VECTOR, IPL1SRS) pmpErrorISR(void);

// this function prints status for parallel master port
void printPMPStatus(void);

// this function sets up panel drive DMA
void panelDriveDMAInitialize(void);

// This interrupt is triggered after shifting 64 bytes into panel
void __ISR(_DMA2_VECTOR, IPL3SRS) panelDriveDMAFinsihedISR(void);

// This function initializes Timer5 for panel multiplexing
void panelMultiplexingTimerInitialize(void);

// Start muxing timer function
void panelMultiplexingTimerStart(void);

// Stpo muxing timer function
void panelMultiplexingTimerStop(void);

// Clear muxing timer function
void panelMultiplexingTimerClear(void);

// Function for multiplexing timer ISR
void __ISR(_TIMER_5_VECTOR, IPL3SRS) panelMultiplexingTimerISR(void);

// this function sets up PMP, DMA, and multiplexing timers
void LEDPanelInitialize(void);

// this function enables the +5V power supply, clears the PMP buffer, and begins multiplexing
void LEDPanelSetup(void);

// this function disables the +5V power supply and stops multiplexing
void LEDPanelTeardown(void);

// This function prints the contents of the internal RAM buffer holding frame data
void panelDirectDataBufferPrint(void);

// This function initializes output compare 3 for dimming the display
void panelPWMInitialize(void);

// This function sets panel brightness
// Pass an integer between 0 and 100
// Larger numbers correspond to a brighter display
void panelPWMSetBrightness(uint8_t set_brightness);

// this function copies data from scratchpad into direct data buffer
void panelDataCopyScratchpad(void);

// This function prints the contents of the internal RAM buffer holding frame data scratchpad
void panelScratchpadPrint(void);

#endif /* _PANEL_CONTROL_H */

/* *****************************************************************************
 End of File
 */
