drewsum/LED_Panel_Controller/(commit log)

2020-09-09 Started schematic
    [Backup_RTC.sch, I2C_Boost.sch, LED_Panel_Controller.kicad_pcb, LED_Panel_Controller.sch, Mechanical.sch, Mode_LEDs.sch, PGOOD_LEDs.sch, PIC32MZ.sch]
2020-09-09 Added todo list item
    [LED_Panel_Controller.sch]
2020-09-20 Many sch updates
    [I2C_Boost.sch, LED_Panel_Controller.sch, Mechanical.sch, PGOOD_LEDs.sch, PIC32MZ_Bypass.sch, POS12_Input.sch, POS5_Power_Supply.sch, Panel_Connectors.sch]
2020-09-20 log's first
    [Backup_RTC.sch, I2C_Boost.sch, LED_Panel_Controller.sch, Mechanical.sch, Mode_LEDs.sch, PGOOD_LEDs.sch, PIC32MZ.sch, PIC32MZ_Bypass.sch]
2020-10-04 reworked some USB stuff
    [Backup_RTC.sch, I2C_Boost.sch, LED_Panel_Controller.sch, Mechanical.sch, Mode_LEDs.sch, PGOOD_LEDs.sch, PIC32MZ.sch, PIC32MZ_Bypass.sch]
2020-10-06 USB bridge sheet work
    [Backup_RTC.sch, USB_UART_Bridge.sch]
2020-12-24 lots of schematic progress
    [Backup_RTC.sch, I2C_Boost.sch, LED_Panel_Controller.sch, Mechanical.sch, Mode_LEDs.sch, PGOOD_LEDs.sch, PIC32MZ.sch, PIC32MZ_Bypass.sch]
2021-02-01 made a lot more schematic progress
    [Backup_RTC.sch, I2C_Boost.sch, LED_Panel_Controller.sch, Mode_LEDs.sch, PIC32MZ_Clocking.sch, POS12_Input.sch, POS3P3_Power_Supply.sch, POS5_Power_Supply.sch]
2021-02-01 fixed level shifter sheet
    [LED_Panel_Controller.sch, POS12_Input.sch, POS12_Telemetry.sch, POS3P3_Telemetry.sch, POS5_Telemetry.sch, Panel_Level_Shifters.sch, USB_Telemetry.sch]
2021-02-01 lots of MCU pin assignments
    [LED_Panel_Controller.sch, PIC32MZ.sch, SPI_Flash_0.sch, USB_UART_Bridge.sch]
2021-02-02 more schematic progress
    [Panel_Connectors.sch, Panel_Level_Shifters.sch, USB_UART_Bridge.sch, WiFi_Module.sch]
2021-02-03 assigned a lot of nets to MCU pins
    [I2C_Boost.sch, Mode_LEDs.sch, PIC32MZ.sch, SD_Card_Slot.sch, WiFi_Module.sch]
2021-02-07 added some test points, ambient temp sensor
    [config_hardstraps.sch]
2021-03-24 Added panel dimming OR gate
    [PIC32MZ.sch, Panel_Level_Shifters.sch]
2021-03-25 more schematic development
    [Backup_RTC.sch, I2C_Boost.sch, LED_Panel_Controller.sch, Mechanical.sch, Mode_LEDs.sch, PGOOD_LEDs.sch, PIC32MZ.sch, PIC32MZ_Bypass.sch]
2021-03-31 added digikey pns, footprints, bom scrubbed
    [Backup_RTC.sch, I2C_Boost.sch, Mechanical.sch, Mode_LEDs.sch, PGOOD_LEDs.sch, PIC32MZ_Bypass.sch, PIC32MZ_Clocking.sch, PIC32MZ_Programming.sch]
2021-03-31 assigned I2C addresses
    [Backup_RTC.sch, I2C_Boost.sch, Mechanical.sch, Mode_LEDs.sch, PGOOD_LEDs.sch, PIC32MZ.sch, PIC32MZ_Bypass.sch, PIC32MZ_Clocking.sch]
2021-03-31 ran erc, annotated schematic, added hardstraps to MCU
    [Mode_LEDs.sch, PIC32MZ.sch, Panel_Connectors.sch, USB_UART_Bridge.sch]
2021-04-01 reviewed schematic
    [Backup_RTC.sch, I2C_Boost.sch, LED_Panel_Controller.sch, Mechanical.sch, Mode_LEDs.sch, PGOOD_LEDs.sch, PIC32MZ.sch, PIC32MZ_Bypass.sch]
2021-04-01 imported netlist to PCB
    [LED_Panel_Controller.kicad_pcb]
2021-04-01 design rules, hide passive refdes
    [LED_Panel_Controller.kicad_pcb]
2021-04-01 separated function groups on PCB
    [I2C_Boost.sch, LED_Panel_Controller.kicad_pcb, PIC32MZ_Bypass.sch, WiFi_Module.sch]
2021-04-01 some SPI Flash placement
    [LED_Panel_Controller.kicad_pcb]
2021-04-01 more serial flash layout
    [LED_Panel_Controller.kicad_pcb]
2021-04-02 fixed SPI flash pull resistors, more PCB placement
    [LED_Panel_Controller.kicad_pcb, PIC32MZ_Programming.sch, SPI_Flash_0.sch, SPI_Flash_1.sch, SPI_Flash_2.sch, SPI_Flash_3.sch, SPI_Flash_4.sch, SPI_Flash_5.sch]
2021-04-09 more PCB grouping, fanout optimization
    [LED_Panel_Controller.kicad_pcb, SD_Card_Slot.sch]
2021-04-09 more PCB grouping
    [LED_Panel_Controller.kicad_pcb]
2021-04-14 USB/power PCB grouping
    [LED_Panel_Controller.kicad_pcb, POS3P3_Power_Supply.sch, USB_UART_Bridge.sch]
2021-04-14 LED PCB grouping
    [LED_Panel_Controller.kicad_pcb]
2021-04-14 finished pcb grouping by sheet
    [LED_Panel_Controller.kicad_pcb, Panel_Connectors.sch]
2021-04-15 established board outline for connector cutout
    [LED_Panel_Controller.kicad_pcb]
2021-04-15 optimized panel signal level shifter signal locations
    [LED_Panel_Controller.kicad_pcb, Panel_Level_Shifters.sch]
2021-04-15 arranging major PCB functional blocks
    [LED_Panel_Controller.kicad_pcb]
2021-04-15 more major PCB functional blocks
    [LED_Panel_Controller.kicad_pcb]
2021-04-15 PCB function blocks taking shape
    [LED_Panel_Controller.kicad_pcb, Panel_Connectors.sch]
2021-04-16 refined power cable hole cutout location
    [LED_Panel_Controller.kicad_pcb]
2021-04-16 finished arranging functional blocks on PCB
    [LED_Panel_Controller.kicad_pcb, Panel_Level_Shifters.sch, config_hardstraps.sch]
2021-05-05 started routing PCB
    [LED_Panel_Controller.kicad_pcb]
2021-05-07 much more PCB layout
    [LED_Panel_Controller.kicad_pcb]
2021-05-08 much more PCH progress, added SW node guard rings
    [LED_Panel_Controller.kicad_pcb]
2021-05-13 restructured SPI FLASH layout/placement
    [LED_Panel_Controller.kicad_pcb]
2021-05-13 starting to route sensitive signal nets
    [LED_Panel_Controller.kicad_pcb]
2021-05-13 more sensitive routes
    [LED_Panel_Controller.kicad_pcb]
2021-05-22 more manual routing
    [LED_Panel_Controller.kicad_pcb]
2021-05-29 having a mid-project crisis
    [LED_Panel_Controller.kicad_pcb, LED_Panel_Controller.sch, MLVDS_Port.sch, Mode_LEDs.sch, PIC32MZ.sch, USB_UART_Bridge.sch, WiFi_Module.sch, config_hardstraps.sch]
2021-05-30 reworked schematic to use MLVDS connector instead of wifi module
    [Backup_RTC.sch, I2C_Boost.sch, LED_Panel_Controller.sch, MLVDS_Port.sch, Mechanical.sch, Mode_LEDs.sch, PGOOD_LEDs.sch, PIC32MZ.sch]
2021-05-30 pulled MLVDS port into PCB
    [LED_Panel_Controller.kicad_pcb]
2021-05-31 started PCB grouping for multidrop expansion port
    [LED_Panel_Controller.kicad_pcb, MLVDS_Port.sch]
2021-06-04 arranged more parts on PCB
    [LED_Panel_Controller.kicad_pcb, MLVDS_Port.sch, USB_UART_Bridge.sch]
2021-06-05 completed more routing, pre autorouter
    [LED_Panel_Controller.kicad_pcb]
2021-06-05 routded diff pairs, other critical nets
    [LED_Panel_Controller.kicad_pcb]
2021-06-05 going into autorouter
    [LED_Panel_Controller.kicad_pcb]
2021-06-05 ran autorouter
    [LED_Panel_Controller.kicad_pcb]
2021-06-05 got unroutes to 0
    [LED_Panel_Controller.kicad_pcb]
2021-06-05 lots of autoroute cleanups
    [LED_Panel_Controller.kicad_pcb]
2021-06-05 more cleanup
    [LED_Panel_Controller.kicad_pcb]
2021-06-08 lots of cleanup, DRC
    [LED_Panel_Controller.kicad_pcb]
2021-06-08 added some more digikey part numbers to schematic
    [MLVDS_Port.sch, PIC32MZ.sch]
2021-06-09 added BOMs, some consolidation
    [Backup_RTC.sch, I2C_Boost.sch, LED_Panel_Controller_bom_base.xlsx, LED_Panel_Controller_bom_development.xlsx, MLVDS_Port.sch, Mode_LEDs.sch, PGOOD_LEDs.sch, PIC32MZ.sch]
2021-06-11 final hardware commit
    [LED_Panel_Controller.kicad_pcb]
2021-06-12 removed unneeded schematic file
    [WiFi_Module.sch]
2021-06-12 created panel control board firmware
2021-06-12 added lots of core firmware modules
    [configuration.h]
2021-06-12 added pin macros
2021-06-17 added PPS pin map assignment code
2021-07-15 fixed POSC clocking setup issue
    [device_control.c, main.c]
2021-07-16 got USB UART working, corrected clocking
    [device_control.c, main.c]
2021-07-16 added main.h, USB UART bridge flash image
2021-07-16 added cause of reset, prefetch
    [cause_of_reset.c, cause_of_reset.h, main.c, prefetch.c]
2021-07-16 added I2C master code, switched to optimization level 1
2021-07-19 copied over I2C telemetry code
2021-07-19 added ADC code
2021-07-20 added basic code to enable/disable +5V power supply
2021-07-22 added some PMP DMA code, untested
2021-07-22 added multiplexing on-time timer code, still all untested
2021-07-24 got panel multiplexing working properly with PMP and DMA
2021-07-27 corrected PMP DMA source register selection, added random image code
    [device_control.c, generic_buffer_fills.c, generic_buffer_fills.h, main.c, panel_control.c]
2021-08-05 added gamma correction code in conversion script
    [panel_direct_data_converter.py, splash_screen.h]
2021-08-05 gamma correction bug fixes
    [panel_direct_data_converter.py, splash_screen.h]
2021-08-06 fixed telemetry bug that would bog down CPU while multiplexing is enabled
    [heartbeat_services.c, panel_direct_data_converter.py, splash_screen.h]
2021-08-06 added code to turn LE Ddisplay on and off with power button press
2021-08-11 added MCU periheral map spreadsheet, more USB data transfer code
    [Microcontroller_Peripheral_Map.xlsx]
2021-08-11 got basic python serial data flow working
2021-08-12 fixed MCU firmware bug that causes received serial images to get corrupted
    [panel_direct_data_converter.py]
2021-08-13 added support for I2C EEPROM
    [Microcontroller_Peripheral_Map.xlsx]
2021-08-14 got basic SPI Flash code working
2021-08-15 got SPI Flash storage working
2021-08-15 got image slot abstraction working for spi flash
2021-08-21 got slot tracking working
2022-06-19 added basic code for external spi flash slideshows
2022-07-04 added mode leds
2022-07-04 added DMA transfer for coping scratchpad to buffer
2022-07-04 fixed scratchpad DMA bug
    [panel_control.c]
2022-12-10 made power button actually do something
2022-12-10 got mode button working
2022-12-10 spotify script bug fixes
    [spotify_artwork.py]
